lafehubert/electronics/README.md

# electronics
A place for info and code relating to my electronics projects
