lafehubert/electronics/ya4b/README.md

Here be schematics and PCB designs for YA4B, the 4-bit computer I'm designing.

I use KiCad (https://www.kicad-pcb.org/) for the designs, and an Arduino Mega 2560 to run the test code.
