lafehubert/electronics/ya4b/address-register/address-register-bank/address-register-bank.pdf

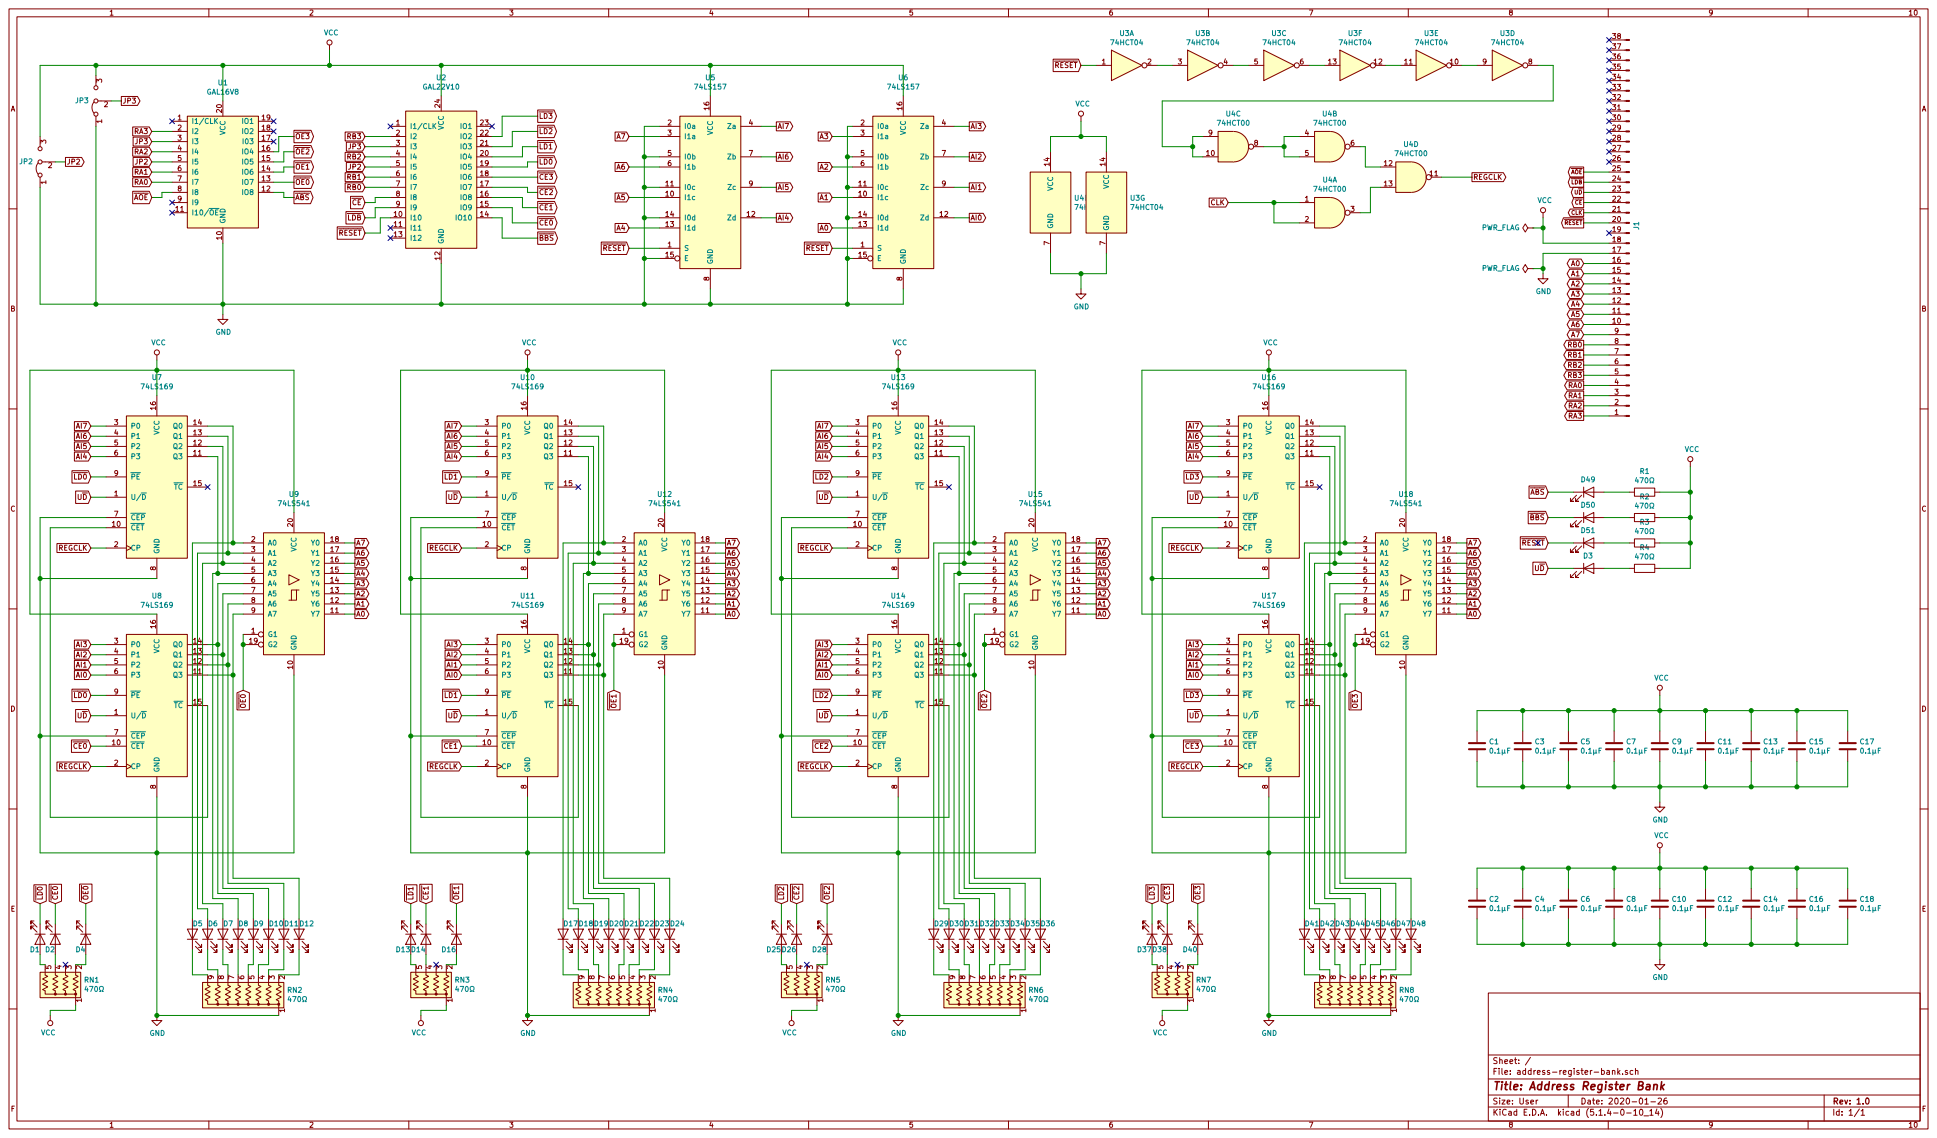
[picture p1: page 1]

File: address-register-bank.sch Sheet: / GND 10 VCC 20

Id: 1/1 Title: Address Register Bank
