lafehubert/electronics/ya4b/alu/designs/74LS382/ya4b-alu/ya4b-alu.kicad_pcb

## KiCad design ya4b/alu/designs/74LS382/ya4b-alu/ya4b-alu.kicad_pcb (2022-01-08)

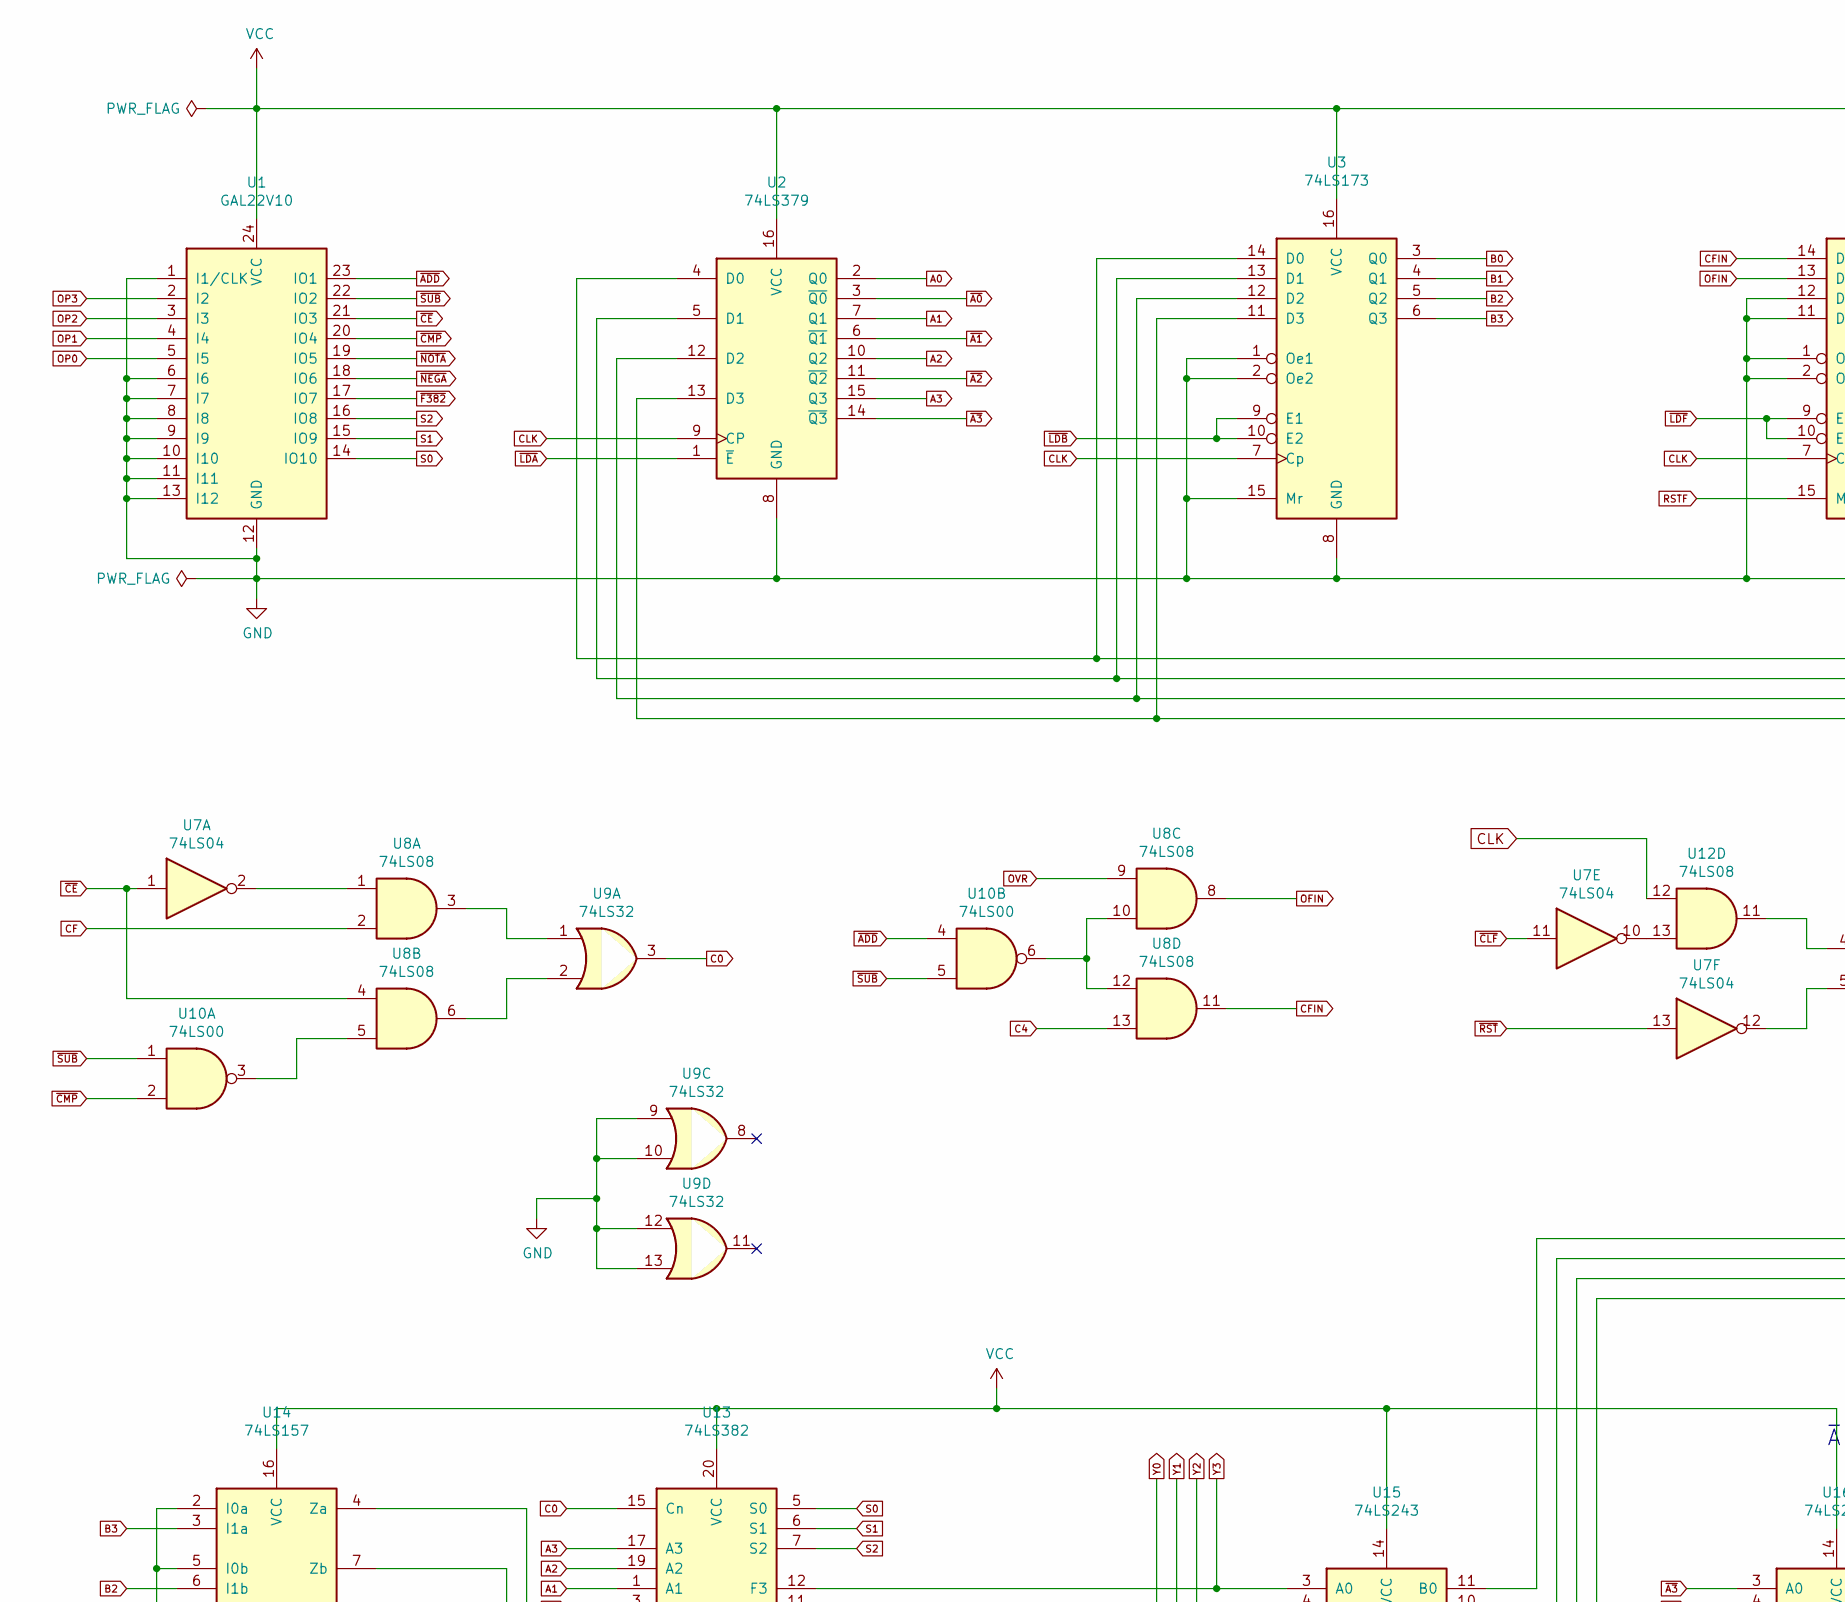
[picture p2: schematic ya4b-alu.sch, Ya4b Arithmetic Logic Unit, part in row 1, column 1]

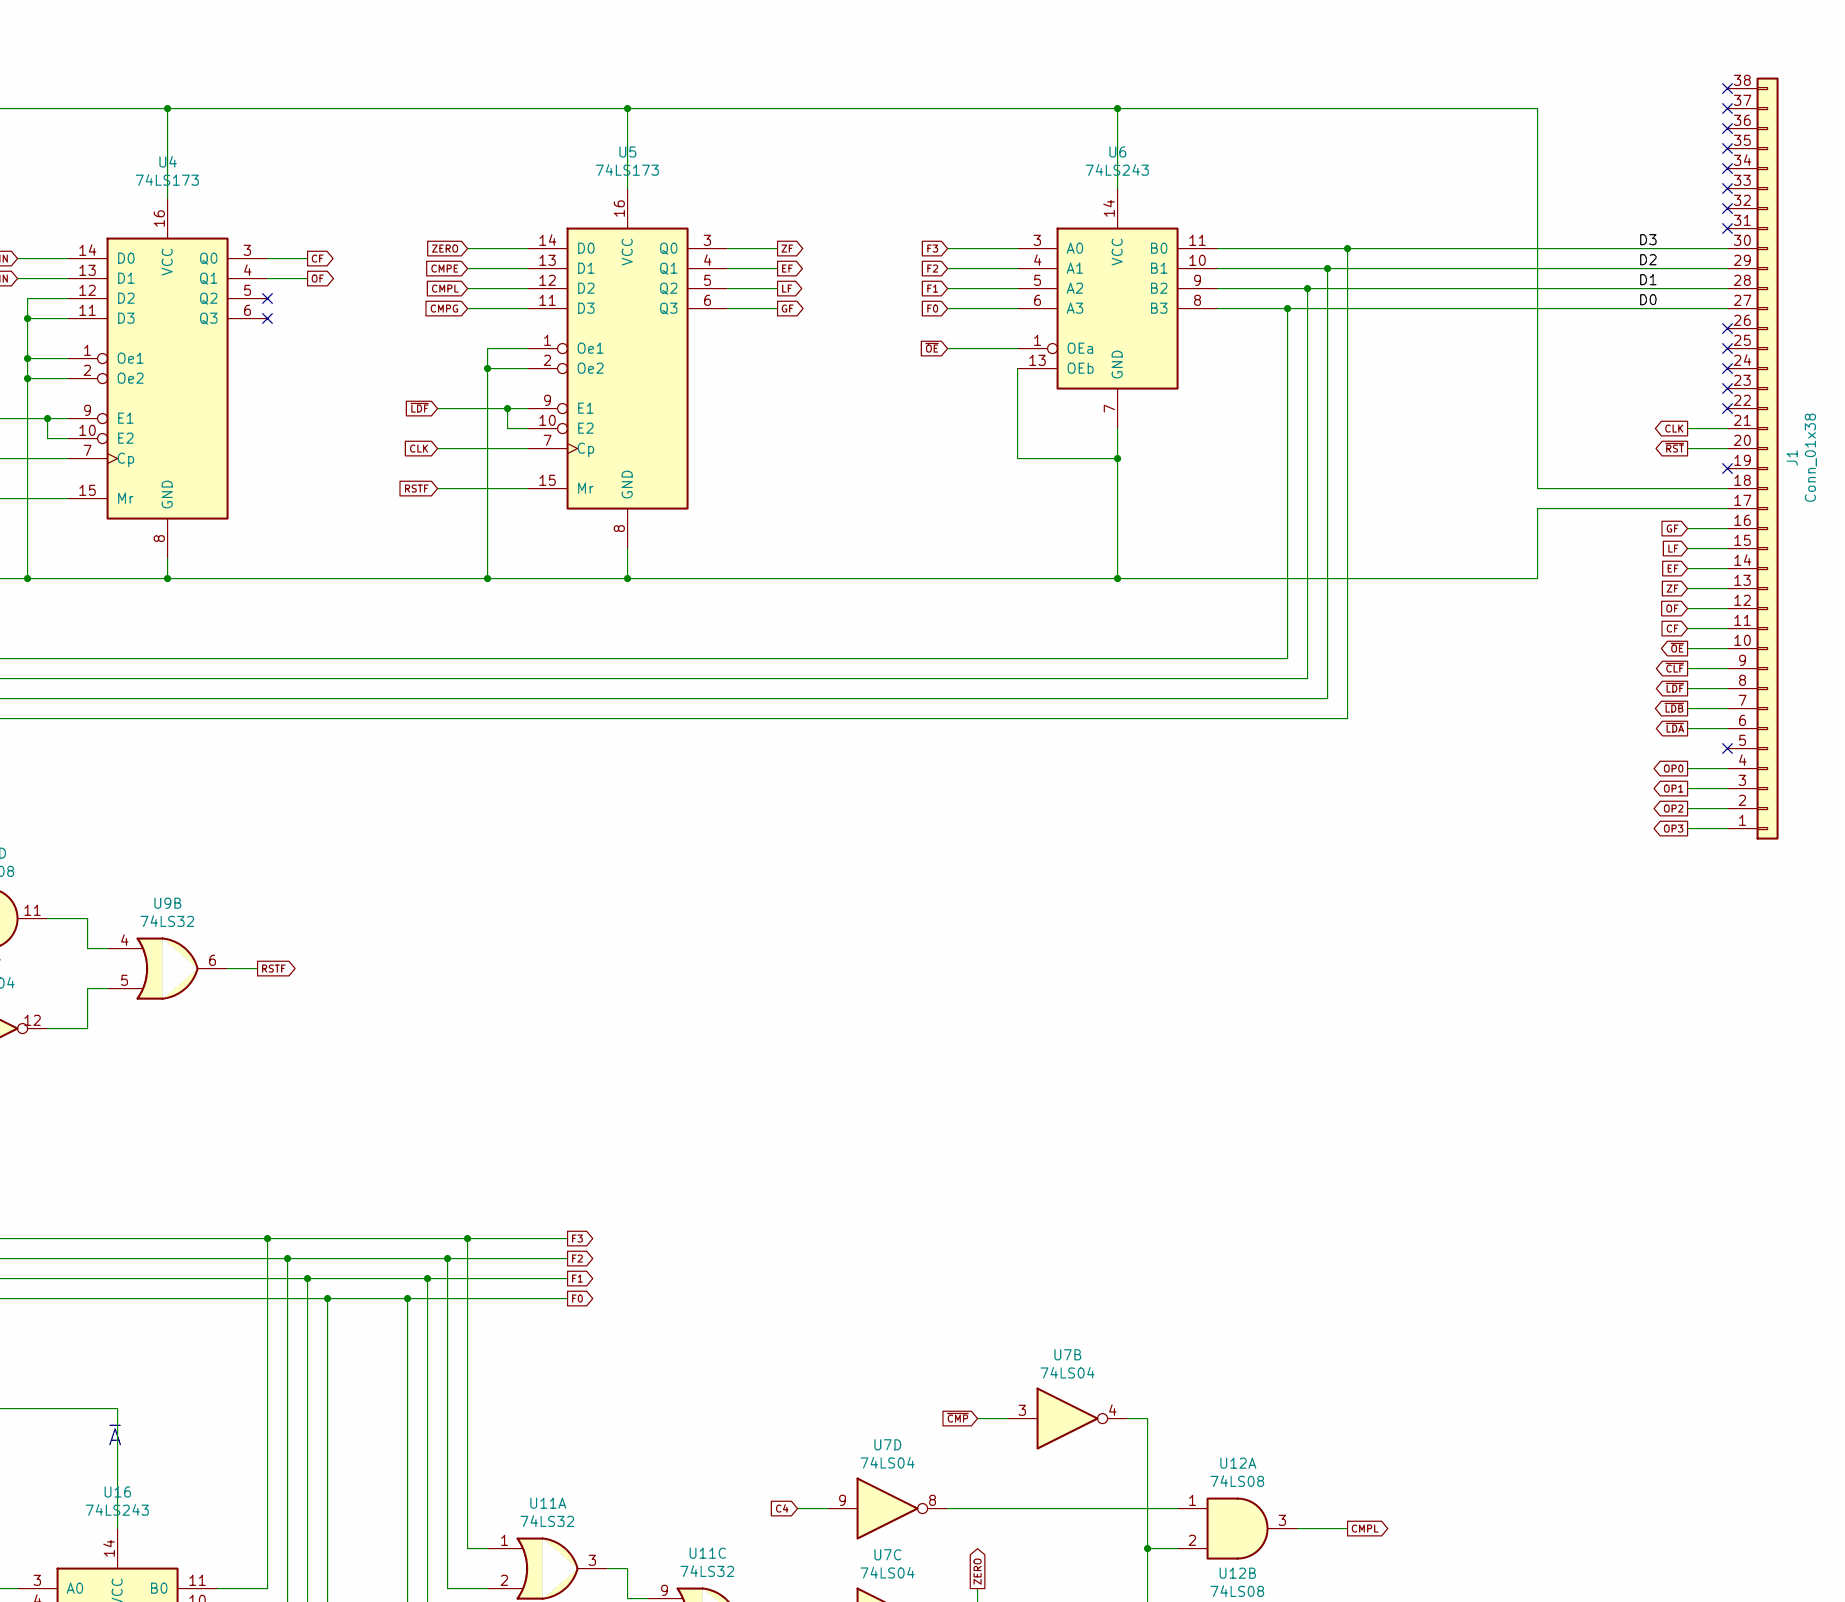
[picture p3: schematic ya4b-alu.sch, Ya4b Arithmetic Logic Unit, part in row 1, column 2]

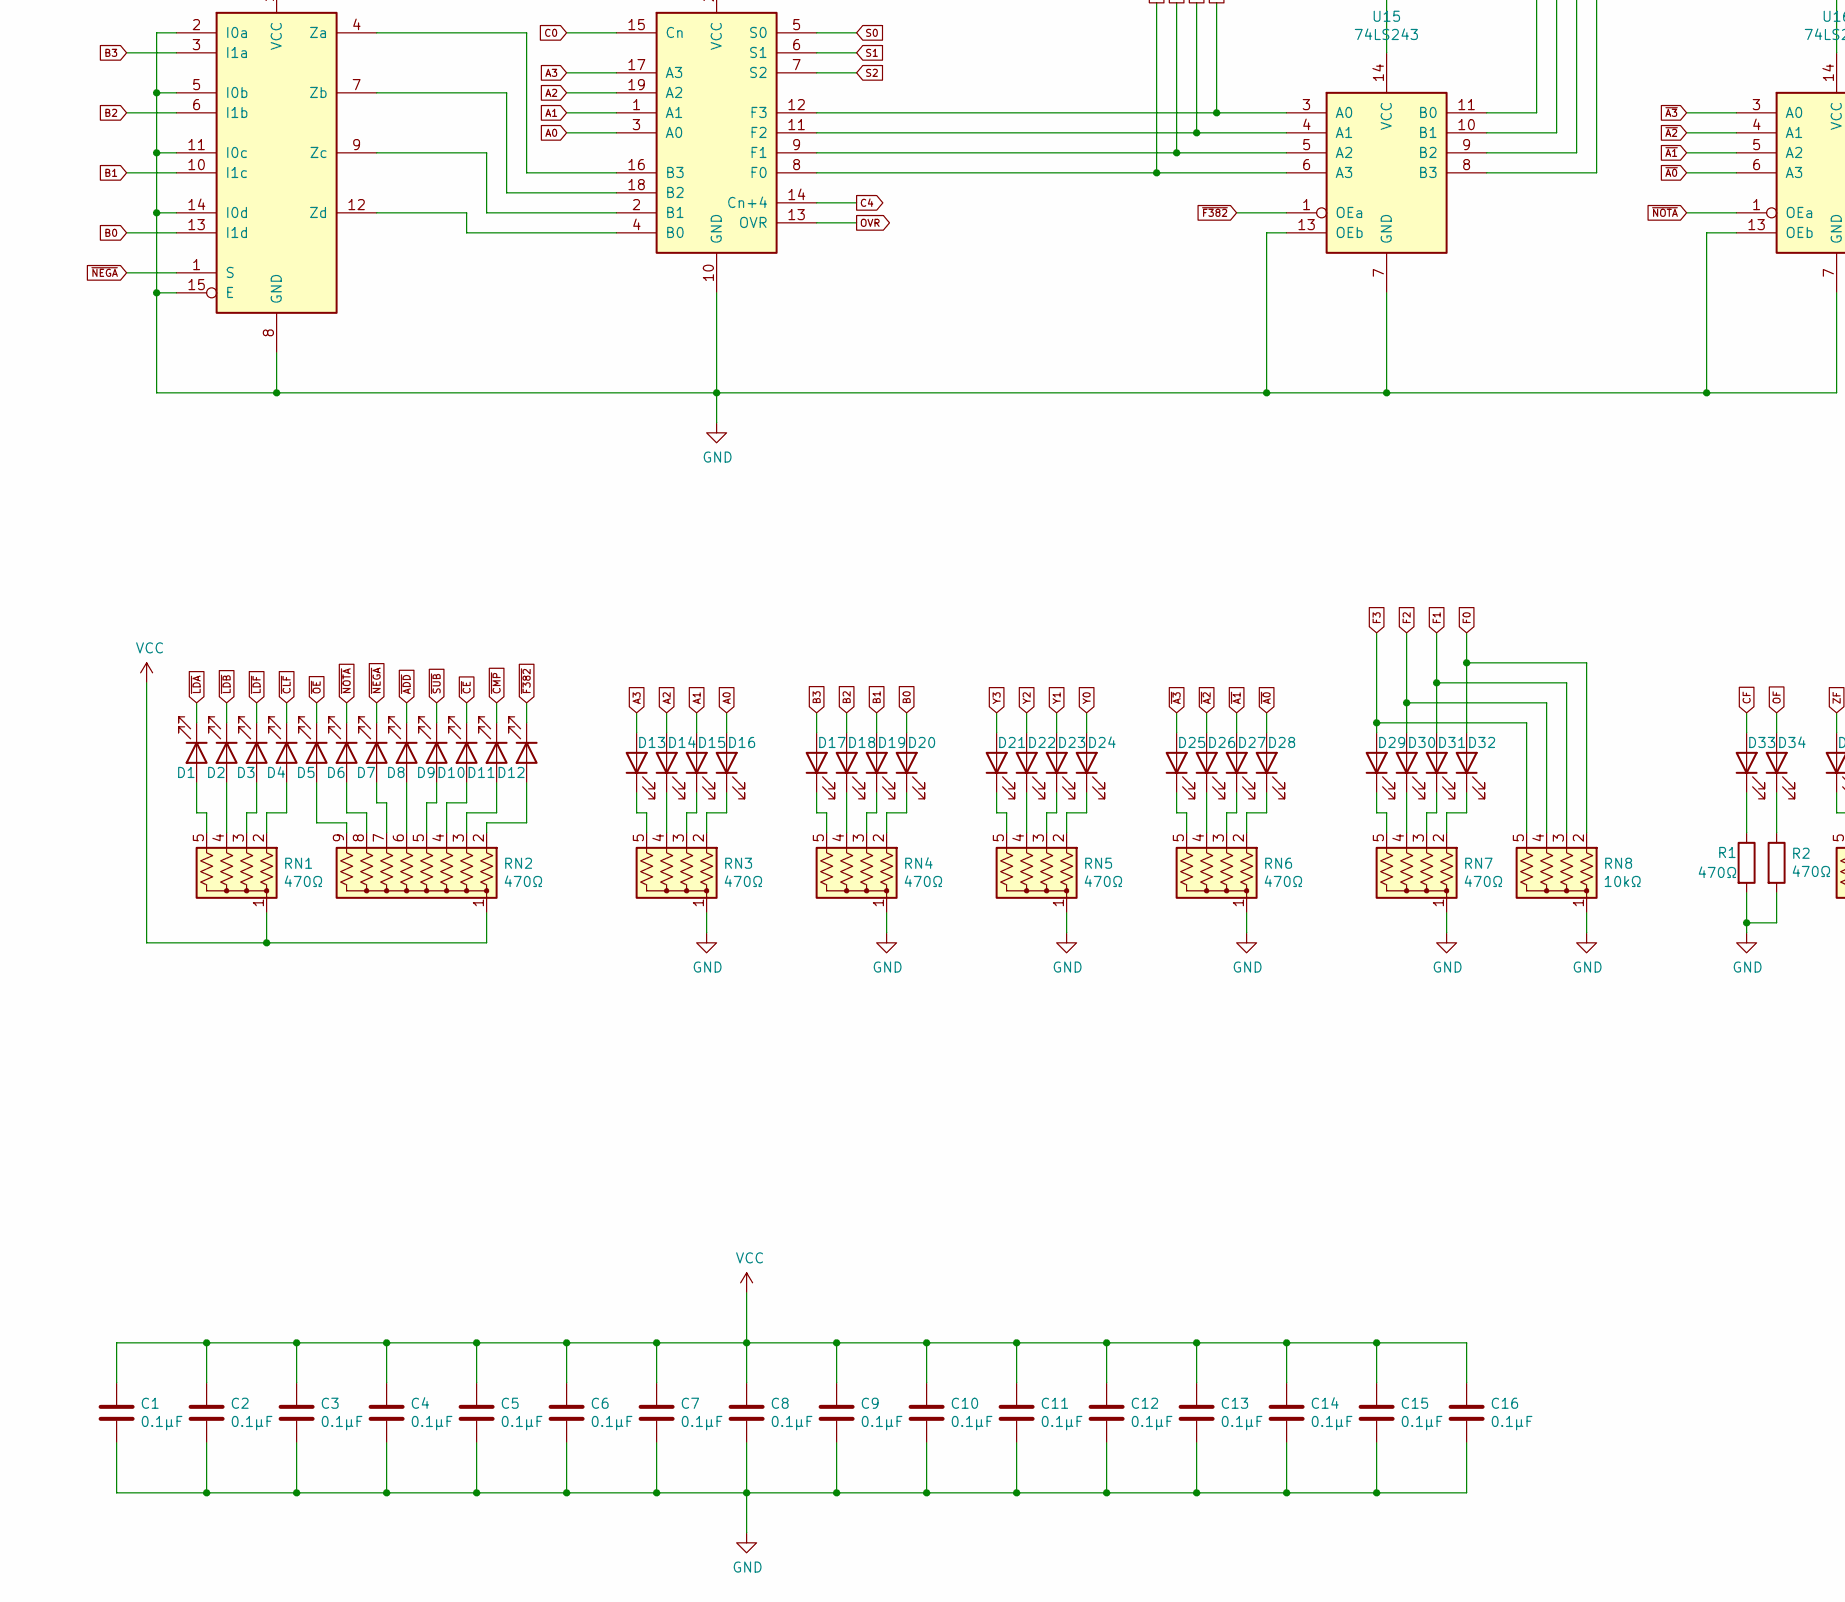
[picture p4: schematic ya4b-alu.sch, Ya4b Arithmetic Logic Unit, part in row 2, column 1]

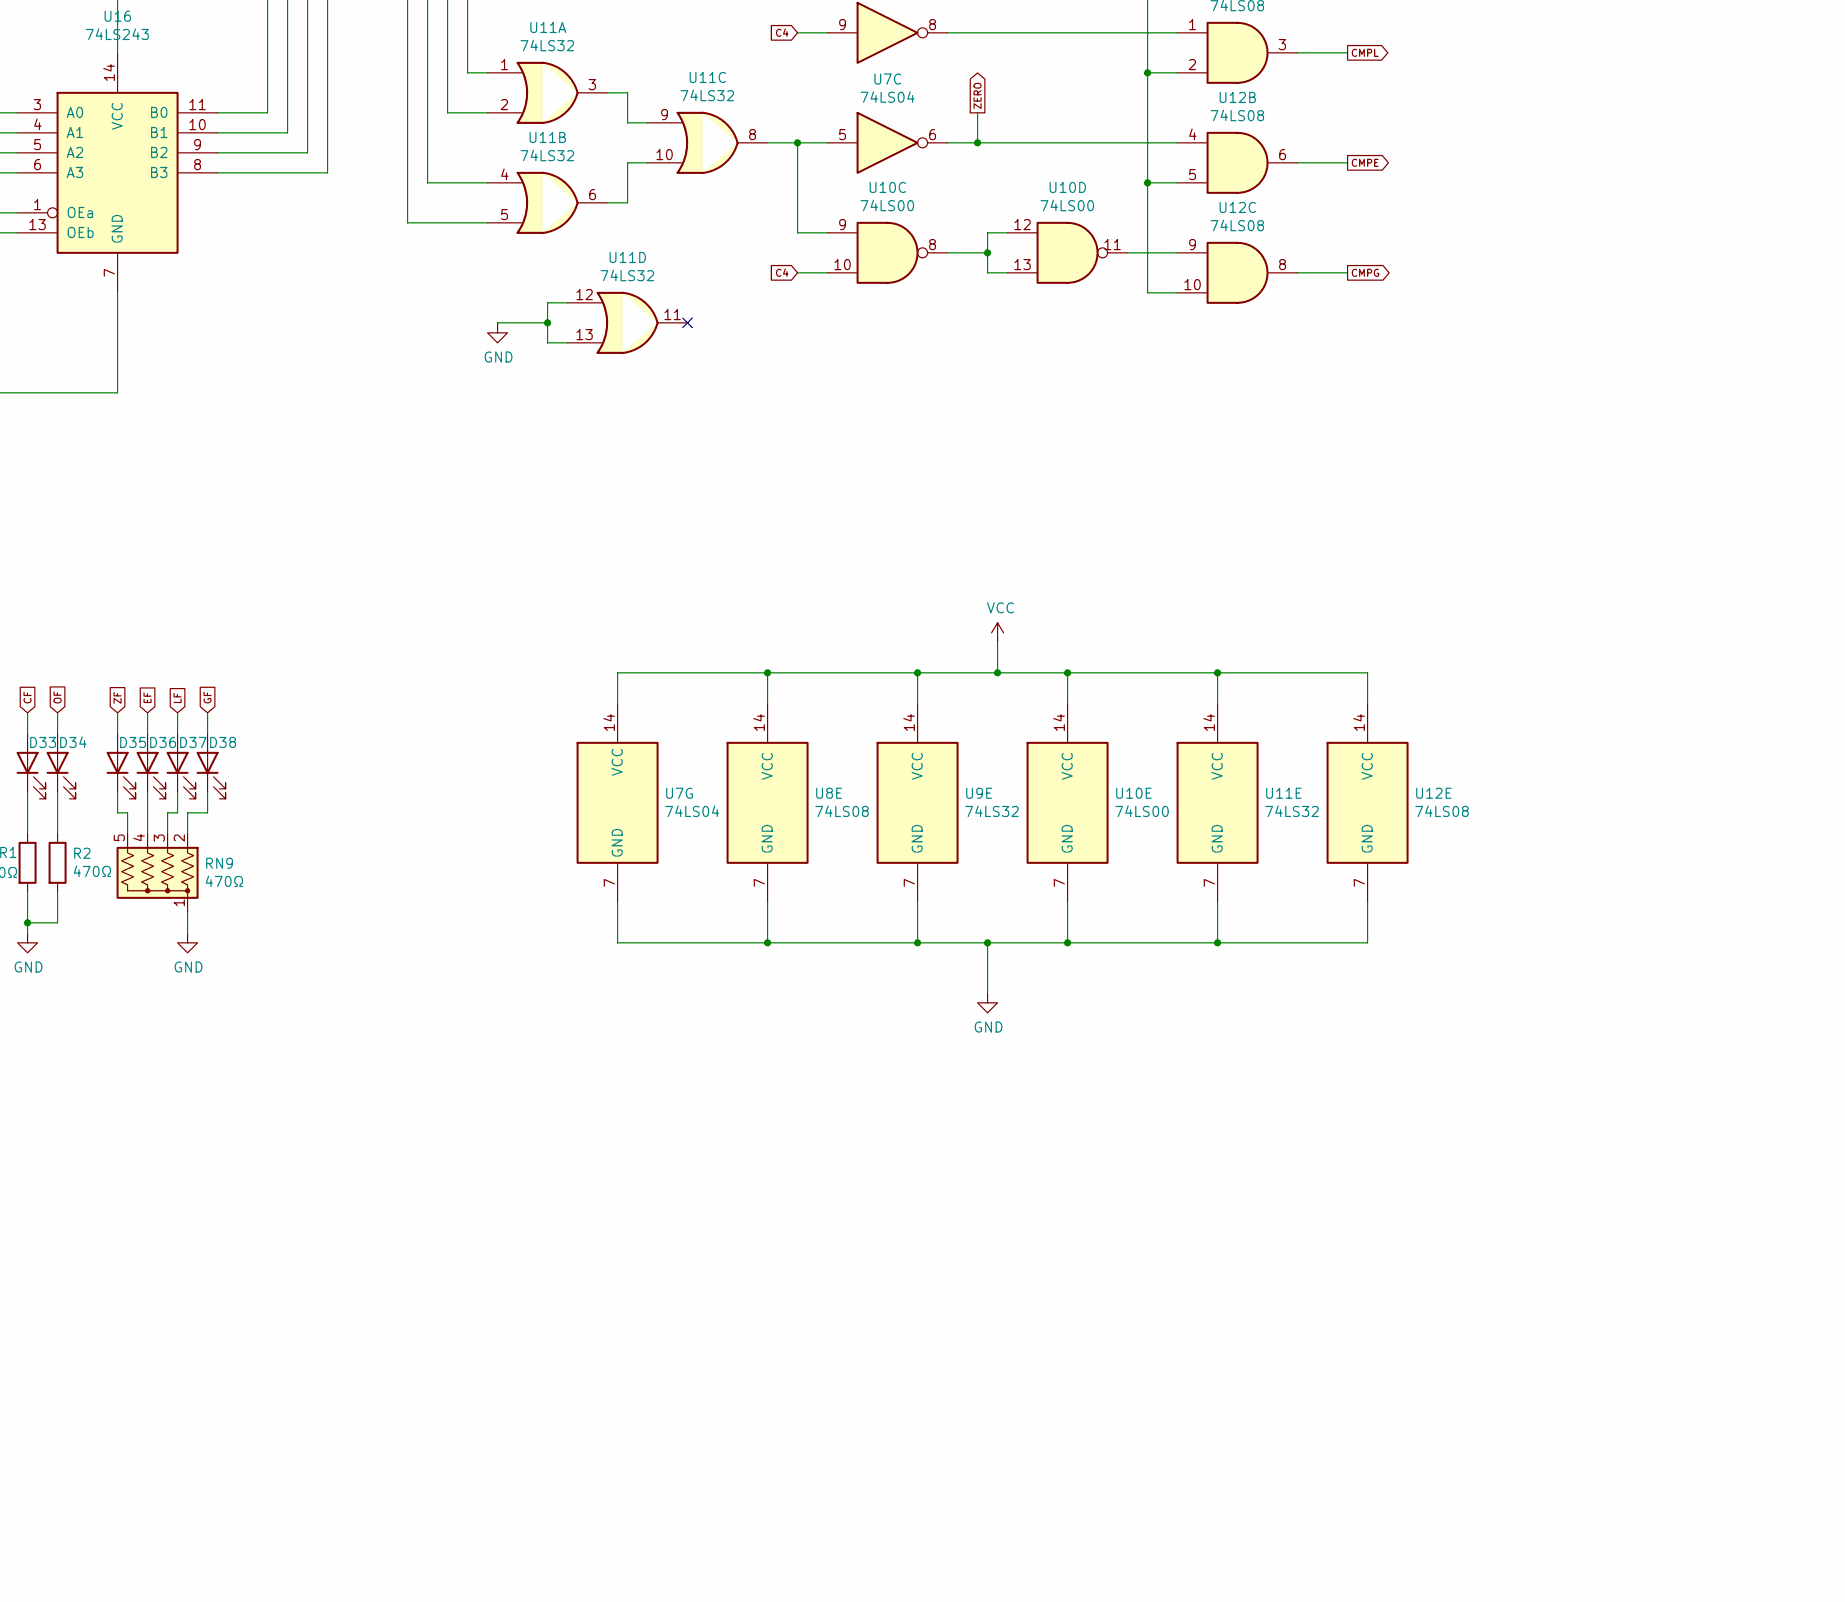
[picture p5: schematic ya4b-alu.sch, Ya4b Arithmetic Logic Unit, part in row 2, column 2]

Parts:
C1, C2, C3, C4, C5, C6, C7, C8, C9, C10, C11, C12, C13, C14, C15, C16: 0.1µF; C_Disc_D3.0mm_W1.6mm_P2.50mm
D1, D2, D3, D4, D5, D6, D7, D8, D9, D10, D11, D12, D13, D14, D15, D16, D17, D18, D19, D20, D21, D22, D23, D24, D25, D26, D27, D28, D29, D30, D31, D32, D33, D34, D35, D36, D37, D38: LED; LED_Rectangular_W5.0mm_H2.0mm
J1: Conn_01x38; PinHeader_1x38_P2.54mm_Vertical
R1, R2: 470Ω; R_Axial_DIN0207_L6.3mm_D2.5mm_P10.16mm_Horizontal
RN1, RN3, RN4, RN5, RN6, RN7, RN9: 470Ω; R_Array_SIP5
RN2: 470Ω; R_Array_SIP9
RN8: 10kΩ; R_Array_SIP5
U1: GAL22V10; DIP-24_W7.62mm_Socket
U2: 74LS379; DIP-16_W7.62mm_Socket
U3, U4, U5: 74LS173; DIP-16_W7.62mm_Socket
U6, U15, U16: 74LS243; DIP-14_W7.62mm_Socket
U7: 74LS04; DIP-14_W7.62mm_Socket
U8, U12: 74LS08; DIP-14_W7.62mm_Socket
U9, U11: 74LS32; DIP-14_W7.62mm_Socket
U10: 74LS00; DIP-14_W7.62mm_Socket
U13: 74LS382; DIP-20_W7.62mm_Socket
U14: 74LS157; DIP-16_W7.62mm_Socket

Connections:
/D0: J1.27, U2.4 (D0), U3.14 (D0), U6.8 (B3)
/D1: J1.28, U2.5 (D1), U3.13 (D1), U6.9 (B2)
/D2: J1.29, U2.12 (D2), U3.12 (D2), U6.10 (B1)
/D3: J1.30, U2.13 (D3), U3.11 (D3), U6.11 (B0)
A0: D16.2 (A), U2.2 (Q0), U13.3 (A0)
A1: D15.2 (A), U2.7 (Q1), U13.1 (A1)
A2: D14.2 (A), U2.10 (Q2), U13.19 (A2)
A3: D13.2 (A), U2.15 (Q3), U13.17 (A3)
B0: D20.2 (A), U3.3 (Q0), U14.13 (I1d)
B1: D19.2 (A), U3.4 (Q1), U14.10 (I1c)
B2: D18.2 (A), U3.5 (Q2), U14.6 (I1b)
B3: D17.2 (A), U3.6 (Q3), U14.3 (I1a)
C0: U9.3, U13.15 (Cn)
C4: U7.9, U8.13, U10.10, U13.14 (Cn+4)
CF: D33.2 (A), J1.11, U4.3 (Q0), U8.2
CFIN: U4.14 (D0), U8.11
CLK: J1.21, U2.9 (CP), U3.7 (Cp), U4.7 (Cp), U5.7 (Cp), U12.12
CMPE: U5.13 (D1), U12.6
CMPG: U5.11 (D3), U12.8
CMPL: U5.12 (D2), U12.3
EF: D36.2 (A), J1.14, U5.4 (Q1)
F0: D32.2 (A), RN8.2 (R1), U6.6 (A3), U11.5, U15.8 (B3), U16.8 (B3)
F1: D31.2 (A), RN8.3 (R2), U6.5 (A2), U11.4, U15.9 (B2), U16.9 (B2)
F2: D30.2 (A), RN8.4 (R3), U6.4 (A1), U11.2, U15.10 (B1), U16.10 (B1)
F3: D29.2 (A), RN8.5 (R4), U6.3 (A0), U11.1, U15.11 (B0), U16.11 (B0)
GF: D38.2 (A), J1.16, U5.6 (Q3)
GND: C1.2, C2.2, C3.2, C4.2, C5.2, C6.2, C7.2, C8.2, C9.2, C10.2, C11.2, C12.2, C13.2, C14.2, C15.2, C16.2, J1.17, R1.2, R2.2, RN3.1 (common), RN4.1 (common), RN5.1 (common), RN6.1 (common), RN7.1 (common), RN8.1 (common), RN9.1 (common), U1.1 (I1/CLK), U1.6 (I6), U1.7 (I7), U1.8 (I8), U1.9 (I9), U1.10 (I10), U1.11 (I11), U1.12 (GND), U1.13 (I12), U2.8 (GND), U3.1 (Oe1), U3.2 (Oe2), U3.8 (GND), U3.15 (Mr), U4.1 (Oe1), U4.2 (Oe2), U4.8 (GND), U4.11 (D3), U4.12 (D2), U5.1 (Oe1), U5.2 (Oe2), U5.8 (GND), U6.7 (GND), U6.13 (OEb), U7.7 (GND), U8.7 (GND), U9.7 (GND), U9.9, U9.10, U9.12, U9.13, U10.7 (GND), U11.7 (GND), U11.12, U11.13, U12.7 (GND), U13.10 (GND), U14.2 (I0a), U14.5 (I0b), U14.8 (GND), U14.11 (I0c), U14.14 (I0d), U14.15 (E), U15.7 (GND), U15.13 (OEb), U16.7 (GND), U16.13 (OEb)
LF: D37.2 (A), J1.15, U5.5 (Q2)
unnamed: D1.2 (A), RN1.5 (R4)
unnamed: D2.2 (A), RN1.4 (R3)
unnamed: D3.2 (A), RN1.3 (R2)
unnamed: D4.2 (A), RN1.2 (R1)
unnamed: D5.2 (A), RN2.9 (R8)
unnamed: D6.2 (A), RN2.8 (R7)
unnamed: D7.2 (A), RN2.7 (R6)
unnamed: D8.2 (A), RN2.6 (R5)
unnamed: D9.2 (A), RN2.5 (R4)
unnamed: D10.2 (A), RN2.4 (R3)
unnamed: D11.2 (A), RN2.3 (R2)
unnamed: D12.2 (A), RN2.2 (R1)
unnamed: D13.1 (K), RN3.5 (R4)
unnamed: D14.1 (K), RN3.4 (R3)
unnamed: D15.1 (K), RN3.3 (R2)
unnamed: D16.1 (K), RN3.2 (R1)
unnamed: D17.1 (K), RN4.5 (R4)
unnamed: D18.1 (K), RN4.4 (R3)
unnamed: D19.1 (K), RN4.3 (R2)
unnamed: D20.1 (K), RN4.2 (R1)
unnamed: D21.1 (K), RN5.5 (R4)
unnamed: D22.1 (K), RN5.4 (R3)
unnamed: D23.1 (K), RN5.3 (R2)
unnamed: D24.1 (K), RN5.2 (R1)
unnamed: D25.1 (K), RN6.5 (R4)
unnamed: D26.1 (K), RN6.4 (R3)
unnamed: D27.1 (K), RN6.3 (R2)
unnamed: D28.1 (K), RN6.2 (R1)
unnamed: D29.1 (K), RN7.5 (R4)
unnamed: D30.1 (K), RN7.4 (R3)
unnamed: D31.1 (K), RN7.3 (R2)
unnamed: D32.1 (K), RN7.2 (R1)
unnamed: D33.1 (K), R1.1
unnamed: D34.1 (K), R2.1
unnamed: D35.1 (K), RN9.5 (R4)
unnamed: D36.1 (K), RN9.4 (R3)
unnamed: D37.1 (K), RN9.3 (R2)
unnamed: D38.1 (K), RN9.2 (R1)
unnamed: U7.2, U8.1
unnamed: U7.12, U9.5
unnamed: U8.3, U9.1
unnamed: U8.6, U9.2
unnamed: U8.5, U10.3
unnamed: U8.10, U8.12, U10.6
unnamed: U7.5, U10.9, U11.8
unnamed: U10.11, U12.9
unnamed: U10.8, U10.12, U10.13
unnamed: U11.3, U11.9
unnamed: U11.6, U11.10
unnamed: U7.8, U12.1
unnamed: U7.4, U12.2, U12.5, U12.10
unnamed: U9.4, U12.11
unnamed: U7.10, U12.13
unnamed: U13.2 (B1), U14.9 (Zc)
unnamed: U13.4 (B0), U14.12 (Zd)
unnamed: U13.16 (B3), U14.4 (Za)
unnamed: U13.18 (B2), U14.7 (Zb)
OF: D34.2 (A), J1.12, U4.4 (Q1)
OFIN: U4.13 (D1), U8.8
OP0: J1.4, U1.5 (I5)
OP1: J1.3, U1.4 (I4)
OP2: J1.2, U1.3 (I3)
OP3: J1.1, U1.2 (I2)
OVR: U8.9, U13.13 (OVR)
RSTF: U4.15 (Mr), U5.15 (Mr), U9.6
S0: U1.14 (IO10), U13.5 (S0)
S1: U1.15 (IO9), U13.6 (S1)
S2: U1.16 (IO8), U13.7 (S2)
VCC: C1.1, C2.1, C3.1, C4.1, C5.1, C6.1, C7.1, C8.1, C9.1, C10.1, C11.1, C12.1, C13.1, C14.1, C15.1, C16.1, J1.18, RN1.1 (common), RN2.1 (common), U1.24 (VCC), U2.16 (VCC), U3.16 (VCC), U4.16 (VCC), U5.16 (VCC), U6.14 (VCC), U7.14 (VCC), U8.14 (VCC), U9.14 (VCC), U10.14 (VCC), U11.14 (VCC), U12.14 (VCC), U13.20 (VCC), U14.16 (VCC), U15.14 (VCC), U16.14 (VCC)
Y0: D24.2 (A), U13.8 (F0), U15.6 (A3)
Y1: D23.2 (A), U13.9 (F1), U15.5 (A2)
Y2: D22.2 (A), U13.11 (F2), U15.4 (A1)
Y3: D21.2 (A), U13.12 (F3), U15.3 (A0)
ZERO: U5.14 (D0), U7.6, U12.4
ZF: D35.2 (A), J1.13, U5.3 (Q0)
~A0: D28.2 (A), U2.3 (~Q0), U16.6 (A3)
~A1: D27.2 (A), U2.6 (~Q1), U16.5 (A2)
~A2: D26.2 (A), U2.11 (~Q2), U16.4 (A1)
~A3: D25.2 (A), U2.14 (~Q3), U16.3 (A0)
~ADD: D8.1 (K), U1.23 (IO1), U10.4
~CE: D10.1 (K), U1.21 (IO3), U7.1, U8.4
~CLF: D4.1 (K), J1.9, U7.11
~CMP: D11.1 (K), U1.20 (IO4), U7.3, U10.2
~F382: D12.1 (K), U1.17 (IO7), U15.1 (OEa)
~LDA: D1.1 (K), J1.6, U2.1 (~E)
~LDB: D2.1 (K), J1.7, U3.9 (E1), U3.10 (E2)
~LDF: D3.1 (K), J1.8, U4.9 (E1), U4.10 (E2), U5.9 (E1), U5.10 (E2)
~NEGA: D7.1 (K), U1.18 (IO6), U14.1 (S)
~NOTA: D6.1 (K), U1.19 (IO5), U16.1 (OEa)
~OE: D5.1 (K), J1.10, U6.1 (OEa)
~RST: J1.20, U7.13
~SUB: D9.1 (K), U1.22 (IO2), U10.1, U10.5

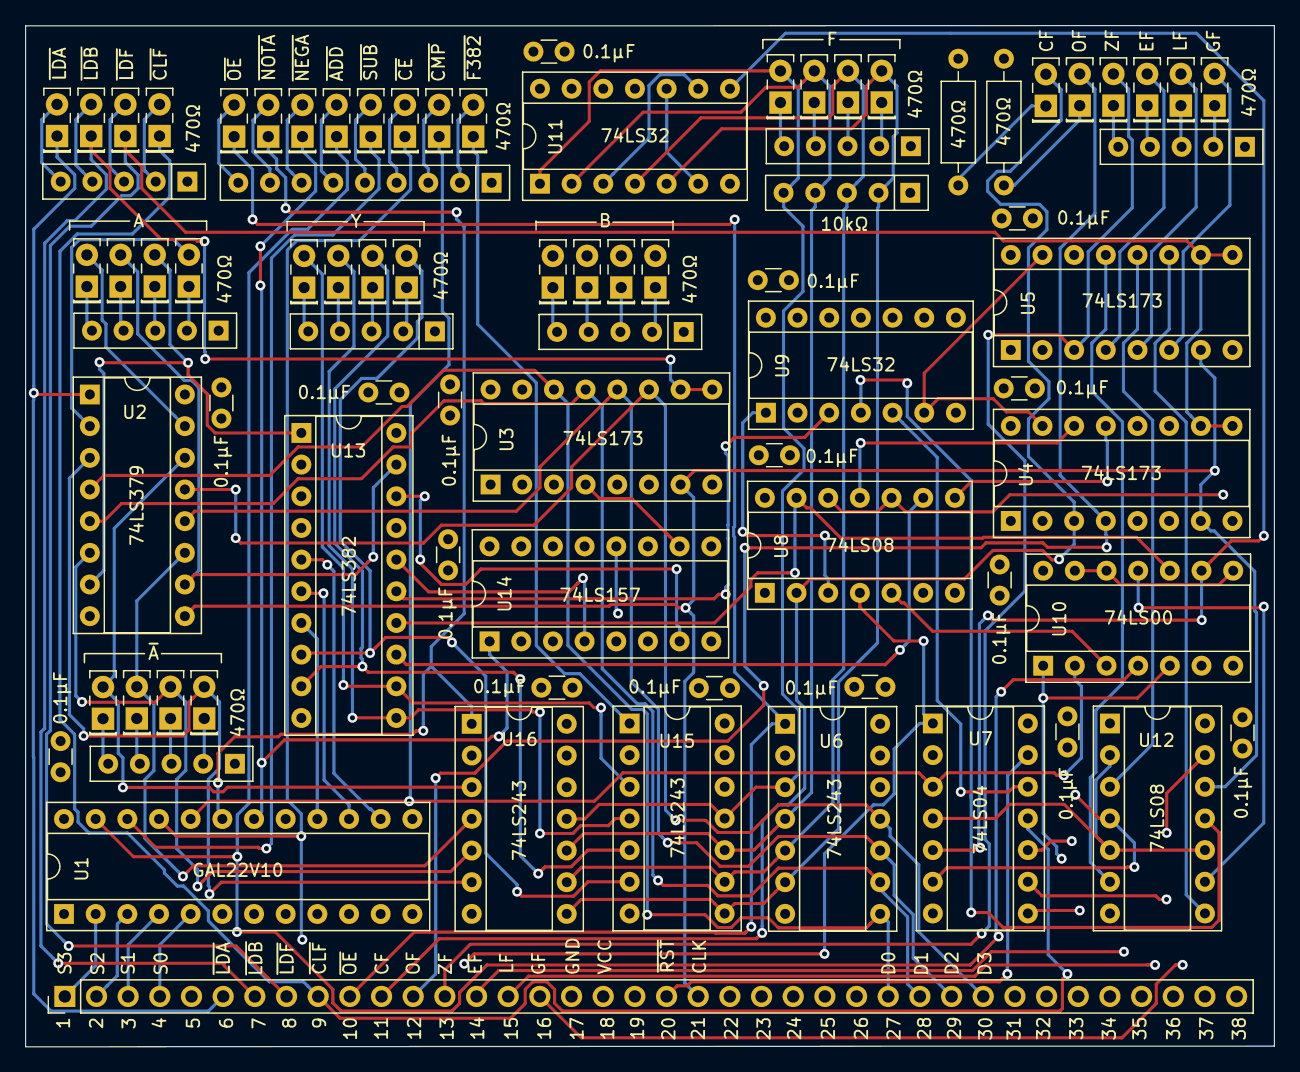
[picture p6: board ya4b/alu/designs/74LS382/ya4b-alu/ya4b-alu.kicad_pcb from above]

Board: 4 copper layers, 100.2 x 81.9 mm, 82 parts (0 on the bottom side), 120 nets.
