lafehubert/electronics/ya4b/alu/designs/ttl/ya4b-alu/ya4b-alu.kicad_pcb

## KiCad design ya4b/alu/designs/ttl/ya4b-alu/ya4b-alu.kicad_pcb (2022-01-08)

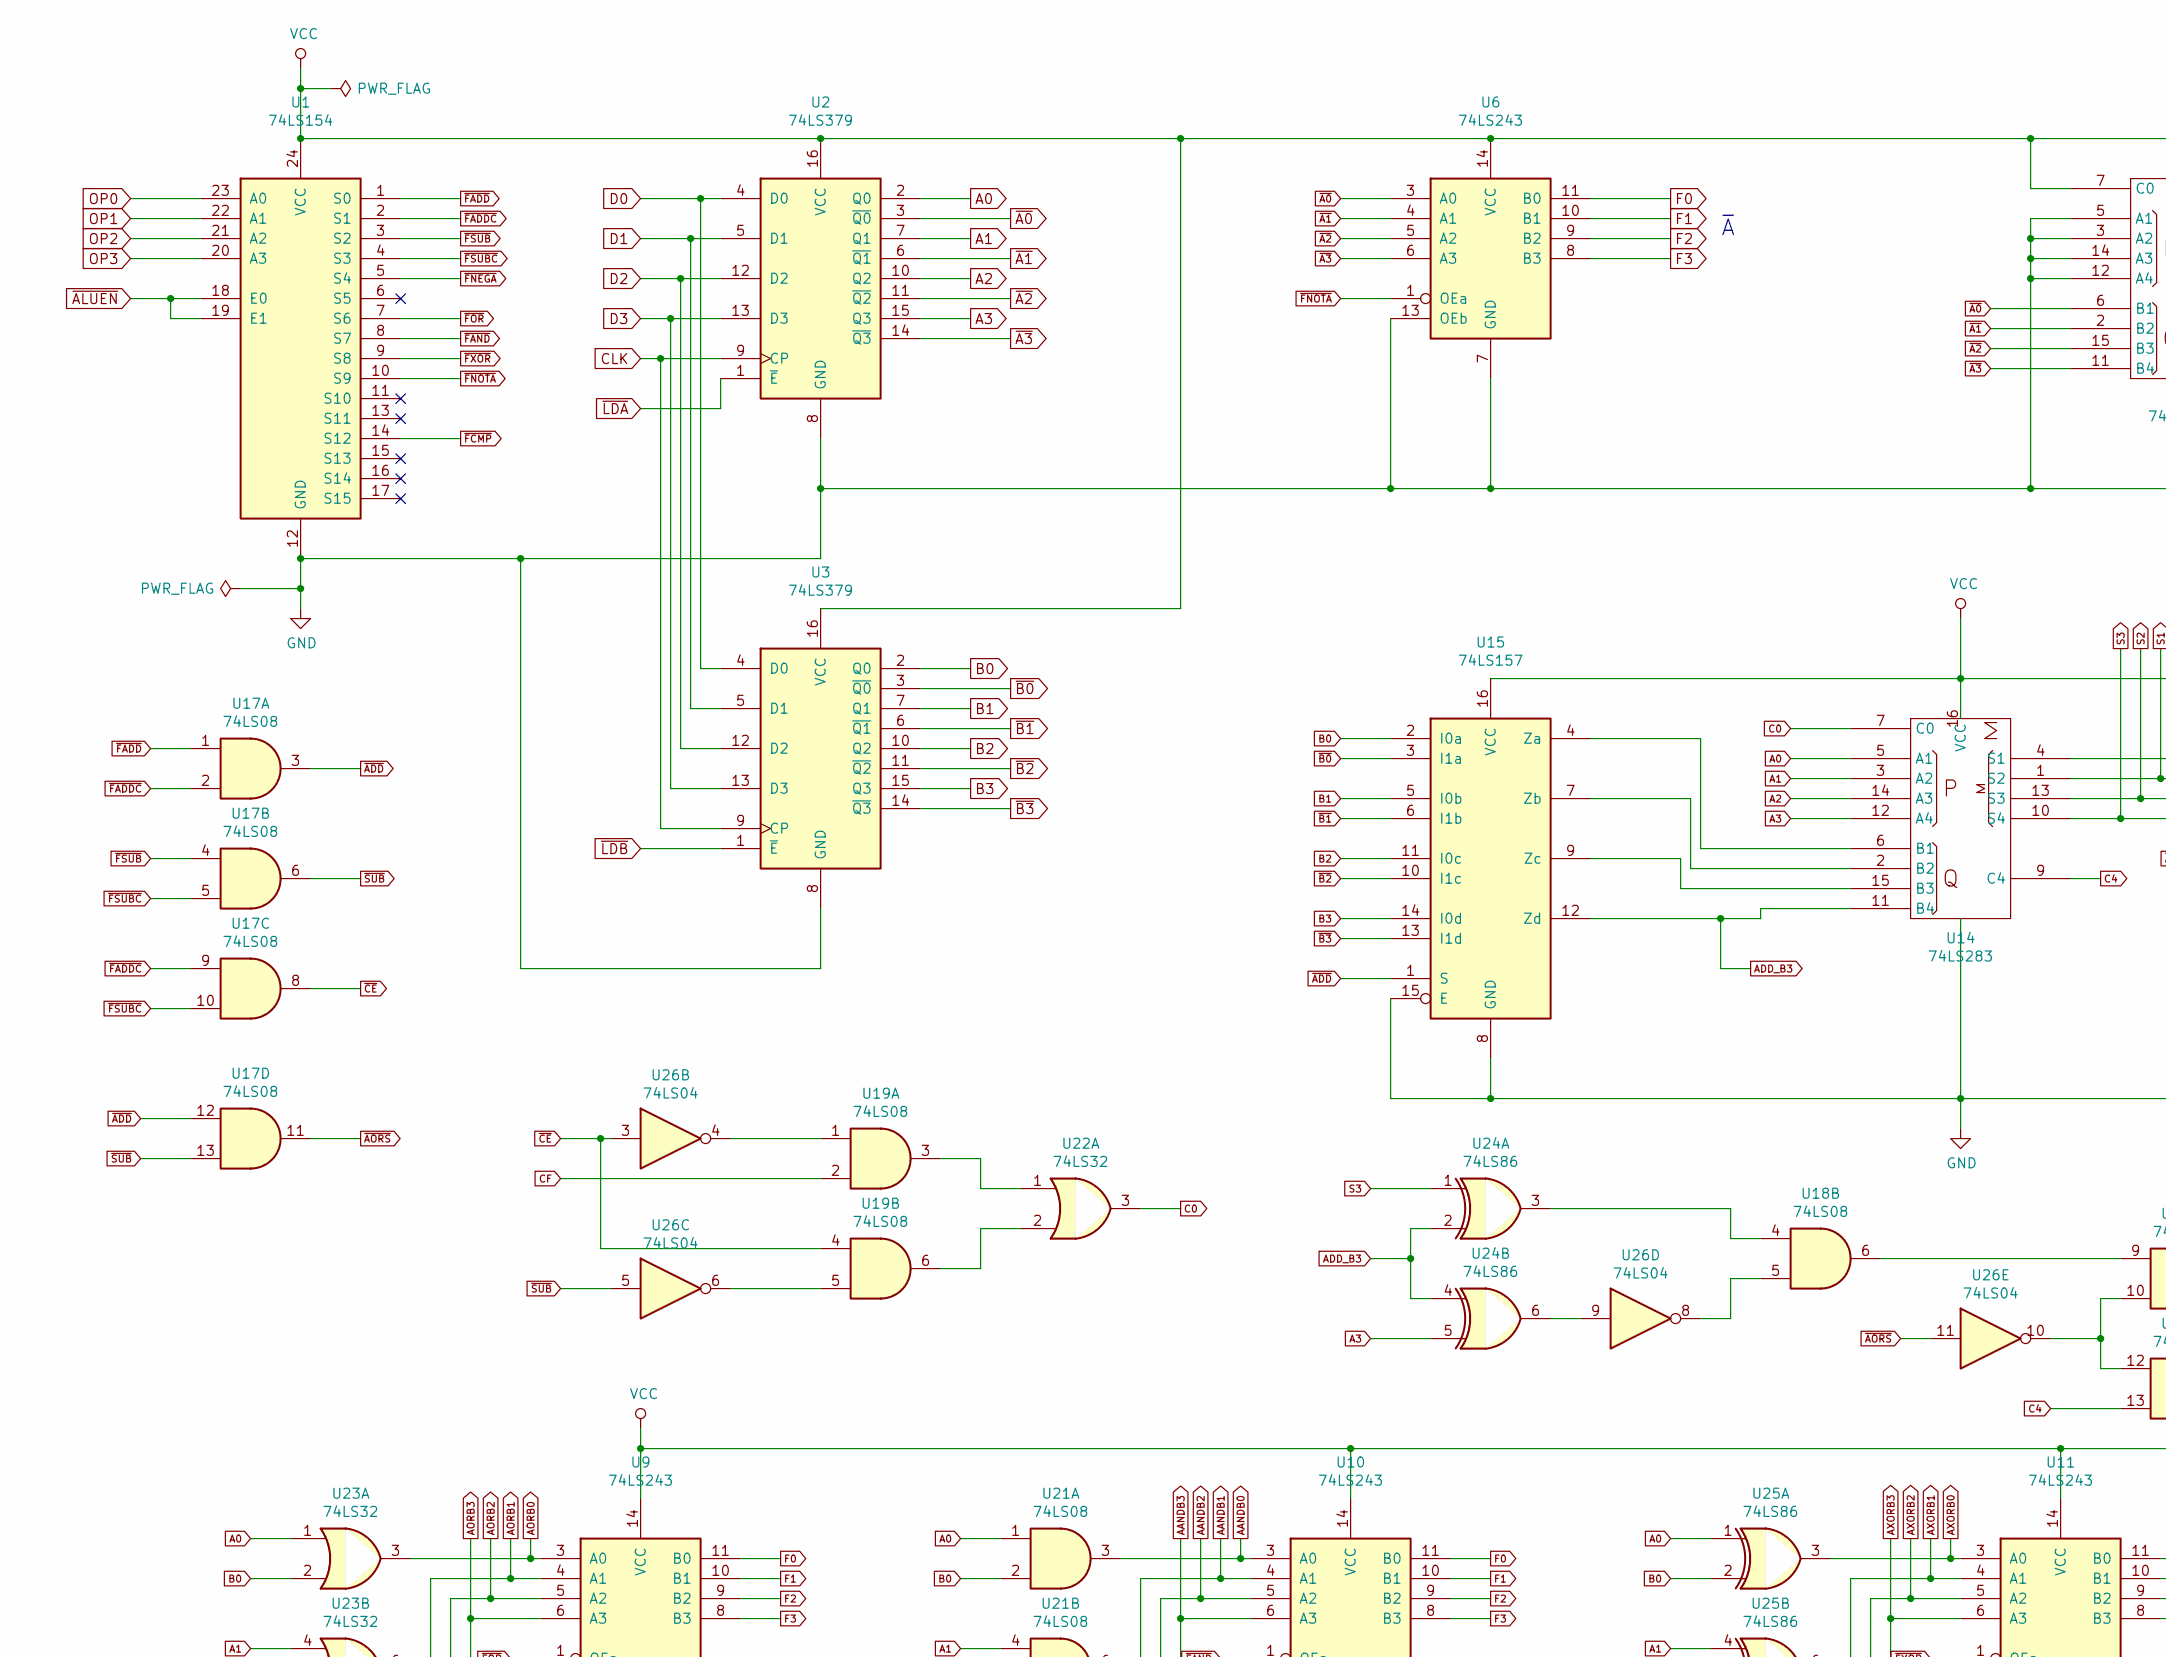
[picture p7: schematic ya4b-alu.sch, Ya4b Arithmetic Logic Unit, part in row 1, column 1]

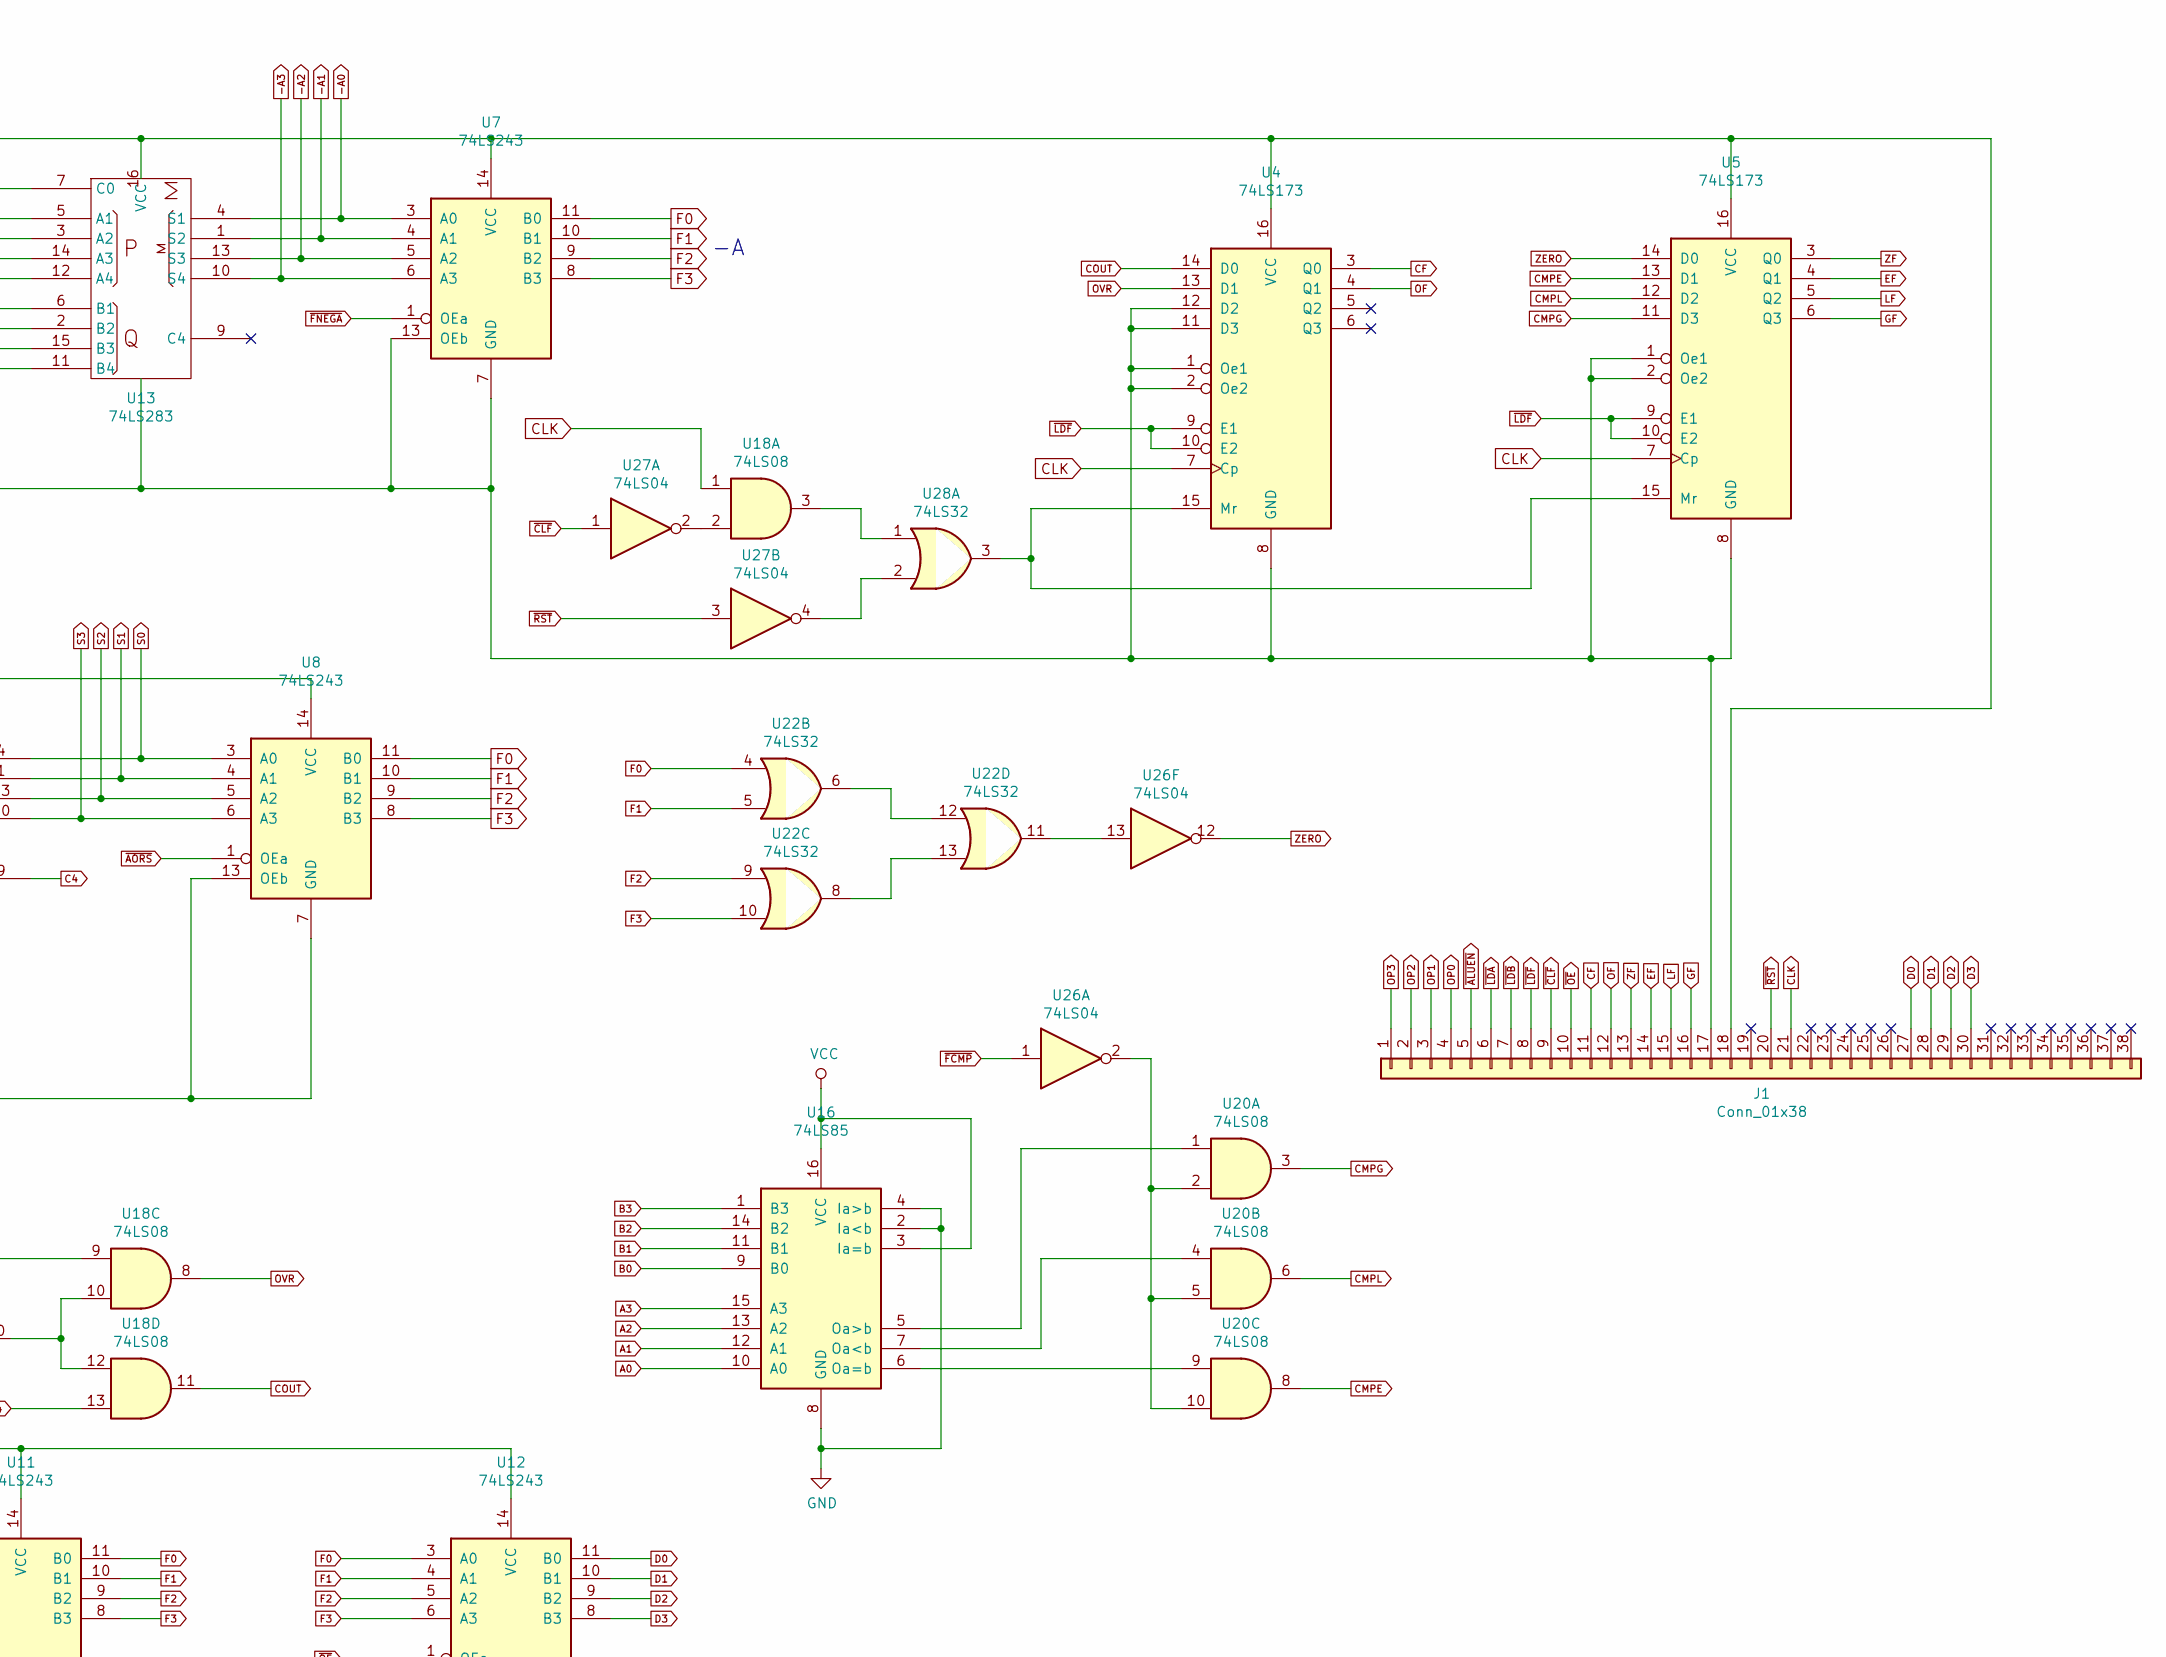
[picture p8: schematic ya4b-alu.sch, Ya4b Arithmetic Logic Unit, part in row 1, column 2]

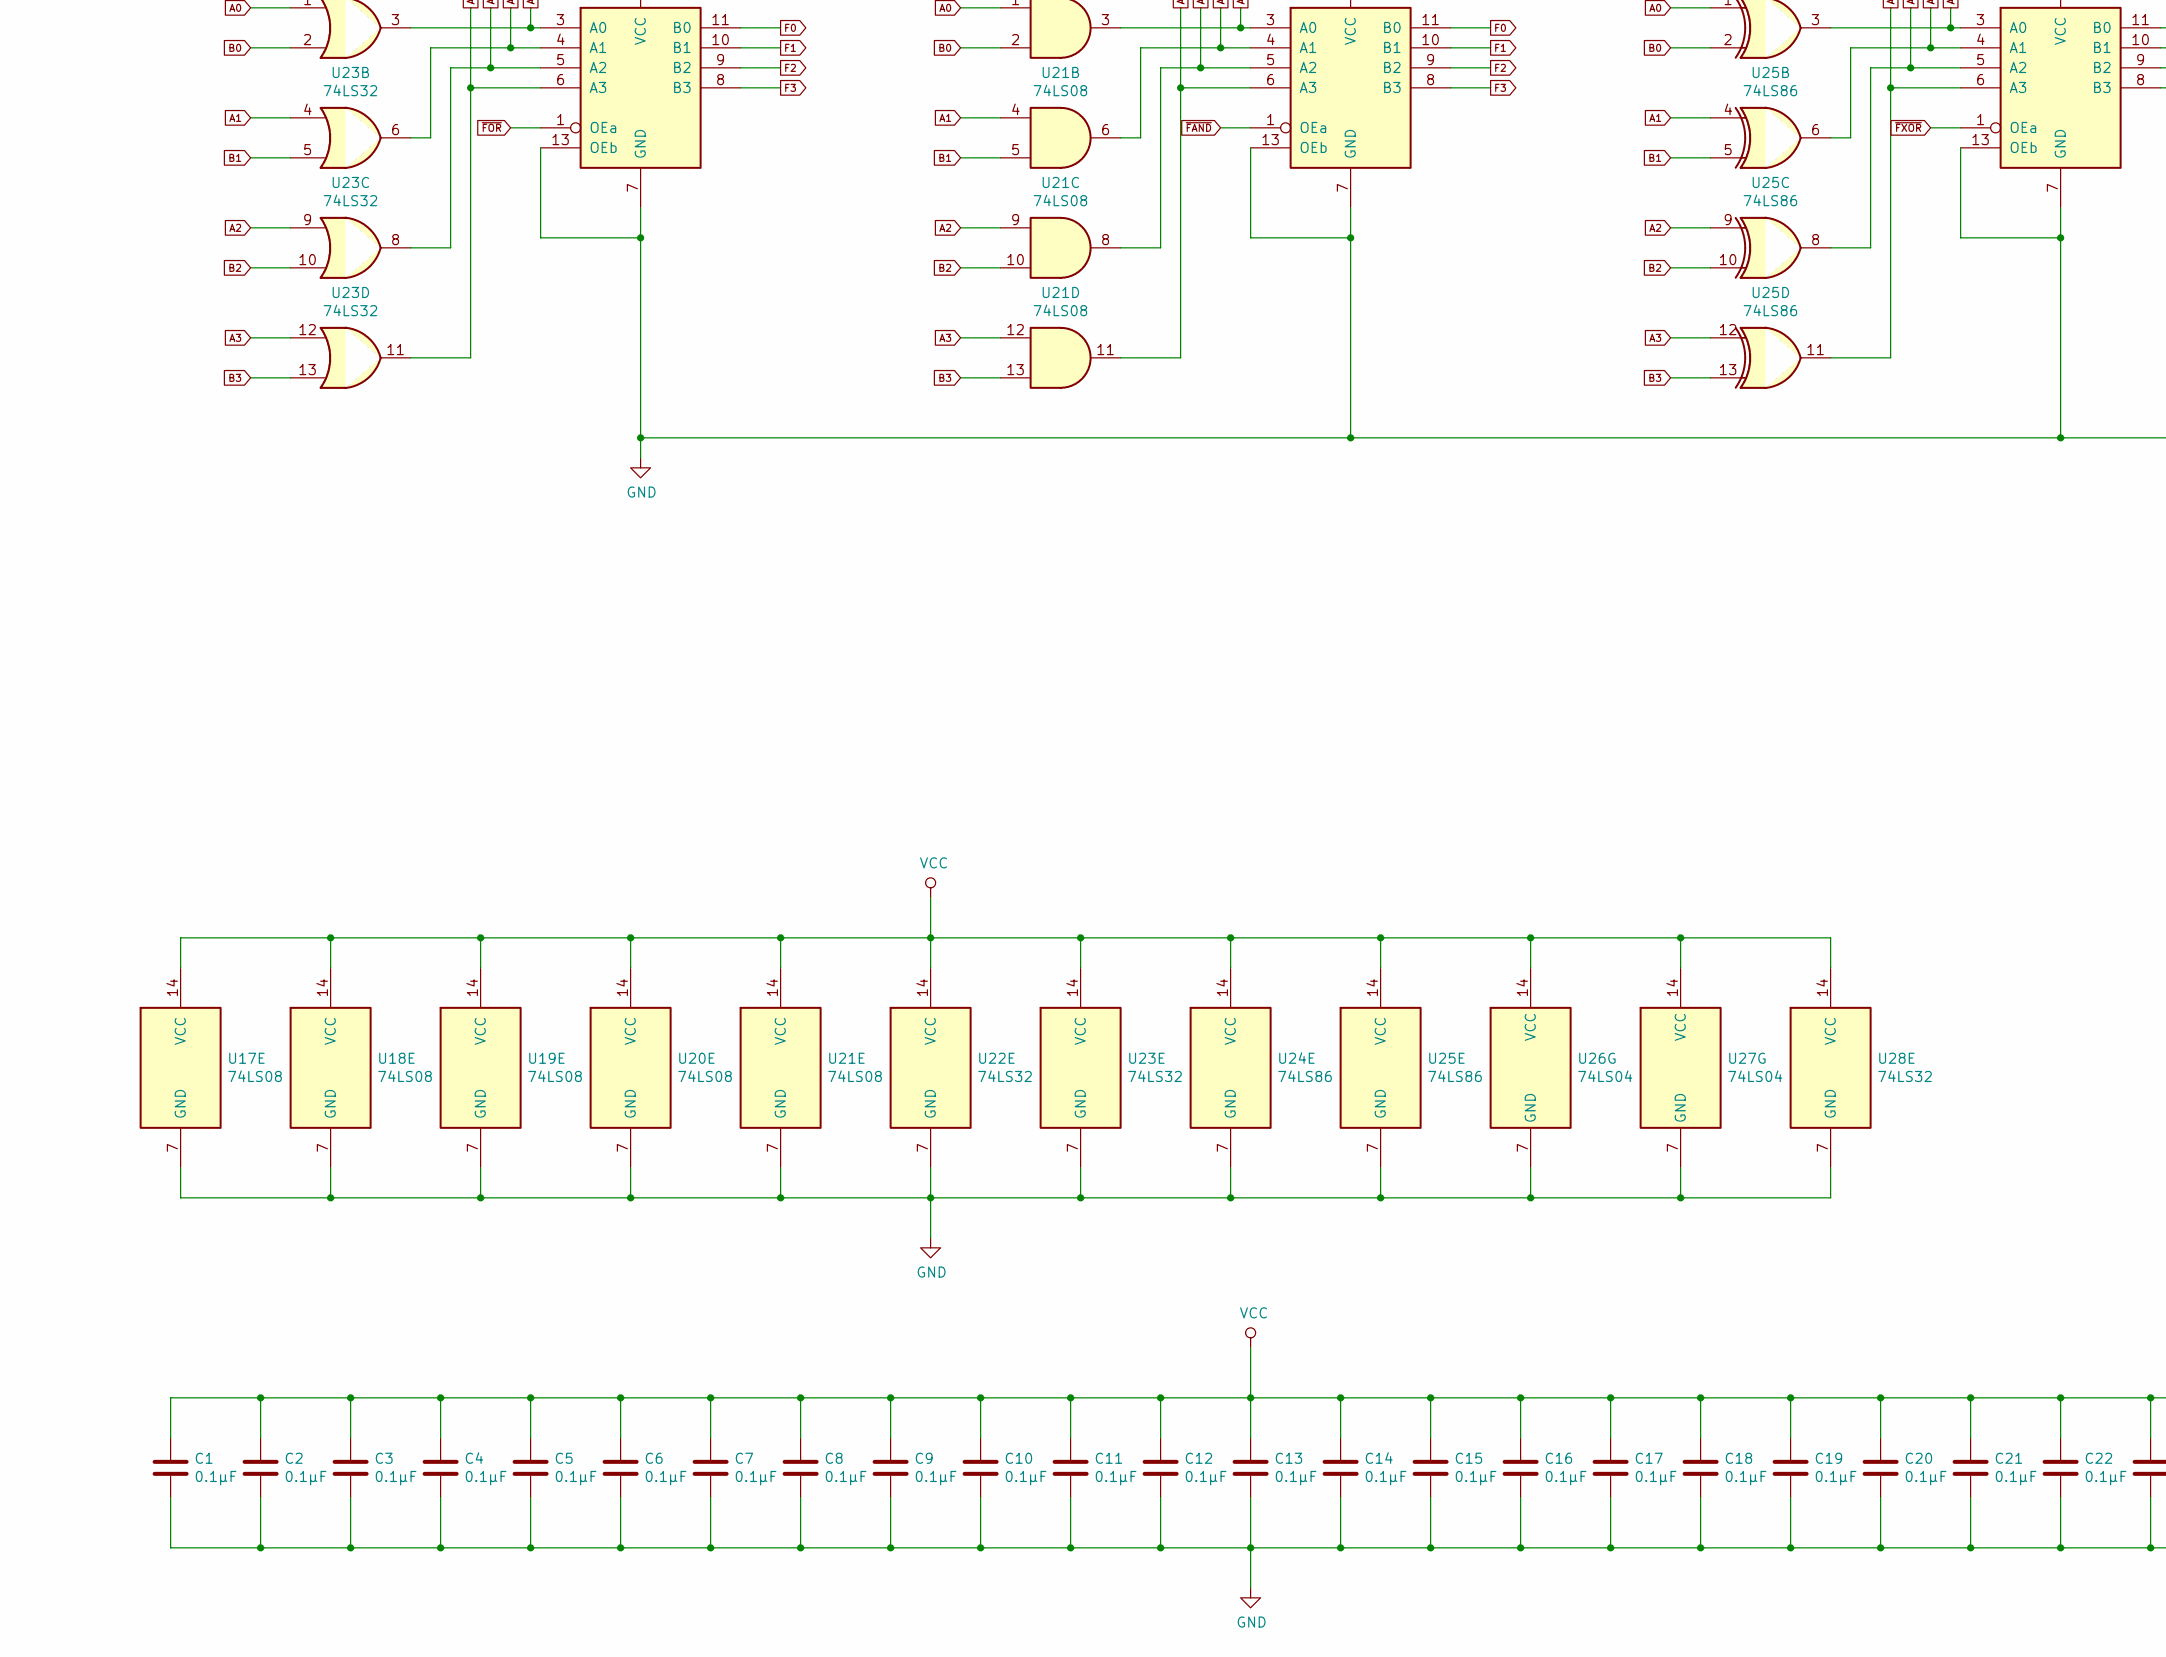
[picture p9: schematic ya4b-alu.sch, Ya4b Arithmetic Logic Unit, part in row 2, column 1]

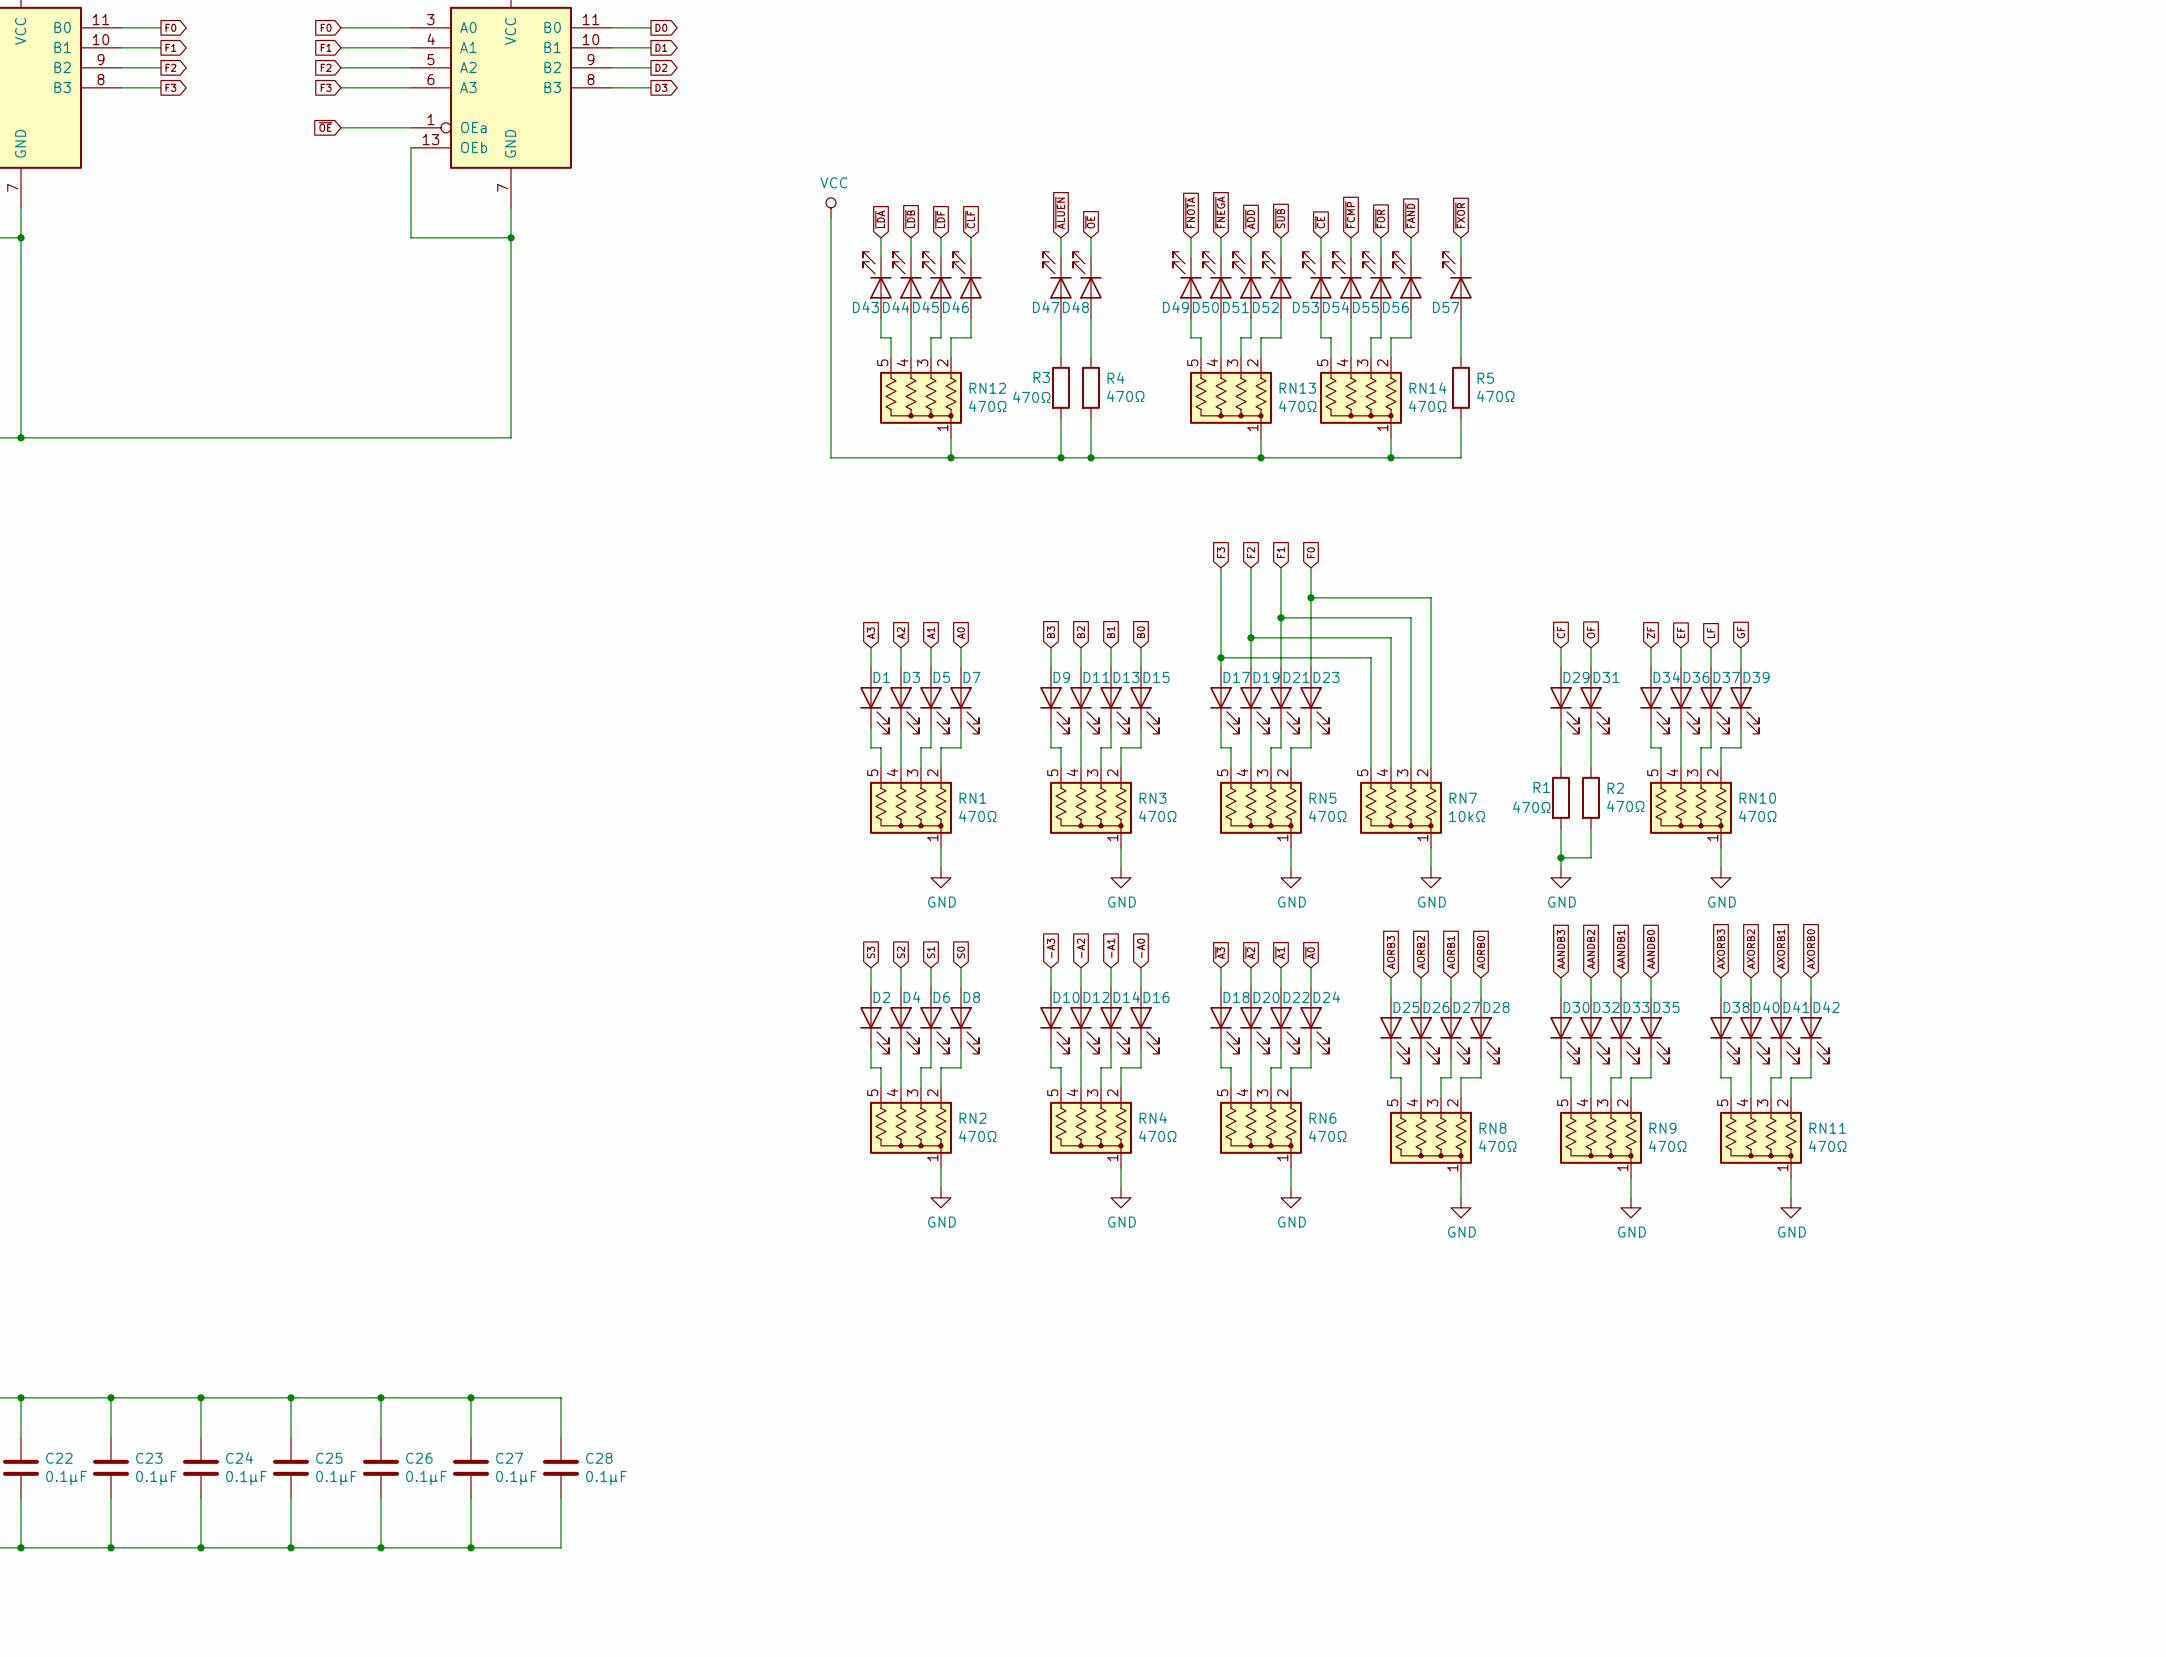
[picture p10: schematic ya4b-alu.sch, Ya4b Arithmetic Logic Unit, part in row 2, column 2]

Parts:
C1, C2, C3, C4, C5, C6, C7, C8, C9, C10, C11, C12, C13, C14, C15, C16, C17, C18, C19, C20, C21, C22, C23, C24, C25, C26, C27, C28: 0.1µF; C_Disc_D3.0mm_W1.6mm_P2.50mm
D1, D2, D3, D4, D5, D6, D7, D8, D9, D10, D11, D12, D13, D14, D15, D16, D17, D18, D19, D20, D21, D22, D23, D24, D25, D26, D27, D28, D29, D30, D31, D32, D33, D34, D35, D36, D37, D38, D39, D40, D41, D42, D43, D44, D45, D46, D47, D48, D49, D50, D51, D52, D53, D54, D55, D56, D57: LED; LED_Rectangular_W5.0mm_H2.0mm
J1: Conn_01x38; PinHeader_1x38_P2.54mm_Vertical
R1, R2, R3, R4, R5: 470Ω; R_Axial_DIN0207_L6.3mm_D2.5mm_P10.16mm_Horizontal
RN1, RN2, RN3, RN4, RN5, RN6, RN8, RN9, RN10, RN11, RN12, RN13, RN14: 470Ω; R_Array_SIP5
RN7: 10kΩ; R_Array_SIP5
U1: 74LS154; DIP-24_W15.24mm_Socket
U2, U3: 74LS379; DIP-16_W7.62mm_Socket
U4, U5: 74LS173; DIP-16_W7.62mm_Socket
U6, U7, U8, U9, U10, U11, U12: 74LS243; DIP-14_W7.62mm_Socket
U13, U14: 74LS283; DIP-16_W7.62mm_Socket
U15: 74LS157; DIP-16_W7.62mm_Socket
U16: 74LS85; DIP-16_W7.62mm_Socket
U17, U18, U19, U20, U21: 74LS08; DIP-14_W7.62mm_Socket
U22, U23, U28: 74LS32; DIP-14_W7.62mm_Socket
U24, U25: 74LS86; DIP-14_W7.62mm_Socket
U26, U27: 74LS04; DIP-14_W7.62mm_Socket

Connections:
-A0: D16.2 (A), U7.3 (A0), U13.4 (S1)
-A1: D14.2 (A), U7.4 (A1), U13.1 (S2)
-A2: D12.2 (A), U7.5 (A2), U13.13 (S3)
-A3: D10.2 (A), U7.6 (A3), U13.10 (S4)
A0: D7.2 (A), U2.2 (Q0), U14.5 (A1), U16.10 (A0), U21.1, U23.1, U25.1
A1: D5.2 (A), U2.7 (Q1), U14.3 (A2), U16.12 (A1), U21.4, U23.4, U25.4
A2: D3.2 (A), U2.10 (Q2), U14.14 (A3), U16.13 (A2), U21.9, U23.9, U25.9
A3: D1.2 (A), U2.15 (Q3), U14.12 (A4), U16.15 (A3), U21.12, U23.12, U24.5, U25.12
AANDB0: D35.2 (A), U10.3 (A0), U21.3
AANDB1: D33.2 (A), U10.4 (A1), U21.6
AANDB2: D32.2 (A), U10.5 (A2), U21.8
AANDB3: D30.2 (A), U10.6 (A3), U21.11
ADD_B3: U14.11 (B4), U15.12 (Zd), U24.2, U24.4
AORB0: D28.2 (A), U9.3 (A0), U23.3
AORB1: D27.2 (A), U9.4 (A1), U23.6
AORB2: D26.2 (A), U9.5 (A2), U23.8
AORB3: D25.2 (A), U9.6 (A3), U23.11
AXORB0: D42.2 (A), U11.3 (A0), U25.3
AXORB1: D41.2 (A), U11.4 (A1), U25.6
AXORB2: D40.2 (A), U11.5 (A2), U25.8
AXORB3: D38.2 (A), U11.6 (A3), U25.11
B0: D15.2 (A), U3.2 (Q0), U15.2 (I0a), U16.9 (B0), U21.2, U23.2, U25.2
B1: D13.2 (A), U3.7 (Q1), U15.5 (I0b), U16.11 (B1), U21.5, U23.5, U25.5
B2: D11.2 (A), U3.10 (Q2), U15.11 (I0c), U16.14 (B2), U21.10, U23.10, U25.10
B3: D9.2 (A), U3.15 (Q3), U15.14 (I0d), U16.1 (B3), U21.13, U23.13, U25.13
C0: U14.7 (C0), U22.3
C4: U14.9 (C4), U18.13
CF: D29.2 (A), J1.11, U4.3 (Q0), U19.2
CLK: J1.21, U2.9 (CP), U3.9 (CP), U4.7 (Cp), U5.7 (Cp), U18.1
CMPE: U5.13 (D1), U20.8
CMPG: U5.11 (D3), U20.3
CMPL: U5.12 (D2), U20.6
COUT: U4.14 (D0), U18.11
D0: J1.27, U2.4 (D0), U3.4 (D0), U12.11 (B0)
D1: J1.28, U2.5 (D1), U3.5 (D1), U12.10 (B1)
D2: J1.29, U2.12 (D2), U3.12 (D2), U12.9 (B2)
D3: J1.30, U2.13 (D3), U3.13 (D3), U12.8 (B3)
EF: D36.2 (A), J1.14, U5.4 (Q1)
F0: D23.2 (A), RN7.2 (R1), U6.11 (B0), U7.11 (B0), U8.11 (B0), U9.11 (B0), U10.11 (B0), U11.11 (B0), U12.3 (A0), U22.4
F1: D21.2 (A), RN7.3 (R2), U6.10 (B1), U7.10 (B1), U8.10 (B1), U9.10 (B1), U10.10 (B1), U11.10 (B1), U12.4 (A1), U22.5
F2: D19.2 (A), RN7.4 (R3), U6.9 (B2), U7.9 (B2), U8.9 (B2), U9.9 (B2), U10.9 (B2), U11.9 (B2), U12.5 (A2), U22.9
F3: D17.2 (A), RN7.5 (R4), U6.8 (B3), U7.8 (B3), U8.8 (B3), U9.8 (B3), U10.8 (B3), U11.8 (B3), U12.6 (A3), U22.10
GF: D39.2 (A), J1.16, U5.6 (Q3)
GND: C1.2, C2.2, C3.2, C4.2, C5.2, C6.2, C7.2, C8.2, C9.2, C10.2, C11.2, C12.2, C13.2, C14.2, C15.2, C16.2, C17.2, C18.2, C19.2, C20.2, C21.2, C22.2, C23.2, C24.2, C25.2, C26.2, C27.2, C28.2, J1.17, R1.2, R2.2, RN1.1 (common), RN2.1 (common), RN3.1 (common), RN4.1 (common), RN5.1 (common), RN6.1 (common), RN7.1 (common), RN8.1 (common), RN9.1 (common), RN10.1 (common), RN11.1 (common), U1.12 (GND), U2.8 (GND), U3.8 (GND), U4.1 (Oe1), U4.2 (Oe2), U4.8 (GND), U4.11 (D3), U4.12 (D2), U5.1 (Oe1), U5.2 (Oe2), U5.8 (GND), U6.7 (GND), U6.13 (OEb), U7.7 (GND), U7.13 (OEb), U8.7 (GND), U8.13 (OEb), U9.7 (GND), U9.13 (OEb), U10.7 (GND), U10.13 (OEb), U11.7 (GND), U11.13 (OEb), U12.7 (GND), U12.13 (OEb), U13.3 (A2), U13.5 (A1), U13.8 (GND), U13.12 (A4), U13.14 (A3), U14.8 (GND), U15.8 (GND), U15.15 (E), U16.2 (Ia<b), U16.4 (Ia>b), U16.8 (GND), U17.7 (GND), U18.7 (GND), U19.7 (GND), U20.7 (GND), U21.7 (GND), U22.7 (GND), U23.7 (GND), U24.7 (GND), U25.7 (GND), U26.7 (GND), U27.7 (GND), U28.7 (GND)
LF: D37.2 (A), J1.15, U5.5 (Q2)
unnamed: D1.1 (K), RN1.5 (R4)
unnamed: D2.1 (K), RN2.5 (R4)
unnamed: D3.1 (K), RN1.4 (R3)
unnamed: D4.1 (K), RN2.4 (R3)
unnamed: D5.1 (K), RN1.3 (R2)
unnamed: D6.1 (K), RN2.3 (R2)
unnamed: D7.1 (K), RN1.2 (R1)
unnamed: D8.1 (K), RN2.2 (R1)
unnamed: D9.1 (K), RN3.5 (R4)
unnamed: D10.1 (K), RN4.5 (R4)
unnamed: D11.1 (K), RN3.4 (R3)
unnamed: D12.1 (K), RN4.4 (R3)
unnamed: D13.1 (K), RN3.3 (R2)
unnamed: D14.1 (K), RN4.3 (R2)
unnamed: D15.1 (K), RN3.2 (R1)
unnamed: D16.1 (K), RN4.2 (R1)
unnamed: D17.1 (K), RN5.5 (R4)
unnamed: D18.1 (K), RN6.5 (R4)
unnamed: D19.1 (K), RN5.4 (R3)
unnamed: D20.1 (K), RN6.4 (R3)
unnamed: D21.1 (K), RN5.3 (R2)
unnamed: D22.1 (K), RN6.3 (R2)
unnamed: D23.1 (K), RN5.2 (R1)
unnamed: D24.1 (K), RN6.2 (R1)
unnamed: D25.1 (K), RN8.5 (R4)
unnamed: D26.1 (K), RN8.4 (R3)
unnamed: D27.1 (K), RN8.3 (R2)
unnamed: D28.1 (K), RN8.2 (R1)
unnamed: D29.1 (K), R1.1
unnamed: D30.1 (K), RN9.5 (R4)
unnamed: D31.1 (K), R2.1
unnamed: D32.1 (K), RN9.4 (R3)
unnamed: D33.1 (K), RN9.3 (R2)
unnamed: D34.1 (K), RN10.5 (R4)
unnamed: D35.1 (K), RN9.2 (R1)
unnamed: D36.1 (K), RN10.4 (R3)
unnamed: D37.1 (K), RN10.3 (R2)
unnamed: D38.1 (K), RN11.5 (R4)
unnamed: D39.1 (K), RN10.2 (R1)
unnamed: D40.1 (K), RN11.4 (R3)
unnamed: D41.1 (K), RN11.3 (R2)
unnamed: D42.1 (K), RN11.2 (R1)
unnamed: D43.2 (A), RN12.5 (R4)
unnamed: D44.2 (A), RN12.4 (R3)
unnamed: D45.2 (A), RN12.3 (R2)
unnamed: D46.2 (A), RN12.2 (R1)
unnamed: D47.2 (A), R3.1
unnamed: D48.2 (A), R4.1
unnamed: D49.2 (A), RN13.5 (R4)
unnamed: D50.2 (A), RN13.4 (R3)
unnamed: D51.2 (A), RN13.3 (R2)
unnamed: D52.2 (A), RN13.2 (R1)
unnamed: D53.2 (A), RN14.5 (R4)
unnamed: D54.2 (A), RN14.4 (R3)
unnamed: D55.2 (A), RN14.3 (R2)
unnamed: D56.2 (A), RN14.2 (R1)
unnamed: D57.2 (A), R5.1
unnamed: U14.2 (B2), U15.7 (Zb)
unnamed: U14.6 (B1), U15.4 (Za)
unnamed: U14.15 (B3), U15.9 (Zc)
unnamed: U16.5 (Oa>b), U20.1
unnamed: U16.6 (Oa=b), U20.9
unnamed: U16.7 (Oa<b), U20.4
unnamed: U18.2, U27.2
unnamed: U18.3, U28.1
unnamed: U18.4, U24.3
unnamed: U18.5, U26.8
unnamed: U18.6, U18.9
unnamed: U18.10, U18.12, U26.10
unnamed: U19.1, U26.4
unnamed: U19.3, U22.1
unnamed: U19.5, U26.6
unnamed: U19.6, U22.2
unnamed: U20.2, U20.5, U20.10, U26.2
unnamed: U22.11, U26.13
unnamed: U22.6, U22.12
unnamed: U22.8, U22.13
unnamed: U24.6, U26.9
unnamed: U27.4, U28.2
unnamed: U4.15 (Mr), U5.15 (Mr), U28.3
OF: D31.2 (A), J1.12, U4.4 (Q1)
OP0: J1.4, U1.23 (A0)
OP1: J1.3, U1.22 (A1)
OP2: J1.2, U1.21 (A2)
OP3: J1.1, U1.20 (A3)
OVR: U4.13 (D1), U18.8
S0: D8.2 (A), U8.3 (A0), U14.4 (S1)
S1: D6.2 (A), U8.4 (A1), U14.1 (S2)
S2: D4.2 (A), U8.5 (A2), U14.13 (S3)
S3: D2.2 (A), U8.6 (A3), U14.10 (S4), U24.1
VCC: C1.1, C2.1, C3.1, C4.1, C5.1, C6.1, C7.1, C8.1, C9.1, C10.1, C11.1, C12.1, C13.1, C14.1, C15.1, C16.1, C17.1, C18.1, C19.1, C20.1, C21.1, C22.1, C23.1, C24.1, C25.1, C26.1, C27.1, C28.1, J1.18, R3.2, R4.2, R5.2, RN12.1 (common), RN13.1 (common), RN14.1 (common), U1.24 (VCC), U2.16 (VCC), U3.16 (VCC), U4.16 (VCC), U5.16 (VCC), U6.14 (VCC), U7.14 (VCC), U8.14 (VCC), U9.14 (VCC), U10.14 (VCC), U11.14 (VCC), U12.14 (VCC), U13.7 (C0), U13.16 (VCC), U14.16 (VCC), U15.16 (VCC), U16.3 (Ia=b), U16.16 (VCC), U17.14 (VCC), U18.14 (VCC), U19.14 (VCC), U20.14 (VCC), U21.14 (VCC), U22.14 (VCC), U23.14 (VCC), U24.14 (VCC), U25.14 (VCC), U26.14 (VCC), U27.14 (VCC), U28.14 (VCC)
ZERO: U5.14 (D0), U26.12
ZF: D34.2 (A), J1.13, U5.3 (Q0)
~A0: D24.2 (A), U2.3 (~Q0), U6.3 (A0), U13.6 (B1)
~A1: D22.2 (A), U2.6 (~Q1), U6.4 (A1), U13.2 (B2)
~A2: D20.2 (A), U2.11 (~Q2), U6.5 (A2), U13.15 (B3)
~A3: D18.2 (A), U2.14 (~Q3), U6.6 (A3), U13.11 (B4)
~ADD: D51.1 (K), U15.1 (S), U17.3, U17.12
~ALUEN: D47.1 (K), J1.5, U1.18 (E0), U1.19 (E1)
~AORS: U8.1 (OEa), U17.11, U26.11
~B0: U3.3 (~Q0), U15.3 (I1a)
~B1: U3.6 (~Q1), U15.6 (I1b)
~B2: U3.11 (~Q2), U15.10 (I1c)
~B3: U3.14 (~Q3), U15.13 (I1d)
~CE: D53.1 (K), U17.8, U19.4, U26.3
~CLF: D46.1 (K), J1.9, U27.1
~FADD: U1.1 (S0), U17.1
~FADDC: U1.2 (S1), U17.2, U17.9
~FAND: D56.1 (K), U1.8 (S7), U10.1 (OEa)
~FCMP: D54.1 (K), U1.14 (S12), U26.1
~FNEGA: D50.1 (K), U1.5 (S4), U7.1 (OEa)
~FNOTA: D49.1 (K), U1.10 (S9), U6.1 (OEa)
~FOR: D55.1 (K), U1.7 (S6), U9.1 (OEa)
~FSUB: U1.3 (S2), U17.4
~FSUBC: U1.4 (S3), U17.5, U17.10
~FXOR: D57.1 (K), U1.9 (S8), U11.1 (OEa)
~LDA: D43.1 (K), J1.6, U2.1 (~E)
~LDB: D44.1 (K), J1.7, U3.1 (~E)
~LDF: D45.1 (K), J1.8, U4.9 (E1), U4.10 (E2), U5.9 (E1), U5.10 (E2)
~OE: D48.1 (K), J1.10, U12.1 (OEa)
~RST: J1.20, U27.3
~SUB: D52.1 (K), U17.6, U17.13, U26.5

Board: 2 copper layers, 133 parts (0 on the bottom side), 167 nets, no tracks yet.
