lafehubert/electronics/ya4b/address-register/address-register-bank/address-register-bank.kicad_pcb

## KiCad design ya4b/address-register/address-register-bank/address-register-bank.kicad_pcb (2020-04-11)

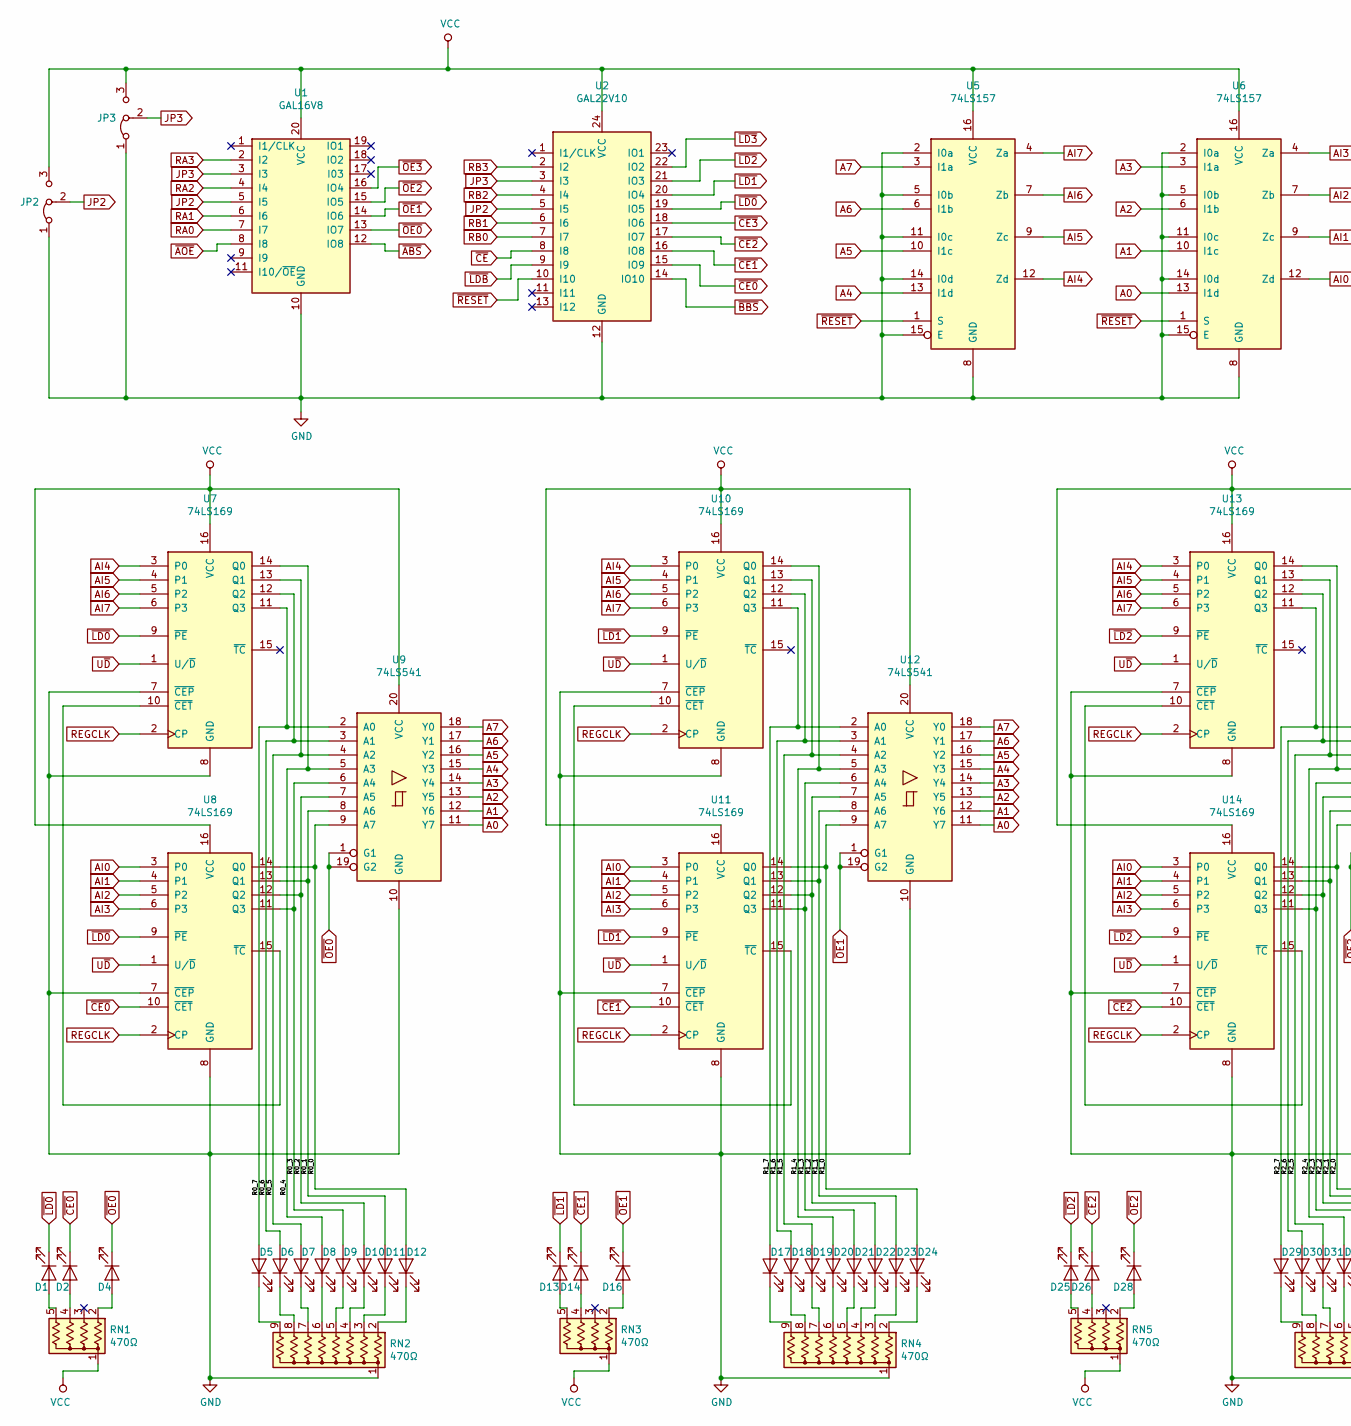
[picture p11: schematic address-register-bank.sch, Address Register Bank, part in row 1, column 1]

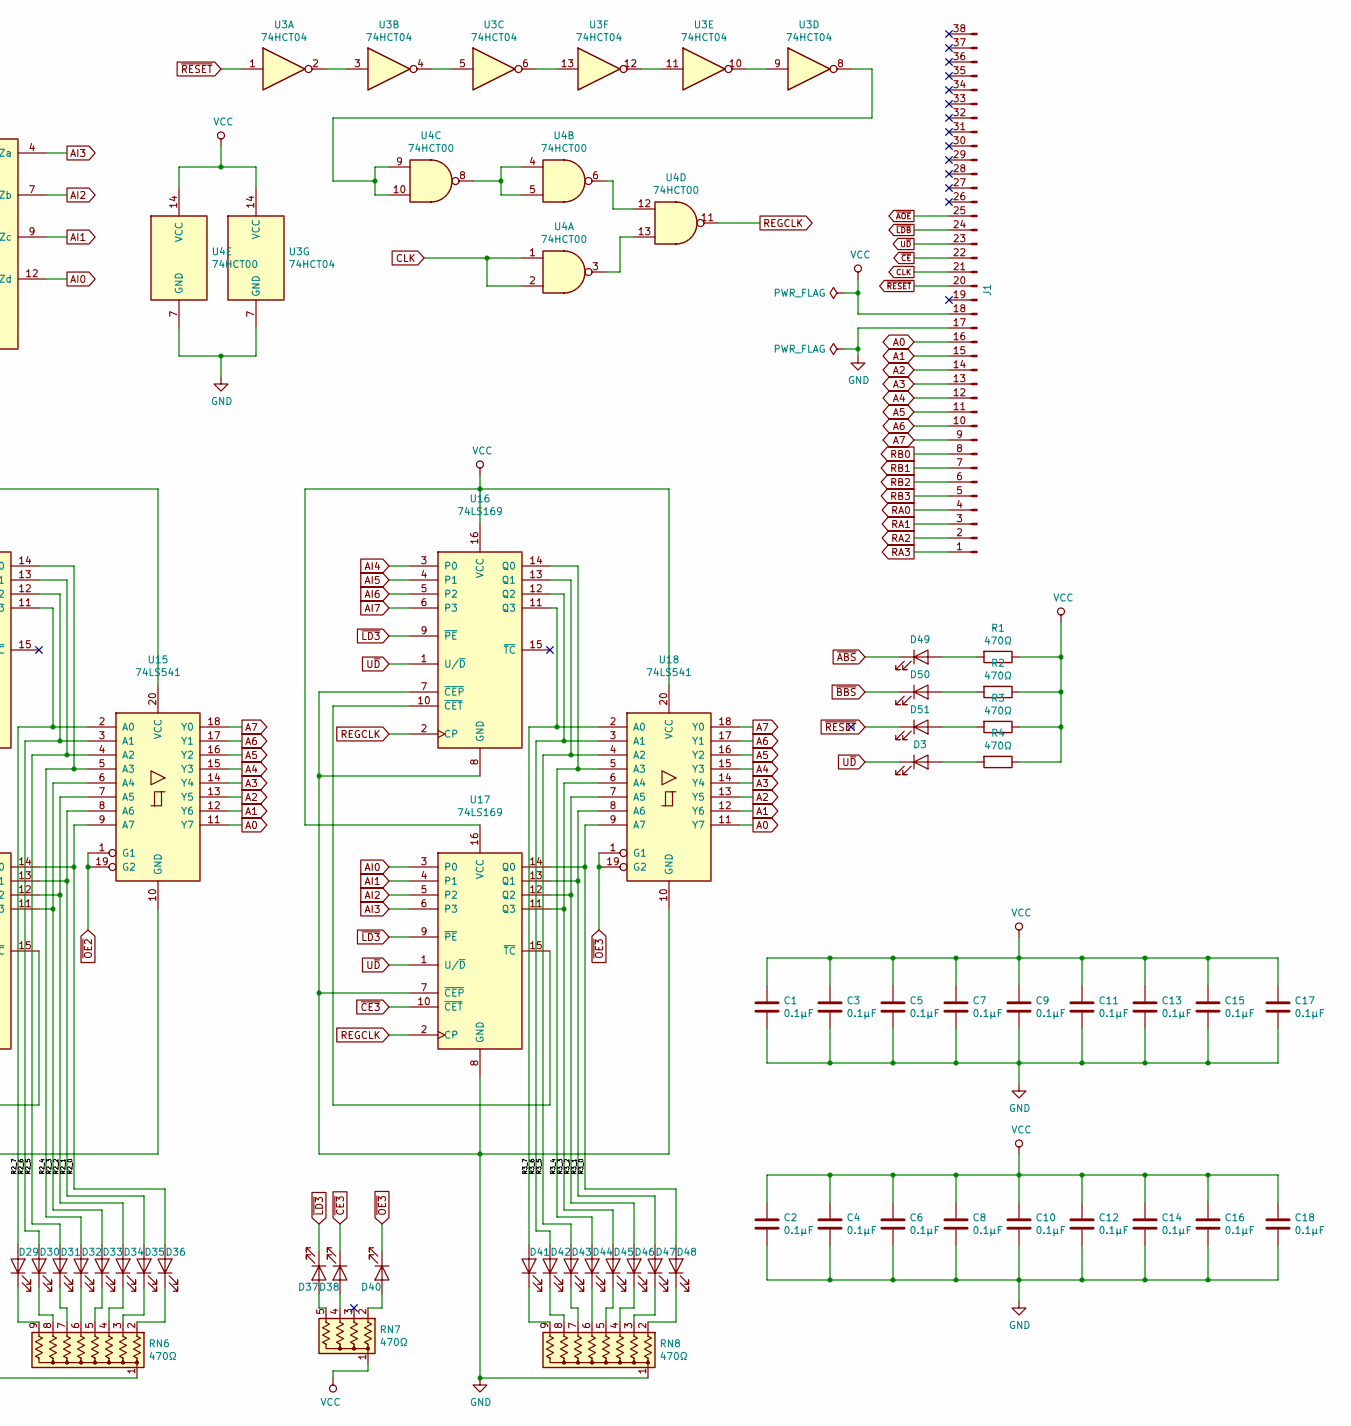
[picture p12: schematic address-register-bank.sch, Address Register Bank, part in row 1, column 2]

Parts:
C1, C2, C3, C4, C5, C6, C7, C8, C9, C10, C11, C12, C13, C14, C15, C16, C17, C18: 0.1µF; C_Disc_D3.0mm_W1.6mm_P2.50mm
D1, D2, D3, D4, D5, D6, D7, D8, D9, D10, D11, D12, D13, D14, D16, D17, D18, D19, D20, D21, D22, D23, D24, D25, D26, D28, D29, D30, D31, D32, D33, D34, D35, D36, D37, D38, D40, D41, D42, D43, D44, D45, D46, D47, D48, D49, D50, D51: LED; LED_Rectangular_W5.0mm_H2.0mm
J1: Conn_01x38_Male; PinHeader_1x38_P2.54mm_Vertical
JP2, JP3: Jumper_3_Bridged12; PinHeader_1x03_P2.54mm_Vertical
R1, R2, R3, R4: 470Ω; R_Axial_DIN0207_L6.3mm_D2.5mm_P10.16mm_Horizontal
RN1, RN3, RN5, RN7: 470Ω; R_Array_SIP5
RN2, RN4, RN6, RN8: 470Ω; R_Array_SIP9
U1: GAL16V8; DIP-20_W7.62mm_Socket
U2: GAL22V10; DIP-24_W7.62mm_Socket
U3: 74HCT04; DIP-14_W7.62mm_Socket
U4: 74HCT00; DIP-14_W7.62mm_Socket
U5, U6: 74LS157; DIP-16_W7.62mm_Socket
U7, U8, U10, U11, U13, U14, U16, U17: 74LS169; DIP-16_W7.62mm_Socket
U9, U12, U15, U18: 74LS541; DIP-20_W7.62mm_Socket

Connections:
/R0_0: D12.2 (A), U8.14 (Q0), U9.9 (A7)
/R0_1: D11.2 (A), U8.13 (Q1), U9.8 (A6)
/R0_2: D10.2 (A), U8.12 (Q2), U9.7 (A5)
/R0_3: D9.2 (A), U8.11 (Q3), U9.6 (A4)
/R0_4: D8.2 (A), U7.14 (Q0), U9.5 (A3)
/R0_5: D7.2 (A), U7.13 (Q1), U9.4 (A2)
/R0_6: D6.2 (A), U7.12 (Q2), U9.3 (A1)
/R0_7: D5.2 (A), U7.11 (Q3), U9.2 (A0)
/R1_0: D24.2 (A), U11.14 (Q0), U12.9 (A7)
/R1_1: D23.2 (A), U11.13 (Q1), U12.8 (A6)
/R1_2: D22.2 (A), U11.12 (Q2), U12.7 (A5)
/R1_3: D21.2 (A), U11.11 (Q3), U12.6 (A4)
/R1_4: D20.2 (A), U10.14 (Q0), U12.5 (A3)
/R1_5: D19.2 (A), U10.13 (Q1), U12.4 (A2)
/R1_6: D18.2 (A), U10.12 (Q2), U12.3 (A1)
/R1_7: D17.2 (A), U10.11 (Q3), U12.2 (A0)
/R2_0: D36.2 (A), U14.14 (Q0), U15.9 (A7)
/R2_1: D35.2 (A), U14.13 (Q1), U15.8 (A6)
/R2_2: D34.2 (A), U14.12 (Q2), U15.7 (A5)
/R2_3: D33.2 (A), U14.11 (Q3), U15.6 (A4)
/R2_4: D32.2 (A), U13.14 (Q0), U15.5 (A3)
/R2_5: D31.2 (A), U13.13 (Q1), U15.4 (A2)
/R2_6: D30.2 (A), U13.12 (Q2), U15.3 (A1)
/R2_7: D29.2 (A), U13.11 (Q3), U15.2 (A0)
/R3_0: D48.2 (A), U17.14 (Q0), U18.9 (A7)
/R3_1: D47.2 (A), U17.13 (Q1), U18.8 (A6)
/R3_2: D46.2 (A), U17.12 (Q2), U18.7 (A5)
/R3_3: D45.2 (A), U17.11 (Q3), U18.6 (A4)
/R3_4: D44.2 (A), U16.14 (Q0), U18.5 (A3)
/R3_5: D43.2 (A), U16.13 (Q1), U18.4 (A2)
/R3_6: D42.2 (A), U16.12 (Q2), U18.3 (A1)
/R3_7: D41.2 (A), U16.11 (Q3), U18.2 (A0)
A0: J1.16, U6.13 (I1d), U9.11 (Y7), U12.11 (Y7), U15.11 (Y7), U18.11 (Y7)
A1: J1.15, U6.10 (I1c), U9.12 (Y6), U12.12 (Y6), U15.12 (Y6), U18.12 (Y6)
A2: J1.14, U6.6 (I1b), U9.13 (Y5), U12.13 (Y5), U15.13 (Y5), U18.13 (Y5)
A3: J1.13, U6.3 (I1a), U9.14 (Y4), U12.14 (Y4), U15.14 (Y4), U18.14 (Y4)
A4: J1.12, U5.13 (I1d), U9.15 (Y3), U12.15 (Y3), U15.15 (Y3), U18.15 (Y3)
A5: J1.11, U5.10 (I1c), U9.16 (Y2), U12.16 (Y2), U15.16 (Y2), U18.16 (Y2)
A6: J1.10, U5.6 (I1b), U9.17 (Y1), U12.17 (Y1), U15.17 (Y1), U18.17 (Y1)
A7: J1.9, U5.3 (I1a), U9.18 (Y0), U12.18 (Y0), U15.18 (Y0), U18.18 (Y0)
AI0: U6.12 (Zd), U8.3 (P0), U11.3 (P0), U14.3 (P0), U17.3 (P0)
AI1: U6.9 (Zc), U8.4 (P1), U11.4 (P1), U14.4 (P1), U17.4 (P1)
AI2: U6.7 (Zb), U8.5 (P2), U11.5 (P2), U14.5 (P2), U17.5 (P2)
AI3: U6.4 (Za), U8.6 (P3), U11.6 (P3), U14.6 (P3), U17.6 (P3)
AI4: U5.12 (Zd), U7.3 (P0), U10.3 (P0), U13.3 (P0), U16.3 (P0)
AI5: U5.9 (Zc), U7.4 (P1), U10.4 (P1), U13.4 (P1), U16.4 (P1)
AI6: U5.7 (Zb), U7.5 (P2), U10.5 (P2), U13.5 (P2), U16.5 (P2)
AI7: U5.4 (Za), U7.6 (P3), U10.6 (P3), U13.6 (P3), U16.6 (P3)
CLK: J1.21, U4.1, U4.2
GND: C1.2, C2.2, C3.2, C4.2, C5.2, C6.2, C7.2, C8.2, C9.2, C10.2, C11.2, C12.2, C13.2, C14.2, C15.2, C16.2, C17.2, C18.2, J1.17, JP2.1 (A), JP3.1 (A), RN2.1 (common), RN4.1 (common), RN6.1 (common), RN8.1 (common), U1.10 (GND), U2.12 (GND), U3.7 (GND), U4.7 (GND), U5.2 (I0a), U5.5 (I0b), U5.8 (GND), U5.11 (I0c), U5.14 (I0d), U5.15 (E), U6.2 (I0a), U6.5 (I0b), U6.8 (GND), U6.11 (I0c), U6.14 (I0d), U6.15 (E), U7.7 (~CEP), U7.8 (GND), U8.7 (~CEP), U8.8 (GND), U9.10 (GND), U10.7 (~CEP), U10.8 (GND), U11.7 (~CEP), U11.8 (GND), U12.10 (GND), U13.7 (~CEP), U13.8 (GND), U14.7 (~CEP), U14.8 (GND), U15.10 (GND), U16.7 (~CEP), U16.8 (GND), U17.7 (~CEP), U17.8 (GND), U18.10 (GND)
JP2: JP2.2 (C), U1.5 (I5), U2.5 (I5)
JP3: JP3.2 (C), U1.3 (I3), U2.3 (I3)
unnamed: D1.2 (A), RN1.5 (R4)
unnamed: D2.2 (A), RN1.4 (R3)
unnamed: D3.2 (A), R4.2
unnamed: D4.2 (A), RN1.2 (R1)
unnamed: D5.1 (K), RN2.9 (R8)
unnamed: D6.1 (K), RN2.8 (R7)
unnamed: D7.1 (K), RN2.7 (R6)
unnamed: D8.1 (K), RN2.6 (R5)
unnamed: D9.1 (K), RN2.5 (R4)
unnamed: D10.1 (K), RN2.4 (R3)
unnamed: D11.1 (K), RN2.3 (R2)
unnamed: D12.1 (K), RN2.2 (R1)
unnamed: D13.2 (A), RN3.5 (R4)
unnamed: D14.2 (A), RN3.4 (R3)
unnamed: D16.2 (A), RN3.2 (R1)
unnamed: D17.1 (K), RN4.9 (R8)
unnamed: D18.1 (K), RN4.8 (R7)
unnamed: D19.1 (K), RN4.7 (R6)
unnamed: D20.1 (K), RN4.6 (R5)
unnamed: D21.1 (K), RN4.5 (R4)
unnamed: D22.1 (K), RN4.4 (R3)
unnamed: D23.1 (K), RN4.3 (R2)
unnamed: D24.1 (K), RN4.2 (R1)
unnamed: D25.2 (A), RN5.5 (R4)
unnamed: D26.2 (A), RN5.4 (R3)
unnamed: D28.2 (A), RN5.2 (R1)
unnamed: D29.1 (K), RN6.9 (R8)
unnamed: D30.1 (K), RN6.8 (R7)
unnamed: D31.1 (K), RN6.7 (R6)
unnamed: D32.1 (K), RN6.6 (R5)
unnamed: D33.1 (K), RN6.5 (R4)
unnamed: D34.1 (K), RN6.4 (R3)
unnamed: D35.1 (K), RN6.3 (R2)
unnamed: D36.1 (K), RN6.2 (R1)
unnamed: D37.2 (A), RN7.5 (R4)
unnamed: D38.2 (A), RN7.4 (R3)
unnamed: D40.2 (A), RN7.2 (R1)
unnamed: D41.1 (K), RN8.9 (R8)
unnamed: D42.1 (K), RN8.8 (R7)
unnamed: D43.1 (K), RN8.7 (R6)
unnamed: D44.1 (K), RN8.6 (R5)
unnamed: D45.1 (K), RN8.5 (R4)
unnamed: D46.1 (K), RN8.4 (R3)
unnamed: D47.1 (K), RN8.3 (R2)
unnamed: D48.1 (K), RN8.2 (R1)
unnamed: D49.2 (A), R1.2
unnamed: D50.2 (A), R2.2
unnamed: D51.2 (A), R3.2
unnamed: U3.2, U3.3
unnamed: U3.4, U3.5
unnamed: U3.8, U4.9, U4.10
unnamed: U3.9, U3.10
unnamed: U3.11, U3.12
unnamed: U3.6, U3.13
unnamed: U4.4, U4.5, U4.8
unnamed: U4.6, U4.12
unnamed: U4.3, U4.13
unnamed: U7.10 (~CET), U8.15 (~TC)
unnamed: U10.10 (~CET), U11.15 (~TC)
unnamed: U13.10 (~CET), U14.15 (~TC)
unnamed: U16.10 (~CET), U17.15 (~TC)
RA0: J1.4, U1.7 (I7)
RA1: J1.3, U1.6 (I6)
RA2: J1.2, U1.4 (I4)
RA3: J1.1, U1.2 (I2)
RB0: J1.8, U2.7 (I7)
RB1: J1.7, U2.6 (I6)
RB2: J1.6, U2.4 (I4)
RB3: J1.5, U2.2 (I2)
REGCLK: U4.11, U7.2 (CP), U8.2 (CP), U10.2 (CP), U11.2 (CP), U13.2 (CP), U14.2 (CP), U16.2 (CP), U17.2 (CP)
U~D~: D3.1 (K), J1.23, U7.1 (U/~D), U8.1 (U/~D), U10.1 (U/~D), U11.1 (U/~D), U13.1 (U/~D), U14.1 (U/~D), U16.1 (U/~D), U17.1 (U/~D)
VCC: C1.1, C2.1, C3.1, C4.1, C5.1, C6.1, C7.1, C8.1, C9.1, C10.1, C11.1, C12.1, C13.1, C14.1, C15.1, C16.1, C17.1, C18.1, J1.18, JP2.3 (B), JP3.3 (B), R1.1, R2.1, R3.1, R4.1, RN1.1 (common), RN3.1 (common), RN5.1 (common), RN7.1 (common), U1.20 (VCC), U2.24 (VCC), U3.14 (VCC), U4.14 (VCC), U5.16 (VCC), U6.16 (VCC), U7.16 (VCC), U8.16 (VCC), U9.20 (VCC), U10.16 (VCC), U11.16 (VCC), U12.20 (VCC), U13.16 (VCC), U14.16 (VCC), U15.20 (VCC), U16.16 (VCC), U17.16 (VCC), U18.20 (VCC)
~ABS~: D49.1 (K), U1.12 (IO8)
~AOE~: J1.25, U1.8 (I8)
~BBS~: D50.1 (K), U2.14 (IO10)
~CE0~: D2.1 (K), U2.15 (IO9), U8.10 (~CET)
~CE1~: D14.1 (K), U2.16 (IO8), U11.10 (~CET)
~CE2~: D26.1 (K), U2.17 (IO7), U14.10 (~CET)
~CE3~: D38.1 (K), U2.18 (IO6), U17.10 (~CET)
~CE~: J1.22, U2.8 (I8)
~LD0~: D1.1 (K), U2.19 (IO5), U7.9 (~PE), U8.9 (~PE)
~LD1~: D13.1 (K), U2.20 (IO4), U10.9 (~PE), U11.9 (~PE)
~LD2~: D25.1 (K), U2.21 (IO3), U13.9 (~PE), U14.9 (~PE)
~LD3~: D37.1 (K), U2.22 (IO2), U16.9 (~PE), U17.9 (~PE)
~LDB~: J1.24, U2.9 (I9)
~OE0~: D4.1 (K), U1.13 (IO7), U9.1 (G1), U9.19 (G2)
~OE1~: D16.1 (K), U1.14 (IO6), U12.1 (G1), U12.19 (G2)
~OE2~: D28.1 (K), U1.15 (IO5), U15.1 (G1), U15.19 (G2)
~OE3~: D40.1 (K), U1.16 (IO4), U18.1 (G1), U18.19 (G2)
~RESET~: D51.1 (K), J1.20, U2.10 (I10), U3.1, U5.1 (S), U6.1 (S)

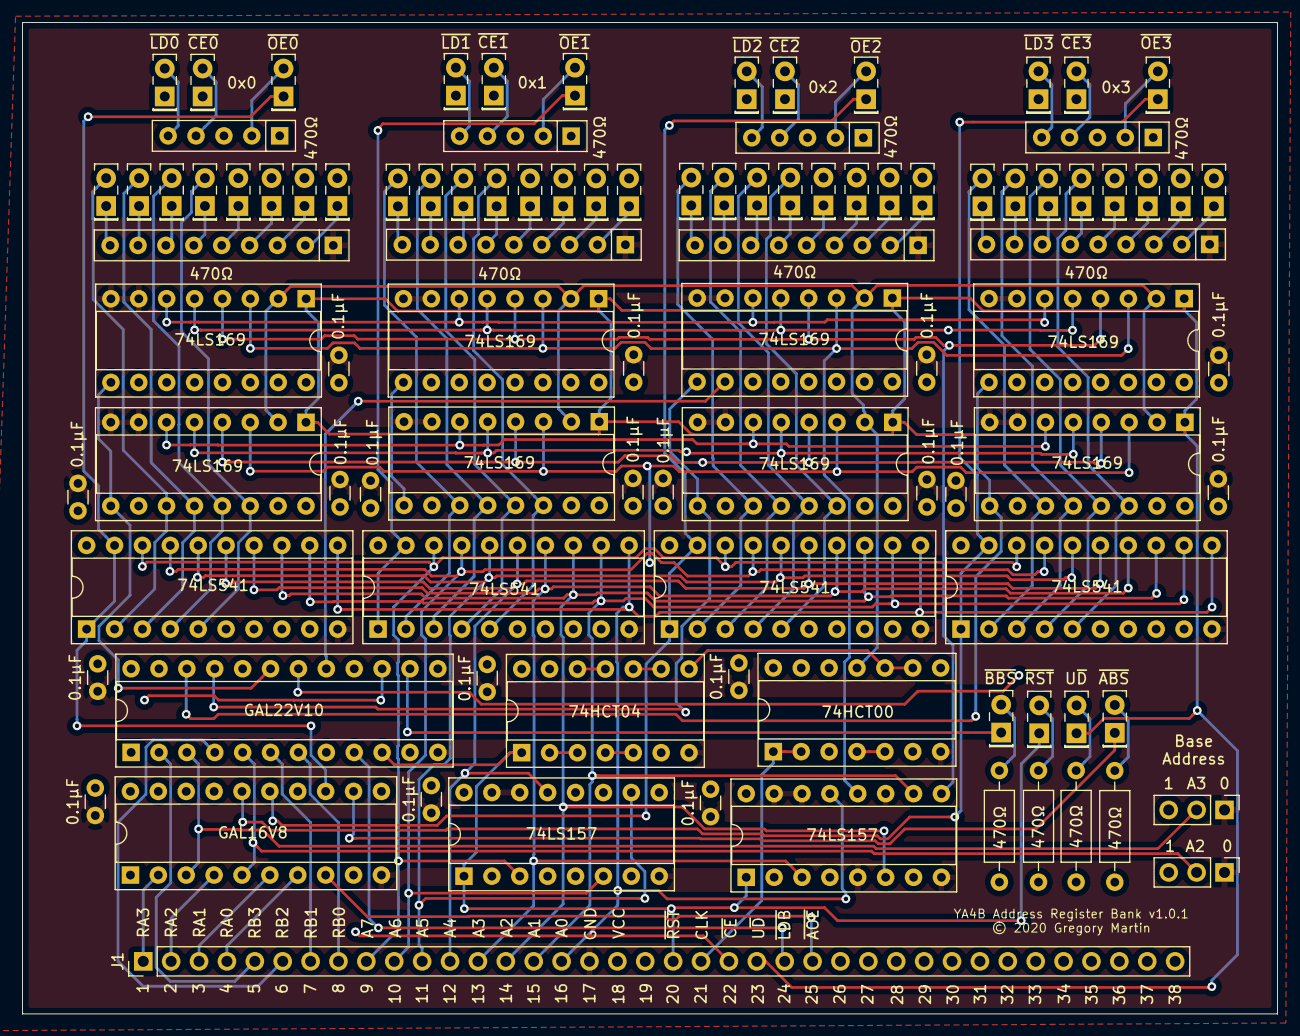
[picture p13: board address-register-bank.kicad_pcb from above]

Board: 4 copper layers, 114.3 x 90.3 mm, 99 parts (0 on the bottom side), 142 nets.
