lafehubert/electronics/ya4b/transfer-register/transfer-register-board/transfer-register-board.kicad_pcb

## KiCad design ya4b/transfer-register/transfer-register-board/transfer-register-board.kicad_pcb (2020-02-15)

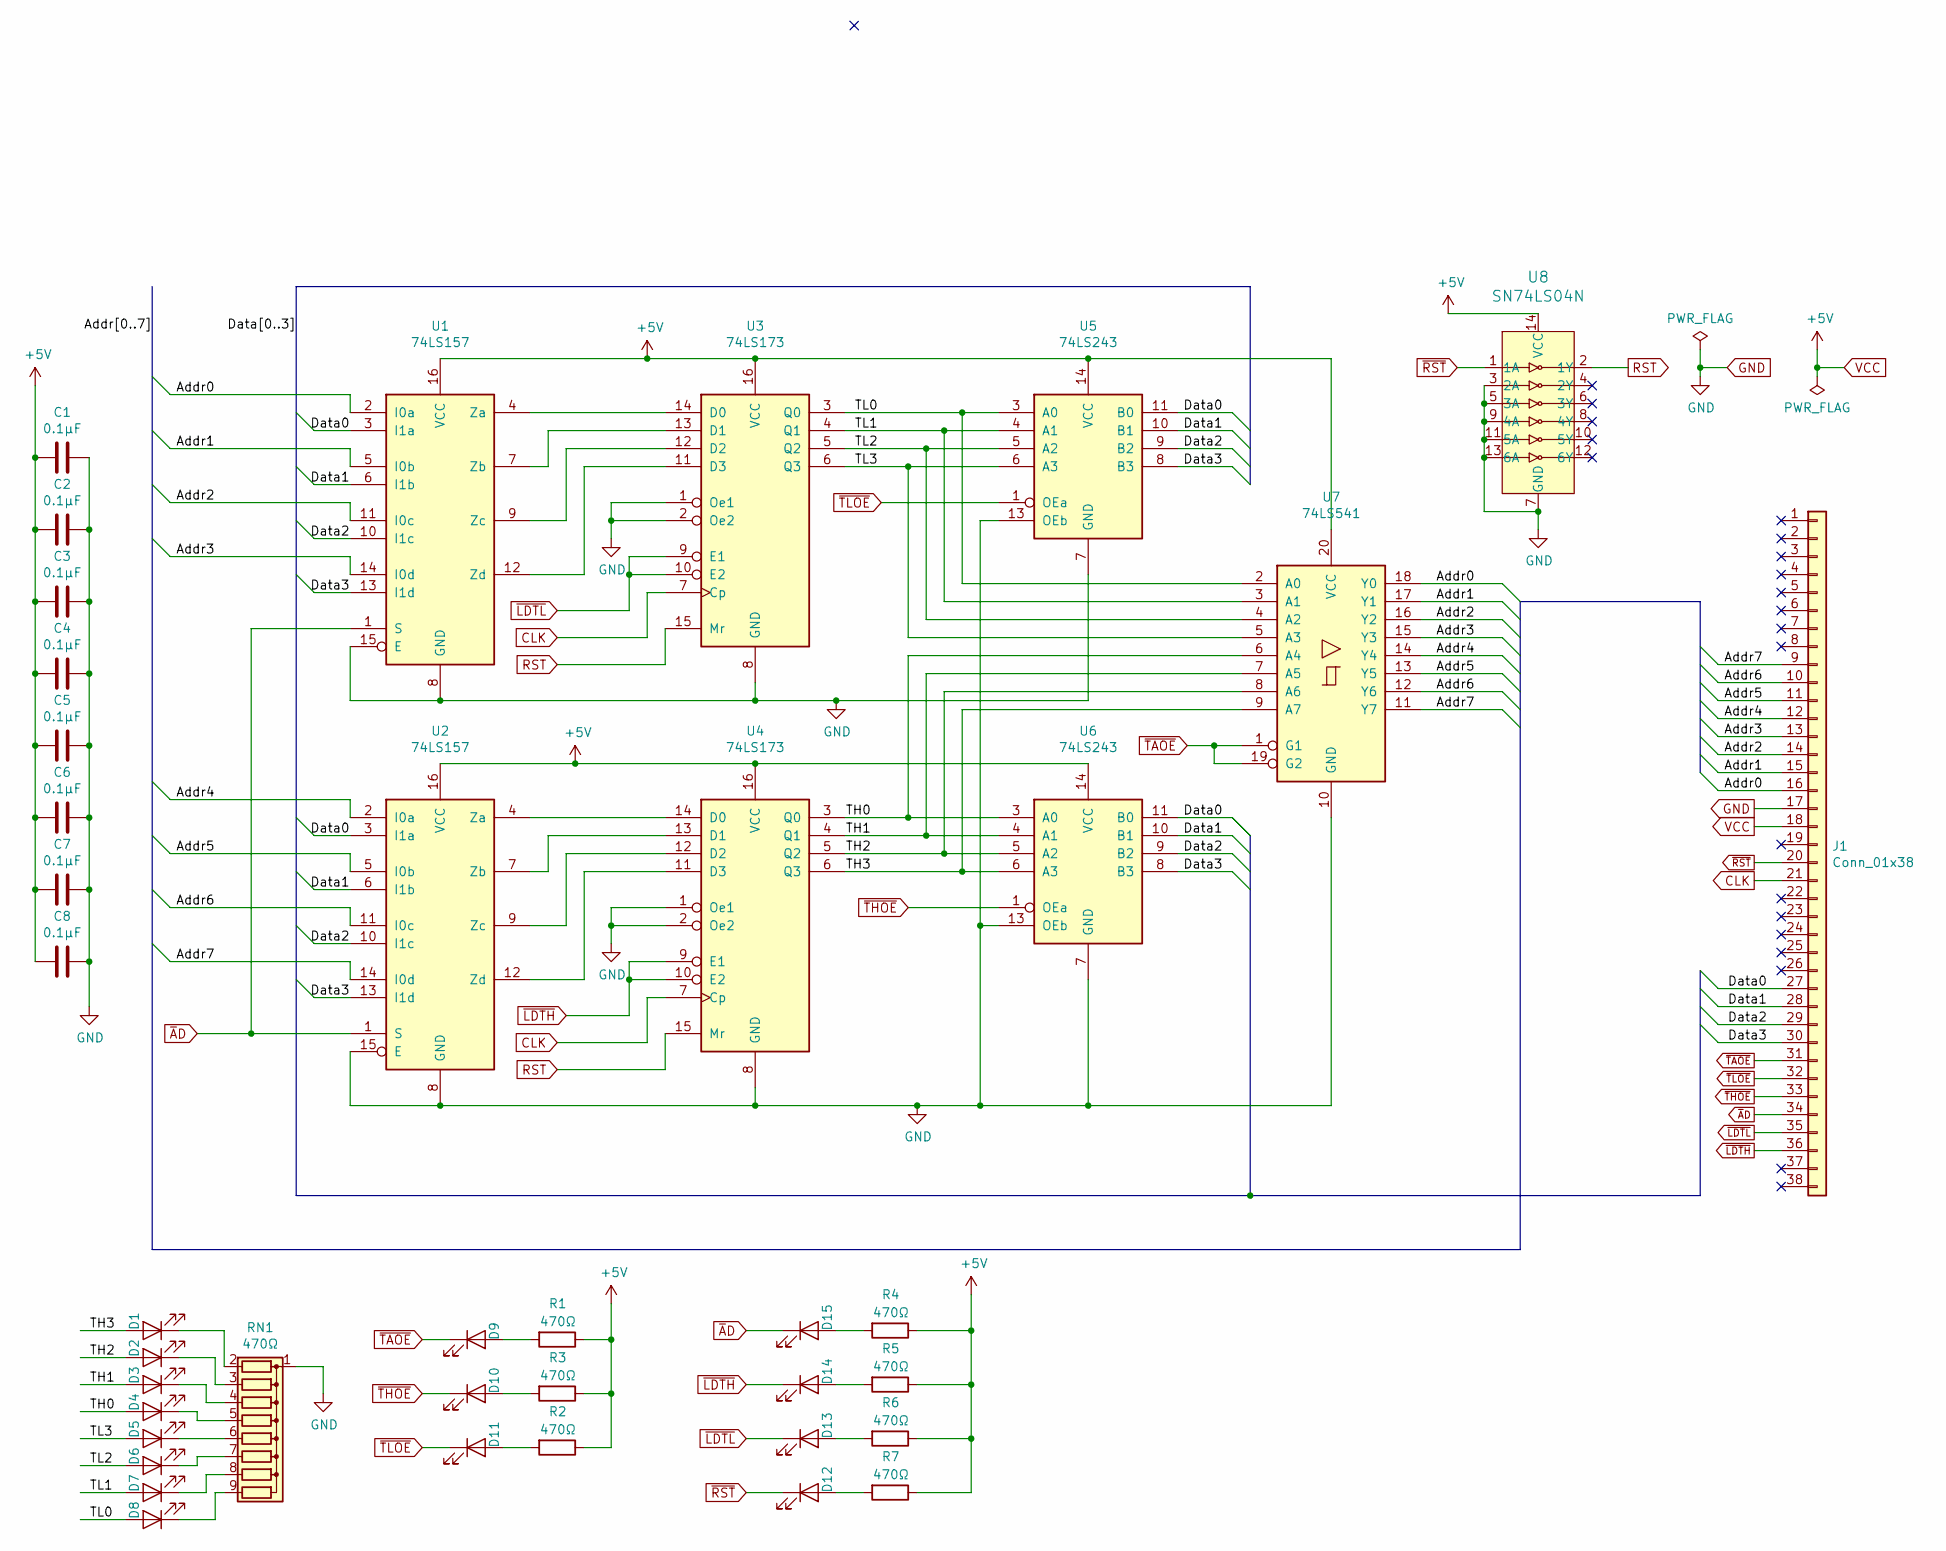
[picture p14: schematic transfer-register-board.sch, YA4B Transfer Register]

Parts:
C1, C2, C3, C4, C5, C6, C7, C8: 0.1µF; C_Disc_D3.4mm_W2.1mm_P2.50mm
D1, D2, D3, D4, D5, D6, D7, D8, D9, D10, D11, D12, D13, D14, D15: LED; LED_Rectangular_W5.0mm_H2.0mm
J1: Conn_01x38; PinHeader_1x38_P2.54mm_Vertical
R1, R2, R3, R4, R5, R6, R7: 470Ω; R_Axial_DIN0207_L6.3mm_D2.5mm_P10.16mm_Horizontal
RN1: 470Ω; R_Array_SIP9
U1, U2: 74LS157; DIP-16_W7.62mm_Socket
U3, U4: 74LS173; DIP-16_W7.62mm_Socket
U5, U6: 74LS243; DIP-14_W7.62mm_Socket
U7: 74LS541; DIP-20_W7.62mm_Socket
U8: SN74LS04N; DIP-14_W7.62mm_Socket; MPN SN74LS04N; Digi-Key_PN 296-1629-5-ND

Connections:
/Addr0: J1.16, U1.2 (I0a), U7.18 (Y0)
/Addr1: J1.15, U1.5 (I0b), U7.17 (Y1)
/Addr2: J1.14, U1.11 (I0c), U7.16 (Y2)
/Addr3: J1.13, U1.14 (I0d), U7.15 (Y3)
/Addr4: J1.12, U2.2 (I0a), U7.14 (Y4)
/Addr5: J1.11, U2.5 (I0b), U7.13 (Y5)
/Addr6: J1.10, U2.11 (I0c), U7.12 (Y6)
/Addr7: J1.9, U2.14 (I0d), U7.11 (Y7)
/Data0: J1.27, U1.3 (I1a), U2.3 (I1a), U5.11 (B0), U6.11 (B0)
/Data1: J1.28, U1.6 (I1b), U2.6 (I1b), U5.10 (B1), U6.10 (B1)
/Data2: J1.29, U1.10 (I1c), U2.10 (I1c), U5.9 (B2), U6.9 (B2)
/Data3: J1.30, U1.13 (I1d), U2.13 (I1d), U5.8 (B3), U6.8 (B3)
/TH0: D4.2 (A), U4.3 (Q0), U6.3 (A0), U7.6 (A4)
/TH1: D3.2 (A), U4.4 (Q1), U6.4 (A1), U7.7 (A5)
/TH2: D2.2 (A), U4.5 (Q2), U6.5 (A2), U7.8 (A6)
/TH3: D1.2 (A), U4.6 (Q3), U6.6 (A3), U7.9 (A7)
/TL0: D8.2 (A), U3.3 (Q0), U5.3 (A0), U7.2 (A0)
/TL1: D7.2 (A), U3.4 (Q1), U5.4 (A1), U7.3 (A1)
/TL2: D6.2 (A), U3.5 (Q2), U5.5 (A2), U7.4 (A2)
/TL3: D5.2 (A), U3.6 (Q3), U5.6 (A3), U7.5 (A3)
CLK: J1.21, U3.7 (Cp), U4.7 (Cp)
GND: C1.1, C2.1, C3.1, C4.1, C5.1, C6.1, C7.1, C8.1, J1.17, RN1.1 (common), U1.8 (GND), U1.15 (E), U2.8 (GND), U2.15 (E), U3.1 (Oe1), U3.2 (Oe2), U3.8 (GND), U4.1 (Oe1), U4.2 (Oe2), U4.8 (GND), U5.7 (GND), U5.13 (OEb), U6.7 (GND), U6.13 (OEb), U7.10 (GND), U8.3 (2A), U8.5 (3A), U8.7 (GND), U8.9 (4A), U8.11 (5A), U8.13 (6A)
unnamed: D1.1 (K), RN1.2 (R1)
unnamed: D2.1 (K), RN1.3 (R2)
unnamed: D3.1 (K), RN1.4 (R3)
unnamed: D4.1 (K), RN1.5 (R4)
unnamed: D5.1 (K), RN1.6 (R5)
unnamed: D6.1 (K), RN1.7 (R6)
unnamed: D7.1 (K), RN1.8 (R7)
unnamed: D8.1 (K), RN1.9 (R8)
unnamed: D9.2 (A), R1.2
unnamed: D10.2 (A), R3.2
unnamed: D11.2 (A), R2.2
unnamed: D12.2 (A), R7.2
unnamed: D13.2 (A), R6.2
unnamed: D14.2 (A), R5.2
unnamed: D15.2 (A), R4.2
unnamed: U1.4 (Za), U3.14 (D0)
unnamed: U1.7 (Zb), U3.13 (D1)
unnamed: U1.9 (Zc), U3.12 (D2)
unnamed: U1.12 (Zd), U3.11 (D3)
unnamed: U2.4 (Za), U4.14 (D0)
unnamed: U2.7 (Zb), U4.13 (D1)
unnamed: U2.9 (Zc), U4.12 (D2)
unnamed: U2.12 (Zd), U4.11 (D3)
RST: U3.15 (Mr), U4.15 (Mr), U8.2 (1Y)
VCC: C1.2, C2.2, C3.2, C4.2, C5.2, C6.2, C7.2, C8.2, J1.18, R1.1, R2.1, R3.1, R4.1, R5.1, R6.1, R7.1, U1.16 (VCC), U2.16 (VCC), U3.16 (VCC), U4.16 (VCC), U5.14 (VCC), U6.14 (VCC), U7.20 (VCC), U8.14 (VCC)
~A~D: D15.1 (K), J1.34, U1.1 (S), U2.1 (S)
~LDTH~: D14.1 (K), J1.36, U4.9 (E1), U4.10 (E2)
~LDTL~: D13.1 (K), J1.35, U3.9 (E1), U3.10 (E2)
~RST~: D12.1 (K), J1.20, U8.1 (1A)
~TAOE~: D9.1 (K), J1.31, U7.1 (G1), U7.19 (G2)
~THOE~: D10.1 (K), J1.33, U6.1 (OEa)
~TLOE~: D11.1 (K), J1.32, U5.1 (OEa)

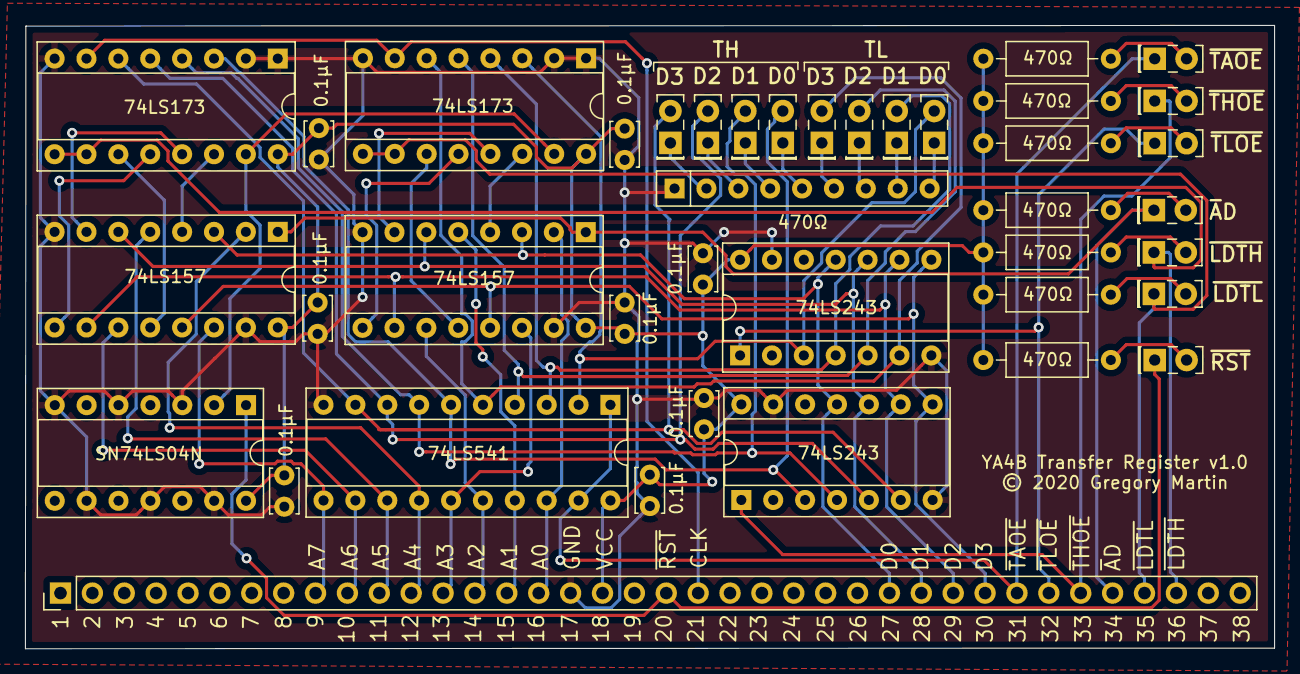
[picture p15: board transfer-register-board.kicad_pcb from above]

Board: 2 copper layers, 99.5 x 49.7 mm, 40 parts (0 on the bottom side), 54 nets.
