lafehubert/electronics/ya4b/slow-clock/slow-clock.kicad_pcb

## KiCad design ya4b/slow-clock/slow-clock.kicad_pcb (2019-12-26)

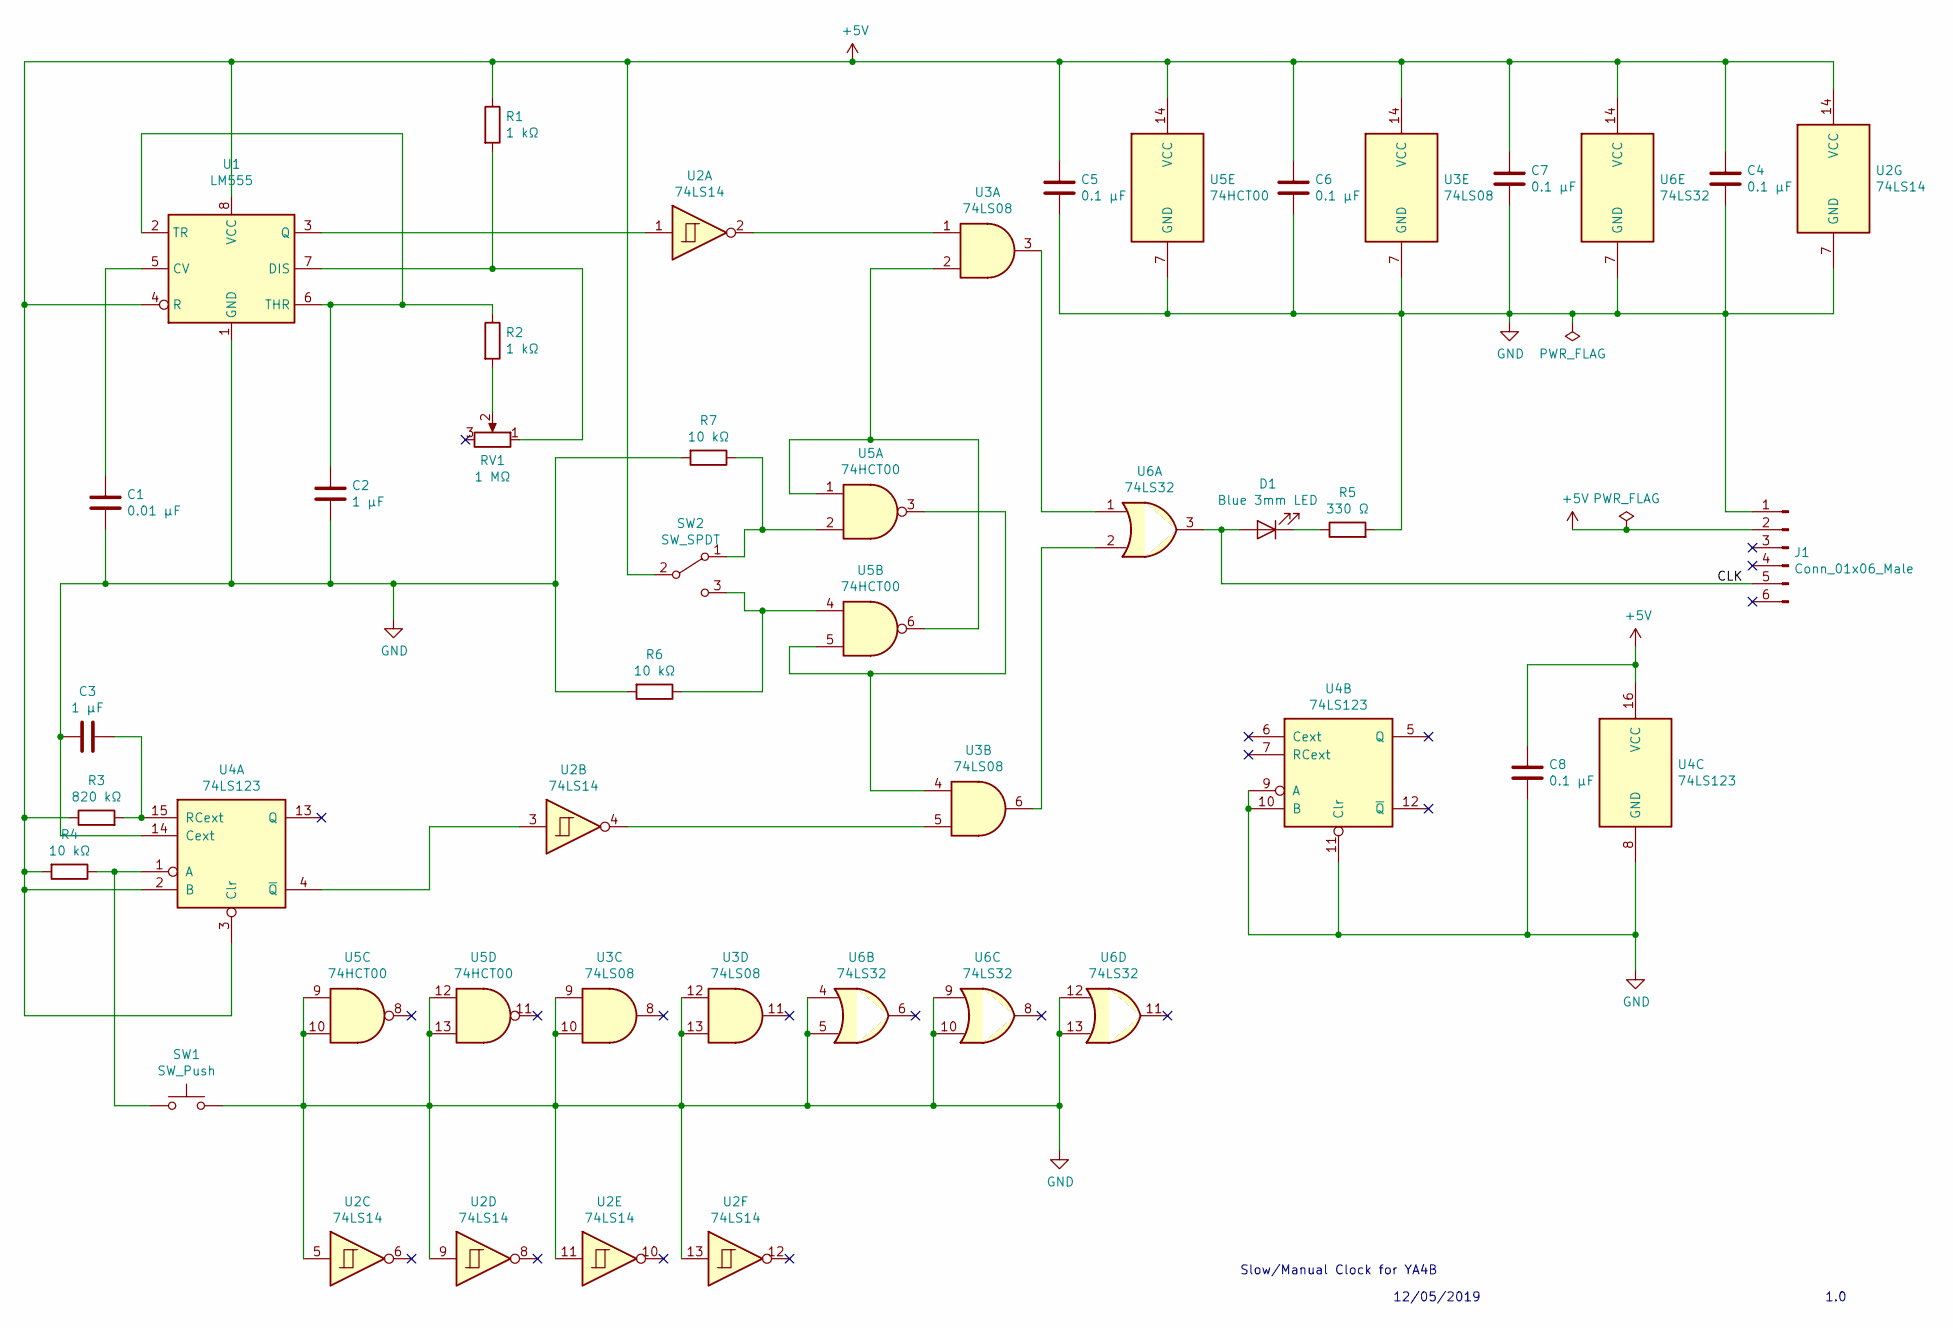
[picture p16: schematic slow-clock.sch]

Parts:
C1: 0.01 µF; C_Disc_D3.8mm_W2.6mm_P2.50mm
C2, C3: 1 µF; C_Disc_D3.8mm_W2.6mm_P2.50mm
C4, C5, C6, C7, C8: 0.1 µF; C_Disc_D3.8mm_W2.6mm_P2.50mm
D1: Blue 3mm LED; LED_D3.0mm
J1: Conn_01x06_Male; PinHeader_1x06_P2.54mm_Vertical
R1, R2: 1 kΩ; R_Axial_DIN0207_L6.3mm_D2.5mm_P10.16mm_Horizontal
R3: 820 kΩ; R_Axial_DIN0207_L6.3mm_D2.5mm_P10.16mm_Horizontal
R4, R6, R7: 10 kΩ; R_Axial_DIN0207_L6.3mm_D2.5mm_P10.16mm_Horizontal
R5: 330 Ω; R_Axial_DIN0207_L6.3mm_D2.5mm_P10.16mm_Horizontal
RV1: 1 MΩ; GM_Small_Square_9mm_Pot
SW1: SW_Push; SW_PUSH_6mm
SW2: SW_SPDT; GM_SPDT_Slide_Switch
U1: LM555; DIP-8_W7.62mm_Socket
U2: 74LS14; DIP-14_W7.62mm_Socket
U3: 74LS08; DIP-14_W7.62mm_Socket
U4: 74LS123; DIP-16_W7.62mm_Socket
U5: 74HCT00; DIP-14_W7.62mm_Socket
U6: 74LS32; DIP-14_W7.62mm_Socket

Connections:
+5V: C4.1, C5.1, C6.1, C7.1, C8.1, J1.2, R1.1, R3.1, R4.2, SW2.2 (B), U1.4 (R), U1.8 (VCC), U2.14 (VCC), U3.14 (VCC), U4.2 (B), U4.3 (Clr), U4.16 (VCC), U5.14 (VCC), U6.14 (VCC)
/CLK: D1.2 (A), J1.5, U6.3
GND: C1.2, C2.2, C3.2, C4.2, C5.2, C6.2, C7.2, C8.2, J1.1, R5.2, R6.2, R7.2, SW1.2, U1.1 (GND), U2.5, U2.7 (GND), U2.9, U2.11, U2.13, U3.7 (GND), U3.9, U3.10, U3.12, U3.13, U4.8 (GND), U4.9 (A), U4.10 (B), U4.11 (Clr), U4.14 (Cext), U5.7 (GND), U5.9, U5.10, U5.12, U5.13, U6.4, U6.5, U6.7 (GND), U6.9, U6.10, U6.12, U6.13
unnamed: C1.1, U1.5 (CV)
unnamed: C2.1, R2.1, U1.2 (TR), U1.6 (THR)
unnamed: C3.1, R3.2, U4.15 (RCext)
unnamed: D1.1 (K), R5.1
unnamed: R1.2, RV1.1, U1.7 (DIS)
unnamed: R2.2, RV1.2
unnamed: R4.1, SW1.1, U4.1 (A)
unnamed: R6.1, SW2.3 (C), U5.4
unnamed: R7.1, SW2.1 (A), U5.2
unnamed: U1.3 (Q), U2.1
unnamed: U2.2, U3.1
unnamed: U2.3, U4.4 (~Q)
unnamed: U2.4, U3.5
unnamed: U3.2, U5.1, U5.6
unnamed: U3.3, U6.1
unnamed: U3.4, U5.3, U5.5
unnamed: U3.6, U6.2

Notes on the sheet:
Slow/Manual Clock for YA4B
12/05/2019
1.0

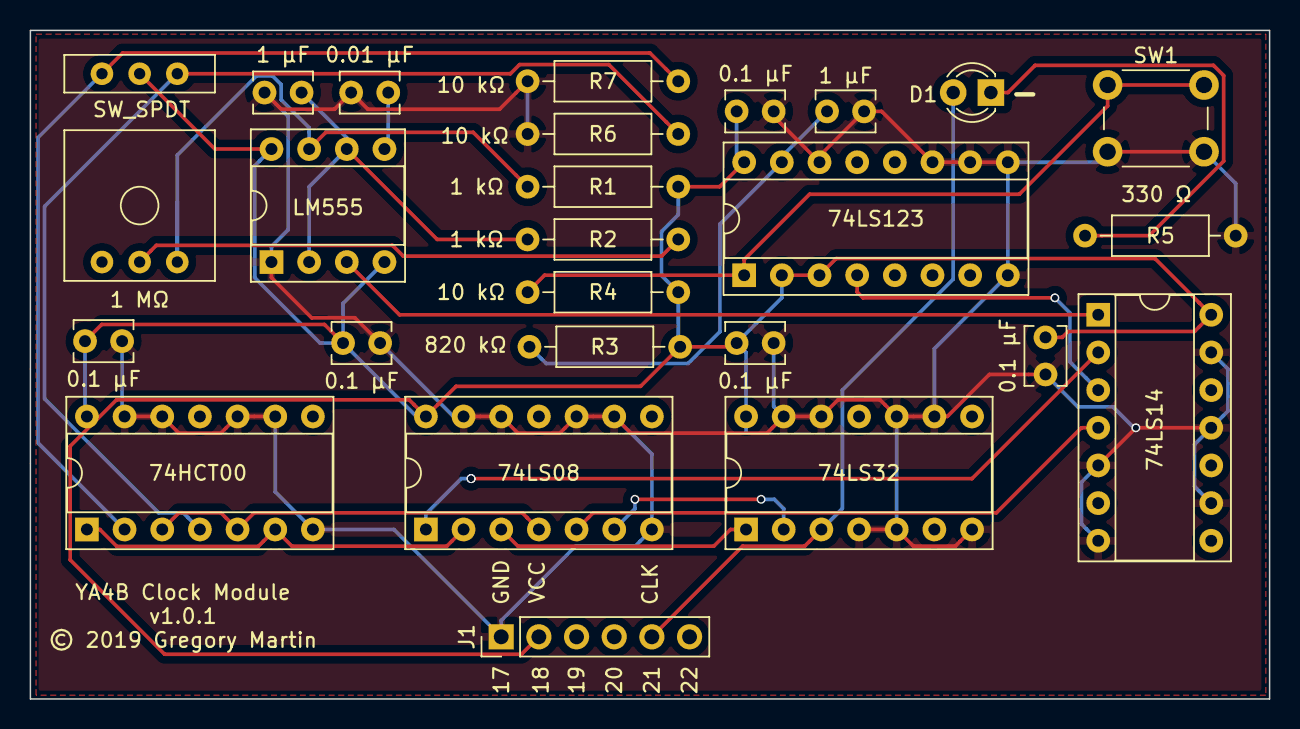
[picture p17: board slow-clock.kicad_pcb from above]

Board: 2 copper layers, 83.6 x 45.1 mm, 26 parts (0 on the bottom side), 20 nets.
