lafehubert/electronics/ya4b/ram-32-word/ram-32-word.kicad_pcb

## KiCad design ya4b/ram-32-word/ram-32-word.kicad_pcb (2019-12-26)

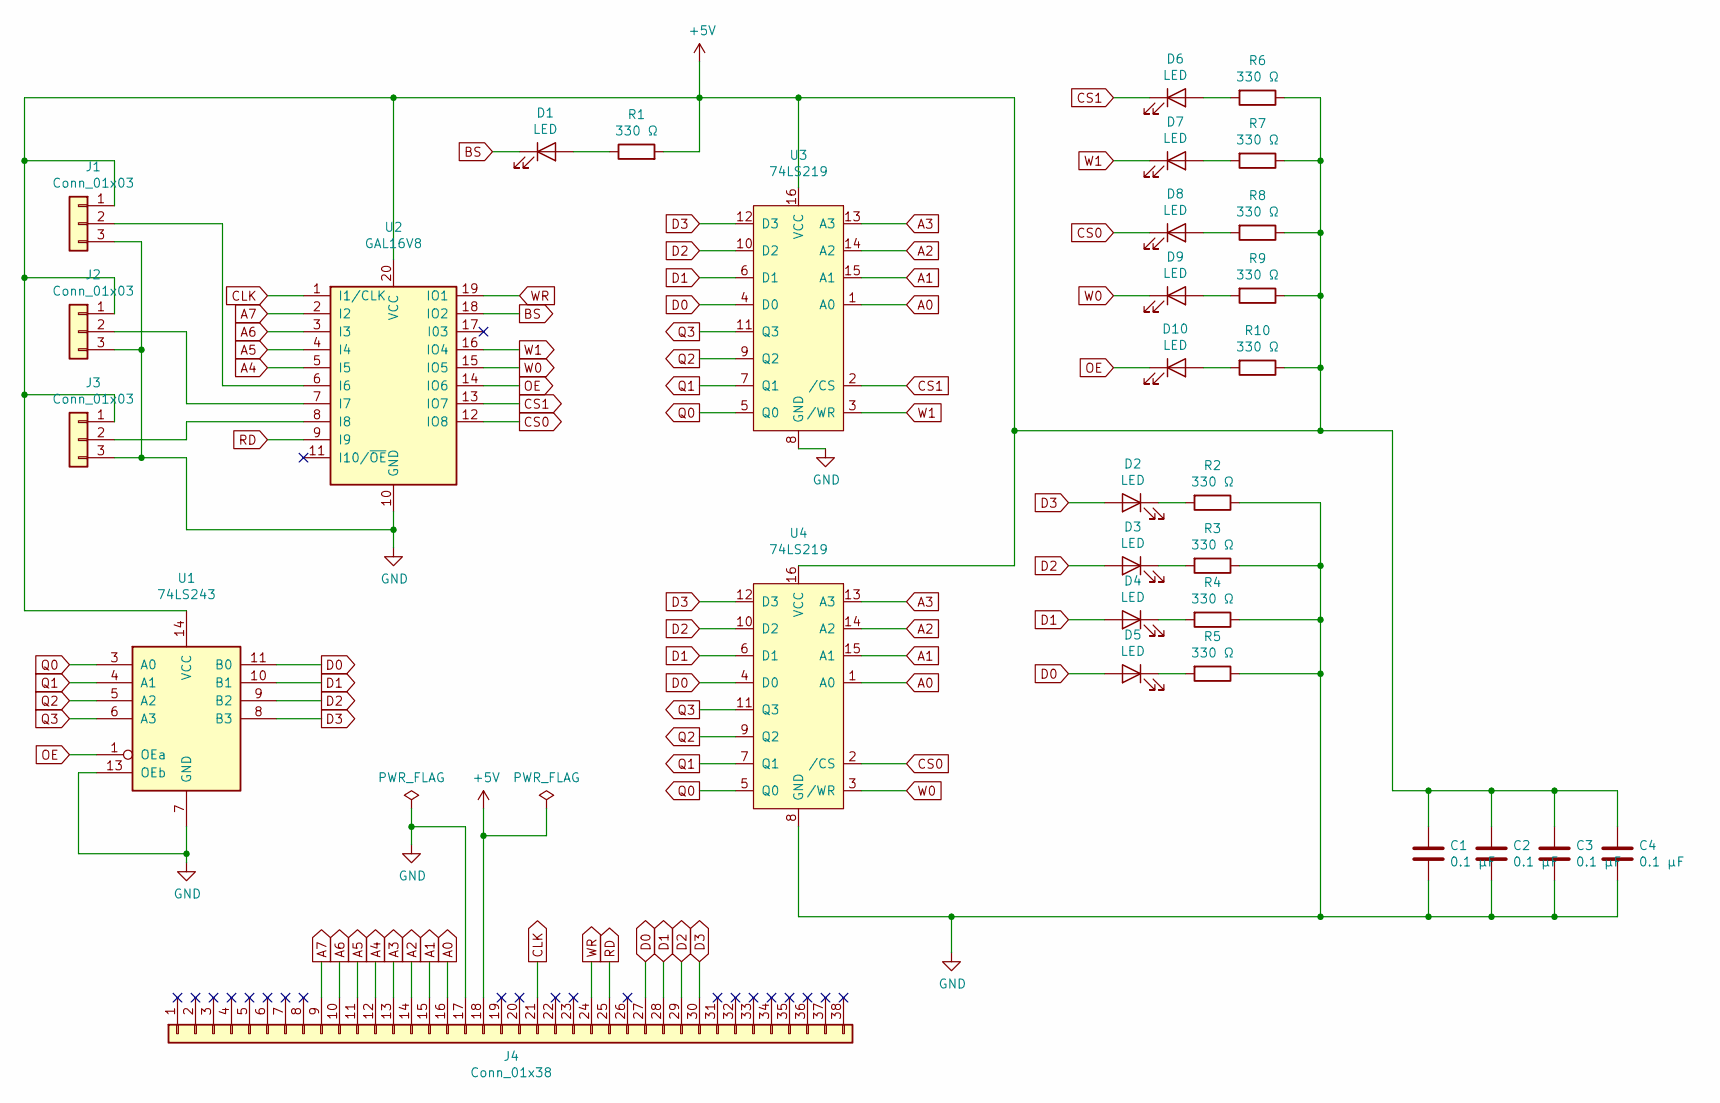
[picture p18: schematic ram-32-word.sch]

Parts:
C1, C2, C3, C4: 0.1 µF; C_Disc_D3.8mm_W2.6mm_P2.50mm
D1, D2, D3, D4, D5, D6, D7, D8, D9, D10: LED; LED_Rectangular_W5.0mm_H2.0mm
J1, J2, J3: Conn_01x03; PinHeader_1x03_P2.54mm_Vertical
J4: Conn_01x38; PinHeader_1x38_P2.54mm_Vertical
R1, R2, R3, R4, R5, R6, R7, R8, R9, R10: 330 Ω; R_Axial_DIN0207_L6.3mm_D2.5mm_P10.16mm_Horizontal
U1: 74LS243; DIP-14_W7.62mm_Socket
U2: GAL16V8; DIP-20_W7.62mm_Socket
U3, U4: 74LS219; DIP-16_W7.62mm_Socket

Connections:
+5V: C1.1, C2.1, C3.1, C4.1, J1.1, J2.1, J3.1, J4.18, R1.2, R6.1, R7.1, R8.1, R9.1, R10.1, U1.14 (VCC), U2.20 (VCC), U3.16 (VCC), U4.16 (VCC)
A0: J4.16, U3.1 (A0), U4.1 (A0)
A1: J4.15, U3.15 (A1), U4.15 (A1)
A2: J4.14, U3.14 (A2), U4.14 (A2)
A3: J4.13, U3.13 (A3), U4.13 (A3)
A4: J4.12, U2.5 (I5)
A5: J4.11, U2.4 (I4)
A6: J4.10, U2.3 (I3)
A7: J4.9, U2.2 (I2)
BS: D1.1 (K), U2.18 (IO2)
CLK: J4.21, U2.1 (I1/CLK)
CS0: D8.1 (K), U2.12 (IO8), U4.2 (/CS)
CS1: D6.1 (K), U2.13 (IO7), U3.2 (/CS)
D0: D5.2 (A), J4.27, U1.11 (B0), U3.4 (D0), U4.4 (D0)
D1: D4.2 (A), J4.28, U1.10 (B1), U3.6 (D1), U4.6 (D1)
D2: D3.2 (A), J4.29, U1.9 (B2), U3.10 (D2), U4.10 (D2)
D3: D2.2 (A), J4.30, U1.8 (B3), U3.12 (D3), U4.12 (D3)
GND: C1.2, C2.2, C3.2, C4.2, J1.3, J2.3, J3.3, J4.17, R2.1, R3.1, R4.1, R5.1, U1.7 (GND), U1.13 (OEb), U2.10 (GND), U3.8 (GND), U4.8 (GND)
unnamed: D1.2 (A), R1.1
unnamed: D2.1 (K), R2.2
unnamed: D3.1 (K), R3.2
unnamed: D4.1 (K), R4.2
unnamed: D5.1 (K), R5.2
unnamed: D6.2 (A), R6.2
unnamed: D7.2 (A), R7.2
unnamed: D8.2 (A), R8.2
unnamed: D9.2 (A), R9.2
unnamed: D10.2 (A), R10.2
unnamed: J1.2, U2.6 (I6)
unnamed: J2.2, U2.7 (I7)
unnamed: J3.2, U2.8 (I8)
OE: D10.1 (K), U1.1 (OEa), U2.14 (IO6)
Q0: U1.3 (A0), U3.5 (Q0), U4.5 (Q0)
Q1: U1.4 (A1), U3.7 (Q1), U4.7 (Q1)
Q2: U1.5 (A2), U3.9 (Q2), U4.9 (Q2)
Q3: U1.6 (A3), U3.11 (Q3), U4.11 (Q3)
RD: J4.25, U2.9 (I9)
W0: D9.1 (K), U2.15 (IO5), U4.3 (/WR)
W1: D7.1 (K), U2.16 (IO4), U3.3 (/WR)
WR: J4.24, U2.19 (IO1)

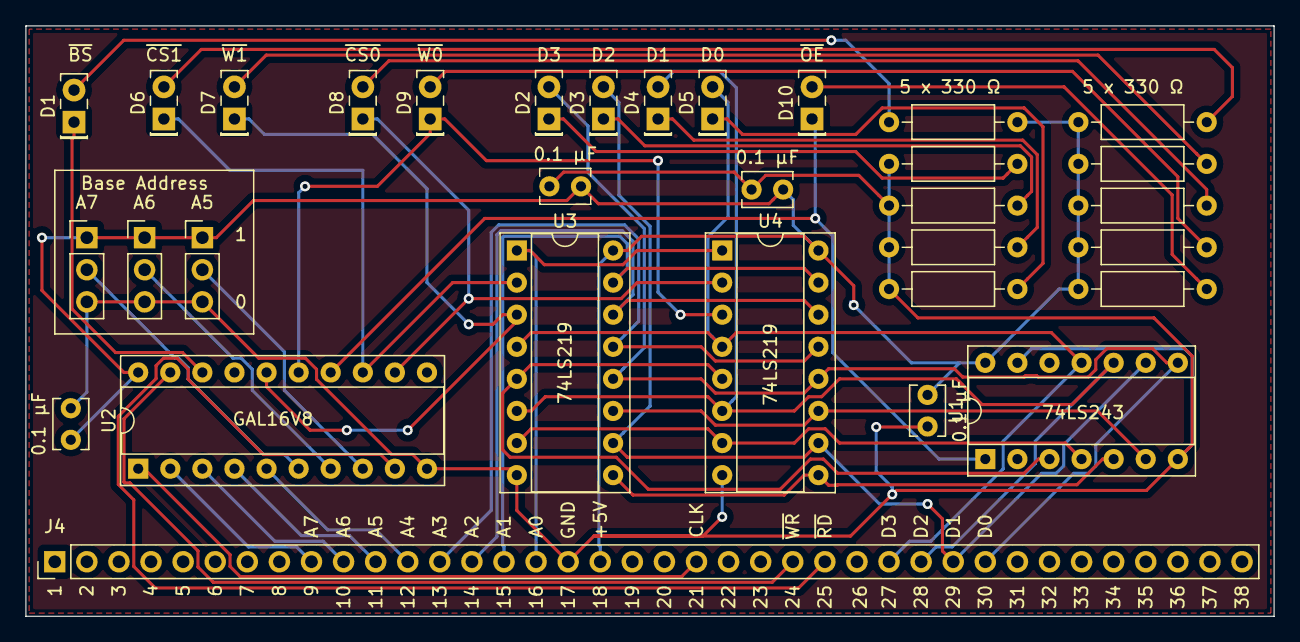
[picture p19: board ram-32-word.kicad_pcb from above]

Board: 2 copper layers, 98.8 x 46.7 mm, 32 parts (0 on the bottom side), 40 nets.
