lafehubert/electronics/ya4b/data-register/data-register-bank/data-register-bank.kicad_pcb

## KiCad design ya4b/data-register/data-register-bank/data-register-bank.kicad_pcb (2020-04-27)

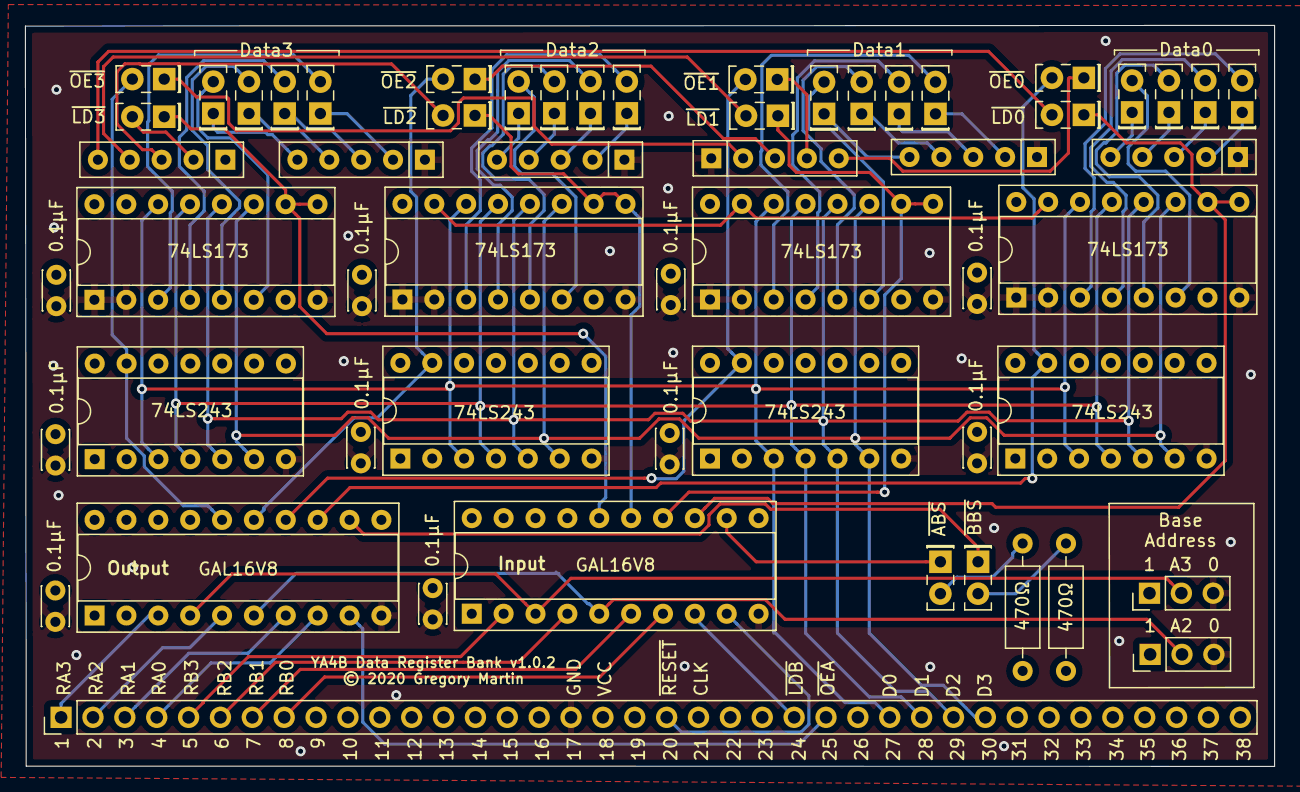
[picture p20: board data-register-bank.kicad_pcb from above]

Board: 4 copper layers, 99.6 x 59.1 mm, 57 parts (0 on the bottom side), 73 nets.

Parts:
C1, C2, C3, C4, C5, C6, C7, C8, C9, C10: 0.1µF; C_Disc_D3.0mm_W2.0mm_P2.50mm
D1, D2, D3, D4, D5, D6, D7, D8, D9, D10, D11, D12, D13, D14, D15, D16, D17, D18, D19, D20, D21, D22, D23, D24, D25, D26: LED; LED_Rectangular_W5.0mm_H2.0mm
J1: Conn_01x38; PinHeader_1x38_P2.54mm_Vertical
JP1, JP2: Jumper_3_Bridged12; PinHeader_1x03_P2.54mm_Vertical
R1, R2: 470Ω; R_Axial_DIN0207_L6.3mm_D2.5mm_P10.16mm_Horizontal
RN1, RN2, RN3, RN4, RN5, RN6: 470Ω; R_Array_SIP5
U1, U2: GAL16V8; DIP-20_W7.62mm_Socket
U3, U5, U7, U9: 74LS243; DIP-14_W7.62mm_Socket
U4, U6, U8, U10: 74LS173; DIP-16_W7.62mm_Socket

Connections:
/Data0: J1.27, U3.3, U4.14, U5.3, U6.14, U7.3, U8.14, U9.3, U10.14
/Data1: J1.28, U3.4, U4.13, U5.4, U6.13, U7.4, U8.13, U9.4, U10.13
/Data2: J1.29, U3.5, U4.12, U5.5, U6.12, U7.5, U8.12, U9.5, U10.12
/Data3: J1.30, U3.6, U4.11, U5.6, U6.11, U7.6, U8.11, U9.6, U10.11
CLK: J1.21, U4.7, U6.7, U8.7, U10.7
D0_0: D13.2, U9.11, U10.3
D0_1: D14.2, U9.10, U10.4
D0_2: D15.2, U9.9, U10.5
D0_3: D16.2, U9.8, U10.6
D1_0: D9.2, U7.11, U8.3
D1_1: D10.2, U7.10, U8.4
D1_2: D11.2, U7.9, U8.5
D1_3: D12.2, U7.8, U8.6
D2_0: D5.2, U5.11, U6.3
D2_1: D6.2, U5.10, U6.4
D2_2: D7.2, U5.9, U6.5
D2_3: D8.2, U5.8, U6.6
D3_0: D1.2, U3.11, U4.3
D3_1: D2.2, U3.10, U4.4
D3_2: D3.2, U3.9, U4.5
D3_3: D4.2, U3.8, U4.6
GND: C1.2, C2.2, C3.2, C4.2, C5.2, C6.2, C7.2, C8.2, C9.2, C10.2, J1.17, JP1.3, JP2.3, RN1.1, RN2.1, RN3.1, RN4.1, RN6.1, U1.10, U2.10, U3.7, U4.1, U4.2, U4.8, U5.7, U6.1, U6.2, U6.8, U7.7, U8.1, U8.2, U8.8, U9.7, U10.1, U10.2, U10.8
JP2: JP2.2, U1.5, U2.6
JP3: JP1.2, U1.3, U2.4
unnamed: D1.1, RN1.2
unnamed: D2.1, RN1.3
unnamed: D3.1, RN1.4
unnamed: D4.1, RN1.5
unnamed: D5.1, RN2.2
unnamed: D6.1, RN2.3
unnamed: D7.1, RN2.4
unnamed: D8.1, RN2.5
unnamed: D9.1, RN3.2
unnamed: D10.1, RN3.3
unnamed: D11.1, RN3.4
unnamed: D12.1, RN3.5
unnamed: D13.1, RN4.2
unnamed: D14.1, RN4.3
unnamed: D15.1, RN4.4
unnamed: D16.1, RN4.5
unnamed: D17.2, RN5.2
unnamed: D18.2, RN5.3
unnamed: D19.2, RN5.4
unnamed: D20.2, RN5.5
unnamed: D21.1, RN6.2
unnamed: D22.1, RN6.3
unnamed: D23.1, RN6.4
unnamed: D24.1, RN6.5
unnamed: D25.2, R1.2
unnamed: D26.2, R2.2
OE0: D24.2, U2.13, U9.13
OE1: D23.2, U2.14, U7.13
OE2: D22.2, U2.15, U5.13
OE3: D21.2, U2.16, U3.13
RA0: J1.4, U2.8
RA1: J1.3, U2.7
RA2: J1.2, U2.5
RA3: J1.1, U2.3
RB0: J1.8, U1.7
RB1: J1.7, U1.6
RB2: J1.6, U1.4
RB3: J1.5, U1.2
RST: U1.17, U4.15, U6.15, U8.15, U10.15
VCC: C1.1, C2.1, C3.1, C4.1, C5.1, C6.1, C7.1, C8.1, C9.1, C10.1, J1.18, JP1.1, JP2.1, R1.1, R2.1, RN5.1, U1.1, U1.11, U1.20, U2.1, U2.2, U2.11, U2.20, U3.1, U3.14, U4.16, U5.1, U5.14, U6.16, U7.1, U7.14, U8.16, U9.1, U9.14, U10.16
~ABS~: D25.1, U2.12
~AOE~: J1.25, U2.9
~BBS~: D26.1, U1.12
~LD0~: D20.1, U1.13, U10.9, U10.10
~LD1~: D19.1, U1.14, U8.9, U8.10
~LD2~: D18.1, U1.15, U6.9, U6.10
~LD3~: D17.1, U1.16, U4.9, U4.10
~LDB~: J1.24, U1.8
~RESET~: J1.20, U1.9
