lafehubert/electronics/ya4b/data-register/data-register-control/data-register-control-output/data-register-control-output-patched.sch

## KiCad design ya4b/data-register/data-register-control/data-register-control-output/data-register-control-output-patched.sch (2020-03-11)

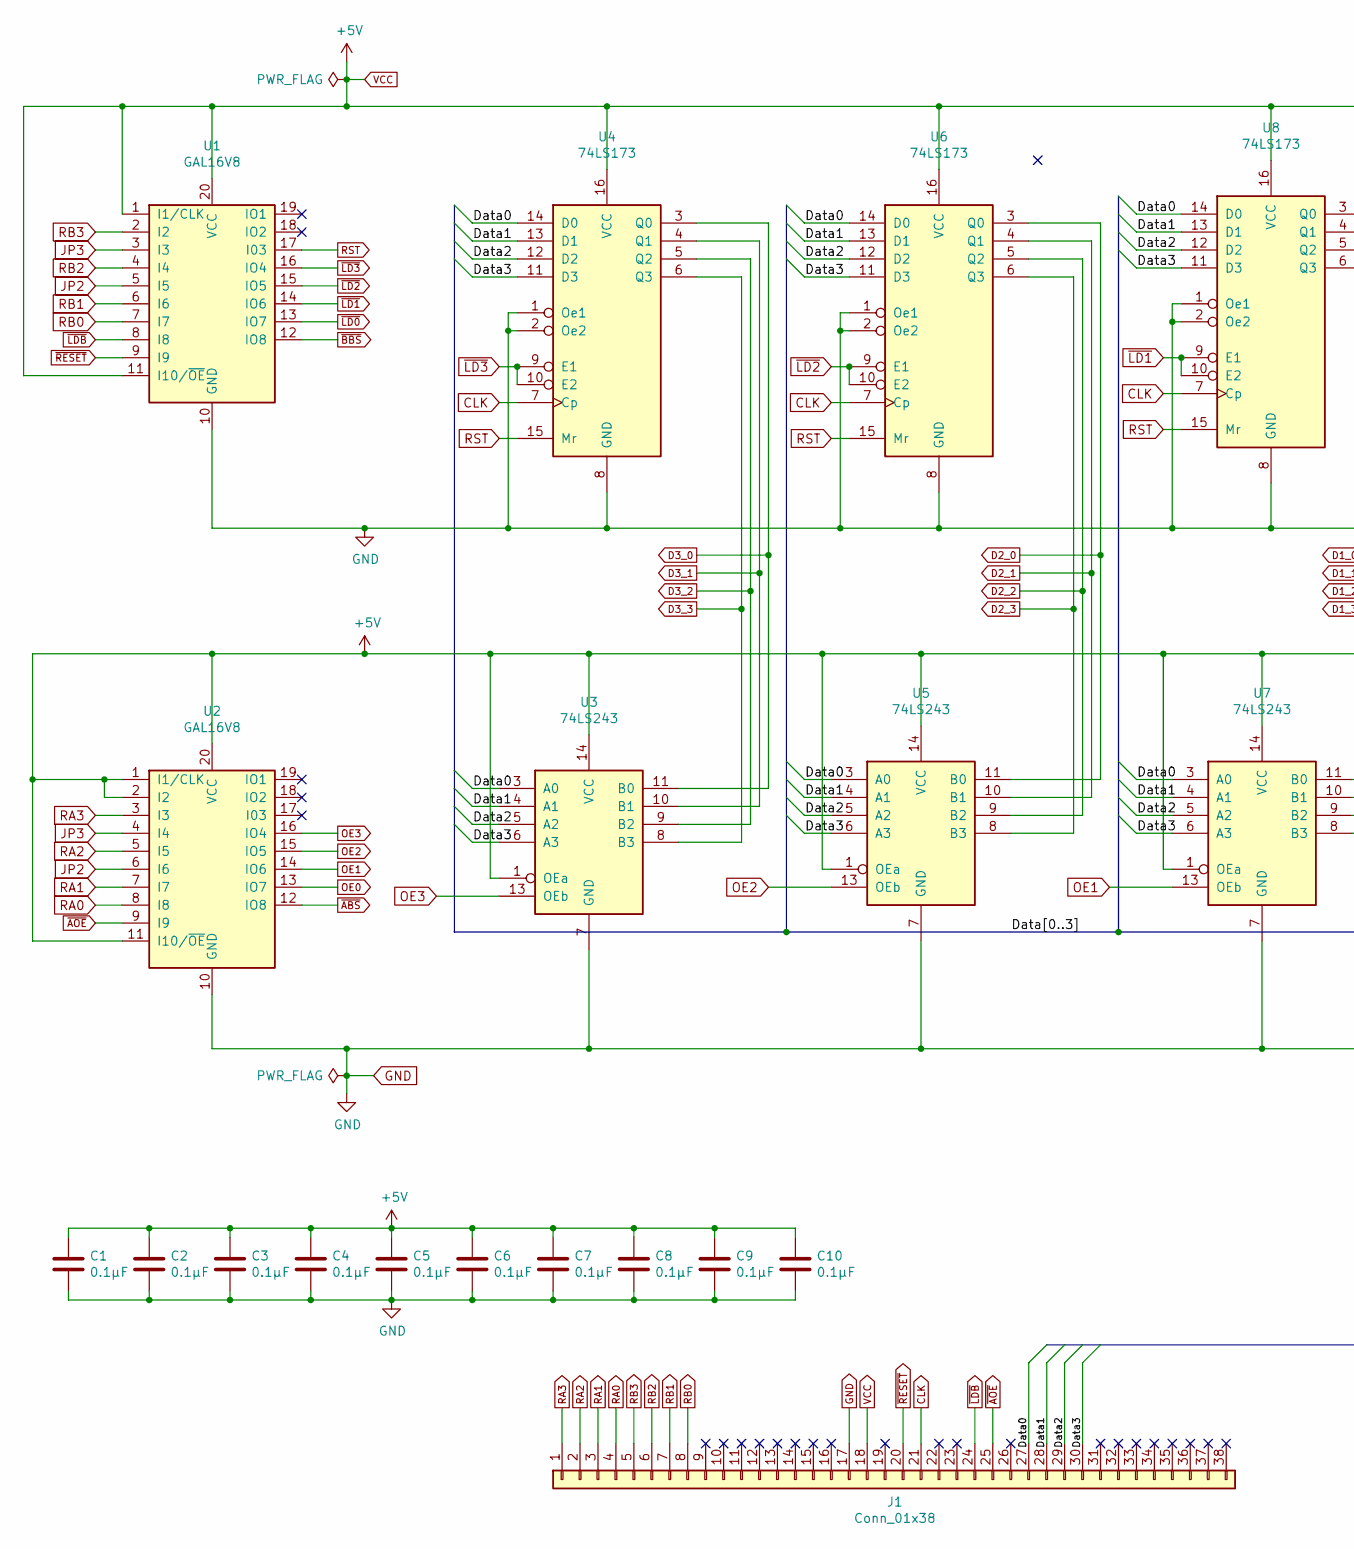
[picture p21: schematic data-register-control-output-patched.sch, part in row 1, column 1]

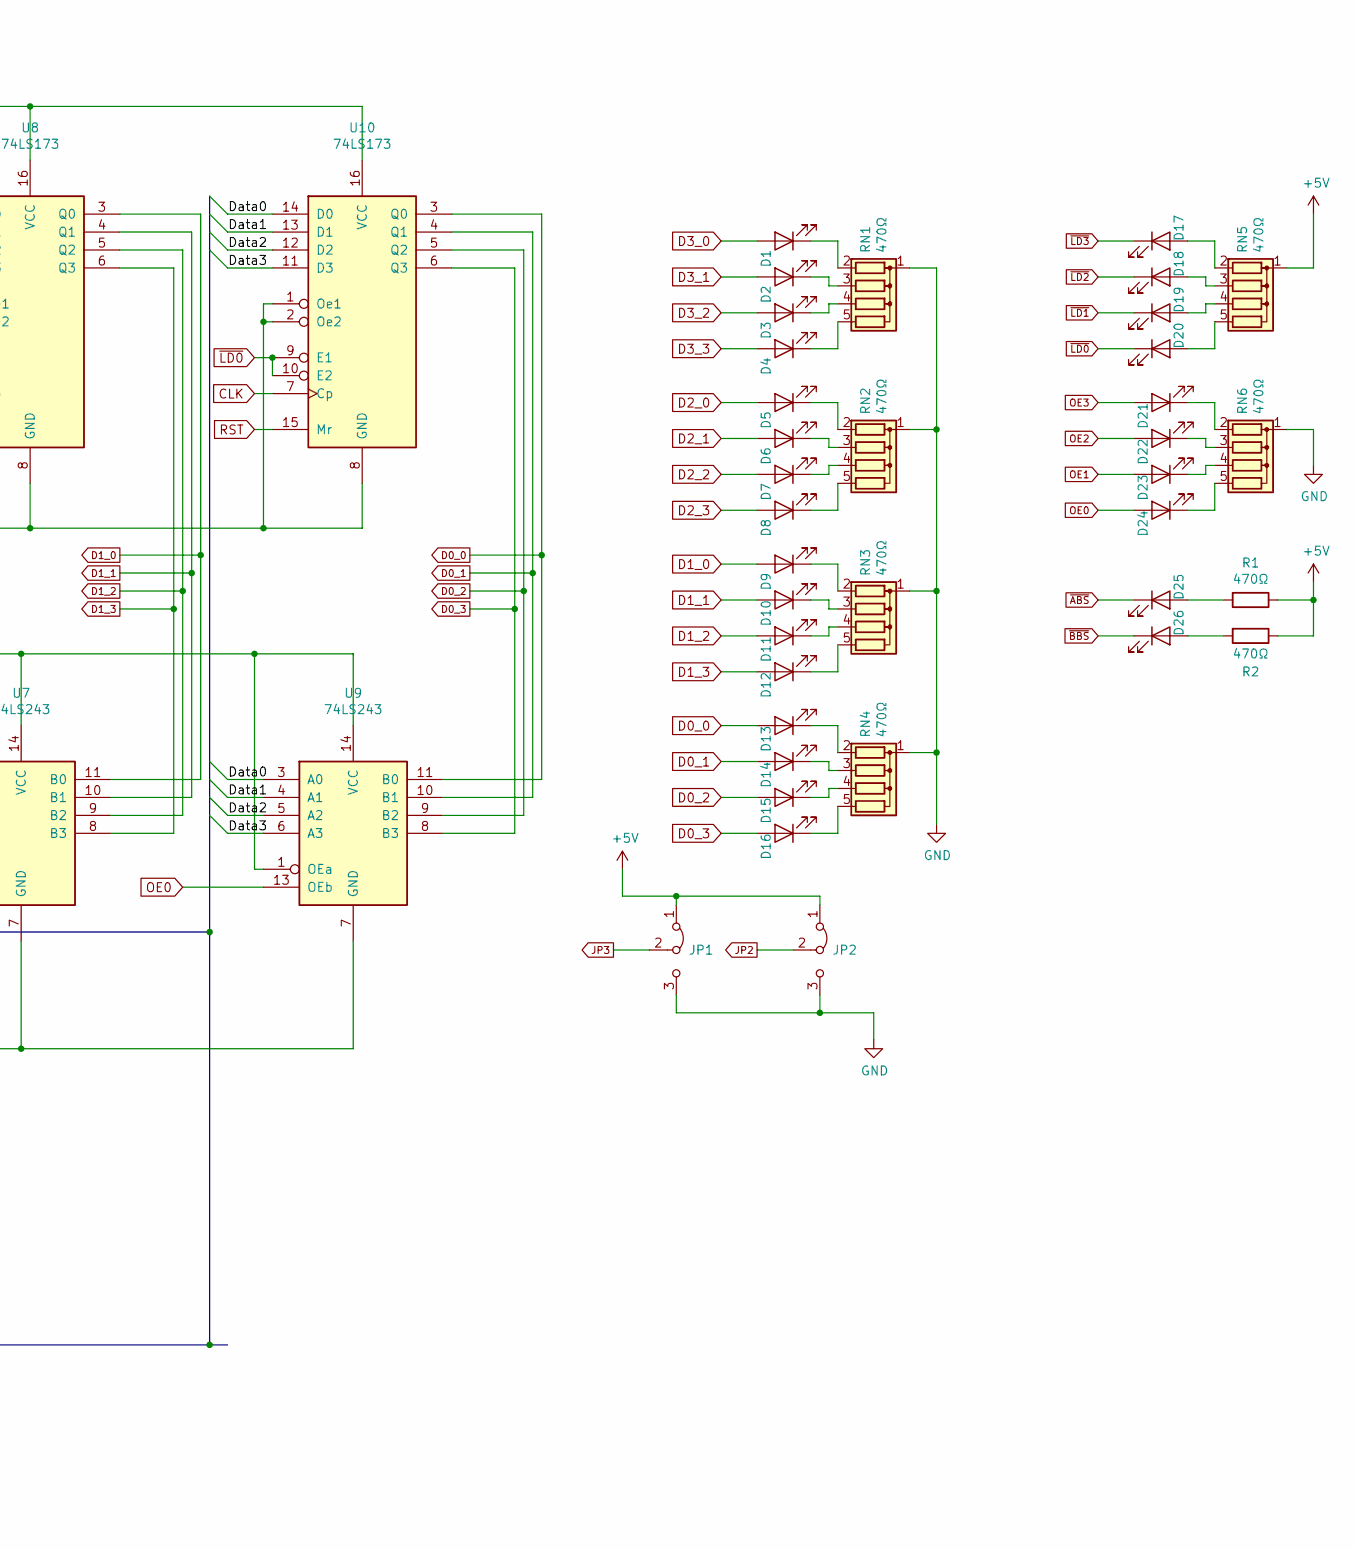
[picture p22: schematic data-register-control-output-patched.sch, part in row 1, column 2]

Parts:
C1, C2, C3, C4, C5, C6, C7, C8, C9, C10: 0.1µF; C_Disc_D3.0mm_W2.0mm_P2.50mm
D1, D2, D3, D4, D5, D6, D7, D8, D9, D10, D11, D12, D13, D14, D15, D16, D17, D18, D19, D20, D21, D22, D23, D24, D25, D26: LED; LED_Rectangular_W5.0mm_H2.0mm
J1: Conn_01x38; PinHeader_1x38_P2.54mm_Vertical
JP1, JP2: Jumper_3_Bridged12; PinHeader_1x03_P2.54mm_Vertical
R1, R2: 470Ω; R_Axial_DIN0207_L6.3mm_D2.5mm_P10.16mm_Horizontal
RN1, RN2, RN3, RN4, RN5, RN6: 470Ω; R_Array_SIP5
U1, U2: GAL16V8; DIP-20_W7.62mm_Socket
U3, U5, U7, U9: 74LS243; DIP-14_W7.62mm_Socket
U4, U6, U8, U10: 74LS173; DIP-16_W7.62mm_Socket

Connections:
+5V: C1.1, C2.1, C3.1, C4.1, C5.1, C6.1, C7.1, C8.1, C9.1, C10.1, J1.18, JP1.1 (A), JP2.1 (A), R1.1, R2.1, RN5.1 (common), U1.1 (I1/CLK), U1.11 (I10/~OE~), U1.20 (VCC), U2.1 (I1/CLK), U2.2 (I2), U2.11 (I10/~OE~), U2.20 (VCC), U3.1 (OEa), U3.14 (VCC), U4.16 (VCC), U5.1 (OEa), U5.14 (VCC), U6.16 (VCC), U7.1 (OEa), U7.14 (VCC), U8.16 (VCC), U9.1 (OEa), U9.14 (VCC), U10.16 (VCC)
CLK: J1.21, U4.7 (Cp), U6.7 (Cp), U8.7 (Cp), U10.7 (Cp)
D0_0: D13.2 (A), U9.11 (B0), U10.3 (Q0)
D0_1: D14.2 (A), U9.10 (B1), U10.4 (Q1)
D0_2: D15.2 (A), U9.9 (B2), U10.5 (Q2)
D0_3: D16.2 (A), U9.8 (B3), U10.6 (Q3)
D1_0: D9.2 (A), U7.11 (B0), U8.3 (Q0)
D1_1: D10.2 (A), U7.10 (B1), U8.4 (Q1)
D1_2: D11.2 (A), U7.9 (B2), U8.5 (Q2)
D1_3: D12.2 (A), U7.8 (B3), U8.6 (Q3)
D2_0: D5.2 (A), U5.11 (B0), U6.3 (Q0)
D2_1: D6.2 (A), U5.10 (B1), U6.4 (Q1)
D2_2: D7.2 (A), U5.9 (B2), U6.5 (Q2)
D2_3: D8.2 (A), U5.8 (B3), U6.6 (Q3)
D3_0: D1.2 (A), U3.11 (B0), U4.3 (Q0)
D3_1: D2.2 (A), U3.10 (B1), U4.4 (Q1)
D3_2: D3.2 (A), U3.9 (B2), U4.5 (Q2)
D3_3: D4.2 (A), U3.8 (B3), U4.6 (Q3)
Data0: J1.27, U3.3 (A0), U4.14 (D0), U5.3 (A0), U6.14 (D0), U7.3 (A0), U8.14 (D0), U9.3 (A0), U10.14 (D0)
Data1: J1.28, U3.4 (A1), U4.13 (D1), U5.4 (A1), U6.13 (D1), U7.4 (A1), U8.13 (D1), U9.4 (A1), U10.13 (D1)
Data2: J1.29, U3.5 (A2), U4.12 (D2), U5.5 (A2), U6.12 (D2), U7.5 (A2), U8.12 (D2), U9.5 (A2), U10.12 (D2)
Data3: J1.30, U3.6 (A3), U4.11 (D3), U5.6 (A3), U6.11 (D3), U7.6 (A3), U8.11 (D3), U9.6 (A3), U10.11 (D3)
GND: C1.2, C2.2, C3.2, C4.2, C5.2, C6.2, C7.2, C8.2, C9.2, C10.2, J1.17, JP1.3 (B), JP2.3 (B), RN1.1 (common), RN2.1 (common), RN3.1 (common), RN4.1 (common), RN6.1 (common), U1.10 (GND), U2.10 (GND), U3.7 (GND), U4.1 (Oe1), U4.2 (Oe2), U4.8 (GND), U5.7 (GND), U6.1 (Oe1), U6.2 (Oe2), U6.8 (GND), U7.7 (GND), U8.1 (Oe1), U8.2 (Oe2), U8.8 (GND), U9.7 (GND), U10.1 (Oe1), U10.2 (Oe2), U10.8 (GND)
JP2: JP2.2 (C), U1.5 (I5), U2.6 (I6)
JP3: JP1.2 (C), U1.3 (I3), U2.4 (I4)
unnamed: D1.1 (K), RN1.2 (R1)
unnamed: D2.1 (K), RN1.3 (R2)
unnamed: D3.1 (K), RN1.4 (R3)
unnamed: D4.1 (K), RN1.5 (R4)
unnamed: D5.1 (K), RN2.2 (R1)
unnamed: D6.1 (K), RN2.3 (R2)
unnamed: D7.1 (K), RN2.4 (R3)
unnamed: D8.1 (K), RN2.5 (R4)
unnamed: D9.1 (K), RN3.2 (R1)
unnamed: D10.1 (K), RN3.3 (R2)
unnamed: D11.1 (K), RN3.4 (R3)
unnamed: D12.1 (K), RN3.5 (R4)
unnamed: D13.1 (K), RN4.2 (R1)
unnamed: D14.1 (K), RN4.3 (R2)
unnamed: D15.1 (K), RN4.4 (R3)
unnamed: D16.1 (K), RN4.5 (R4)
unnamed: D17.2 (A), RN5.2 (R1)
unnamed: D18.2 (A), RN5.3 (R2)
unnamed: D19.2 (A), RN5.4 (R3)
unnamed: D20.2 (A), RN5.5 (R4)
unnamed: D21.1 (K), RN6.2 (R1)
unnamed: D22.1 (K), RN6.3 (R2)
unnamed: D23.1 (K), RN6.4 (R3)
unnamed: D24.1 (K), RN6.5 (R4)
unnamed: D25.2 (A), R1.2
unnamed: D26.2 (A), R2.2
OE0: D24.2 (A), U2.13 (IO7), U9.13 (OEb)
OE1: D23.2 (A), U2.14 (IO6), U7.13 (OEb)
OE2: D22.2 (A), U2.15 (IO5), U5.13 (OEb)
OE3: D21.2 (A), U2.16 (IO4), U3.13 (OEb)
RA0: J1.4, U2.8 (I8)
RA1: J1.3, U2.7 (I7)
RA2: J1.2, U2.5 (I5)
RA3: J1.1, U2.3 (I3)
RB0: J1.8, U1.7 (I7)
RB1: J1.7, U1.6 (I6)
RB2: J1.6, U1.4 (I4)
RB3: J1.5, U1.2 (I2)
RST: U1.17 (I03), U4.15 (Mr), U6.15 (Mr), U8.15 (Mr), U10.15 (Mr)
~ABS~: D25.1 (K), U2.12 (IO8)
~AOE~: J1.25, U2.9 (I9)
~BBS~: D26.1 (K), U1.12 (IO8)
~LD0~: D20.1 (K), U1.13 (IO7), U10.9 (E1), U10.10 (E2)
~LD1~: D19.1 (K), U1.14 (IO6), U8.9 (E1), U8.10 (E2)
~LD2~: D18.1 (K), U1.15 (IO5), U6.9 (E1), U6.10 (E2)
~LD3~: D17.1 (K), U1.16 (IO4), U4.9 (E1), U4.10 (E2)
~LDB~: J1.24, U1.8 (I8)
~RESET~: J1.20, U1.9 (I9)
