lafehubert/electronics/(commit log)

2019-12-07 Adding slow-clock module for ya4b
    [slow-clock-B_Cu.gbr, slow-clock-B_Mask.gbr, slow-clock-B_SilkS.gbr, slow-clock-Edge_Cuts.gbr, slow-clock-F_Cu.gbr, slow-clock-F_Mask.gbr, slow-clock-F_SilkS.gbr, slow-clock-NPTH.drl]
2019-12-26 Adding YA4b stuff
    [ram-32-word-B_Cu.gbr, ram-32-word-B_Mask.gbr, ram-32-word-B_Paste.gbr, ram-32-word-B_SilkS.gbr, ram-32-word-Edge_Cuts.gbr, ram-32-word-F_Cu.gbr, ram-32-word-F_Mask.gbr, ram-32-word-F_Paste.gbr]
2019-12-26 Cleanup up unnecessary files
    [ram-32-word-B_Cu.gbr, ram-32-word-B_Mask.gbr, ram-32-word-B_Paste.gbr, ram-32-word-B_SilkS.gbr, ram-32-word-Edge_Cuts.gbr, ram-32-word-F_Cu.gbr, ram-32-word-F_Mask.gbr, ram-32-word-F_Paste.gbr]
2019-12-30 First cut at address register; checking in, but design is wrong; need 74LS169 chips for this.
    [address-register-tests.ino]
2020-02-15 Added transfer-register Added address-register Added data-register Fixed a mislabeling on ram board.
    [address-register-bank-B_Cu.gbr, address-register-bank-B_Mask.gbr, address-register-bank-B_Paste.gbr, address-register-bank-B_SilkS.gbr, address-register-bank-Edge_Cuts.gbr, address-register-bank-F_Cu.gbr, address-register-bank-F_Mask.gbr, address-register-bank-F_Paste.gbr]
2020-02-22 Adding data register schematics; updated a few things, too.
    [data-register-bank-B_Cu.gbr, data-register-bank-B_Mask.gbr, data-register-bank-B_Paste.gbr, data-register-bank-B_SilkS.gbr, data-register-bank-Edge_Cuts.gbr, data-register-bank-F_Cu.gbr, data-register-bank-F_Mask.gbr, data-register-bank-F_Paste.gbr]
2020-03-11 Updated schematic and pcb for data register bank; data pins were off by one
    [data-register-bank-B_Cu.gbr, data-register-bank-B_Mask.gbr, data-register-bank-B_Paste.gbr, data-register-bank-B_SilkS.gbr, data-register-bank-Edge_Cuts.gbr, data-register-bank-F_Cu.gbr, data-register-bank-F_Mask.gbr, data-register-bank-F_Paste.gbr]
2020-04-11 Adding tests; fixed PCB design files
    [address-register-bank-tests.ino]
2020-04-11 Fixed PCB design files for address register bank
    [address-register-bank-B_Cu.gbr, address-register-bank-B_Mask.gbr, address-register-bank-B_Paste.gbr, address-register-bank-B_SilkS.gbr, address-register-bank-Edge_Cuts.gbr, address-register-bank-F_Cu.gbr, address-register-bank-F_Mask.gbr, address-register-bank-F_Paste.gbr]
2020-04-27 Made a patched version of the data register bank output control GAL because of an error on the PCB design.
    Created a design for the ALU in Digital that seems to work.
    [data-register-bank.kicad_pcb, data-register-control-output-patched.sch]
2020-06-12 Finished ALU simulation/design; all breadboarded; ready for PCB design
2022-01-08 Updated designs and simulations
    [internal-cpu.kicad_pcb, internal-cpu.sch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]
