lafehubert/electronics/(notices)

Notices in the files:
ya4b/transfer-register/transfer-register-board/transfer-register-board.kicad_pcb:
© 2020 Gregory Martin
ya4b/ram-32-word/ram-32-word.kicad_pcb:
© 2019 Gregory Martin
